agustinlezcano/PFE/Robot/Robot_Arm_MK2_Plus__Stepper_Motor_in_Used__2520572/README.txt

Robot Arm MK2 Plus (Stepper Motor in Used) by jackyltle on Thingiverse: https://www.thingiverse.com/thing:2520572
