agustinlezcano/PFE/Informe/PFE_Informe.pdf

img/FING.PNG

img/Escudo_uncuyo.jpg

## Proyecto Final de Estudios

## Ingeniería en Mecatronica ´

## Facultad de Ingeniería - Universidad Nacional de Cuyo

# Robot Paralelo Pick-and-Place con vision´ artificial para la preparacion de pedidos ´

## Director: Ing. Eric Sanchez

## Emanuel Agüero, Agustín Lezcano Mendoza, Argentina

## Agradecimientos

A nuestras familias y seres queridos, por acompanarnos en cada paso de este trayecto con ˜ paciencia y carino incondicional. ˜

A nuestros companeros y futuros colegas, con quienes transitamos aulas y pasillos. ˜

A nuestro Director de Proyecto, Eric Sanchez, por su generosa guía y por representar para nosotros un referente de integridad y vocacion profesional. ´

A la universidad publica, que nos brind ´ | o las herramientas y el espacio para formarnos como ´
profesionales al servicio de la sociedad.
A la Asociacion de Mecatr ´ | onica, que nos brind ´ | o un espacio para compartir ideas y aprender ´
entre companeros. ˜

## Resumen

Se desarrollo un sistema rob ´ | otico paralelo pick-and-place capaz de detectar y trasladar objetos ´
utilizando vision artificial. El proyecto integra cinem ´ | atica, control de movimiento, planificaci ´ | on de ´
trayectorias y un sistema de vision que identifica objetos en una cinta transportadora simulada. La ´
comunicacion entre los m ´ | odulos se implement ´ | o con ROS2, coordinando el procesamiento de visi ´ | on´
y el control del STM32.
Palabras clave: Robot paralelo, pick-and-place, cinematica, Denavit-Hartenberg, visi ´ | on artificial, ´
YOLOv11, ROS2.

## Abstract

A parallel pick-and-place robotic system capable of detecting and moving objects using artificial vision was developed. The project integrates kinematics, motion control, trajectory planning, and a vision system that identifies objects on a simulated conveyor belt. Communication between modules was implemented with ROS2, coordinating vision processing and STM32 control.

Keywords: Parallel robot, pick-and-place, kinematics, Denavit-Hartenberg, artificial vision, YO-LOv11, ROS2.

## Índice

1. Introduccion´ | 7
2. Objetivos | 7
3. Estado del arte | 8
4. Funcionamiento general | 9
5. Herramientas utilizadas en el proyecto | 10
6. Diagrama de conexiones | 11
7. Descripcion del hardware ´ | 12
8. Esquema tecnologico ´ | 15
9. Cinematica ´ | 16
10. Mejoras mecanicas ´ | 20
11. Circuito electronico del electroim ´ | an´ | 24
12. Vision artificial ´ | | 25

13. Desarrollo del Firmware | 31
14. Integracion de ROS, microROS y FreeRTOS en Sistemas Embebidos ´ | 36
15. Ensayos realizados | 44
16. Futuras mejoras | 57
17. Conclusiones | 59
18. Anexo | 61

## Índice de figuras

1. | Robots con vision artificial ´ | | | | 8
2. | Foto real del Robot | | 9
3. | Diagrama de conexiones | | 11
4. | Microcontrolador STM32 Núcleo | | 12
5. | Placa CNC Shield | | 12
6. | Driver DRV8825 con sus conexiones | | 13
7. | Modos de conexion para realizar micropasos ´ | | | | 13
8. | Modulo de encoder magn ´ | etico AS5600 ´ | | | 14
9. | Modulo de encoder magn ´ | etico AS5600 ´ | | | 15
10. Multiplexor I²C TCA9548A | | 15
11. Diagrama general | | 16
12. Referencias del metodo geom ´ | etrico ´ | | | 18
13. Esquema de eslabones simplificado | | 18
14. Dimensiones de interes para c ´ | alculo de ´ | q4 | | 19
15. Comparacion vista lateral de versi ´ | on con servo vs con motores Paso a Paso ´ | | | 20
16. Comparacion vista en perspectiva de versi ´ | on con servo vs con motores Paso a Paso ´ | 21
17. Alineamiento axial entre sensor AS5600 e iman montado sobre eje de articulaci ´ | on´ . | 24
18. Esquematico y placa electr ´ | onica de control del solenoide ´ | | | 25
19. Imagenes del dataset ´ | | | 26
20. Prediccion de modelo YOLOv11 ´ | | | 28
21. Curvas de resultado de inferencia de YOLOv11n | | 29
22. Esquema de posicion Robot-C ´ | amara-Objeto ´ | | | 31
23. Posiciones, velocidades y aceleraciones del parametro ´ | s | | 35
24. Posiciones, velocidades y aceleraciones articulares | | 35
25. Trayectoria en el espacio de trabajo interpolada con B-Spline | | 36
26. Grafico de nodos ROS ´ | | | 37
27. Mapa conceptual de las conexiones entre el orquestador y el esclavo | | 39
28. Diagrama de conexiones entre nodos | | 41
29. Flujo de datos en trayectorias | | 43
30. Espacio de trabajo teorico ´ | | | 47
31. Espacio de trabajo articular con restriccion´ z = 0 | | 47
32. Espacio de trabajo articular (Zoom) | | 48
33. Espacio de trabajo real, plano XZ | | 48
34. Ensayo de calibracion para obtener relaci ´ | on mm/px ´ | | | 49
35. Ensayo de deteccion de herramientas y posicionamiento respecto origen del robot ´ | . | 50
36. Comparacion de trayectorias real y te ´ | orica con sus respectivas ganancias ´ | | | 52
37. Errores de posicion con sus respectivas ganancias ´ | | | 53
38. Interfaz de usuario | | 55
39. Foto real del robot realizando pick-and-place | | 56
40. Triangulo general donde se aplica el Teorema del Coseno. ´ | | | 61
41. Funcionamiento de colas | | 62
42. Interfaces internas de ROS | | 63

## Índice de tablas

1. | Parametros Denavit-Hartenberg ´ | | | | | 16
2. | Frecuencias de PWM y velocidades en motores/eslabones | | 32
3. | Descripcion de t ´ | opicos m ´ | as relevantes ´ | | | 42
4. | Comparacion de m ´ | aximos valores absolutos de errores en la trayectoria respecto a ´ | Kp | 51
5. | Protocolo de inicio para el sistema distribuido ROS2 / microROS | | 54

Proyecto Final de Estudios, 2026

img/Escudo_uncuyo.jpg

1 | 1. Introduccion´
2 | El proyecto desarrollado consiste en el diseno e implementaci ˜ | on de un sistema rob ´ | otico paralelo ´
3 | para operativa pick-and-place, cuyo objetivo principal es trasladar objetos desde un punto inicial
4 | (A) hasta un punto final (B) a partir de su deteccion mediante t ´ | ecnicas de visi ´ | on artificial. El sistema ´
5 | esta orientado a manipular objetos que arriban desde lo que se simula ser una cinta transportadora, ´
6 | identificarlos dentro del espacio de trabajo y posicionarlos de manera precisa en un contenedor
7 | correspondiente a un pedido, simulando un flujo típico de procesos logísticos modernos.
8 | Para esto, se realizo la modificaci ´ | on estructural y funcional de un robot modelo MK2, reempla- ´
9 | zando sus servomotores originales por motores Paso a Paso en todas sus articulaciones, con el fin
10 | de mejorar la precision de posicionamiento y el control del movimiento. El efector final incorpora ´
11 | un electroiman que permite la sujeci ´ | on de piezas met ´ | alicas durante el ciclo operativo. ´
12 | El desarrollo abarca múltiples areas: la modificaci ´ | on estructural hacia motores Paso a Paso; ´
13 | el calculo de la cinem ´ | atica directa e inversa del manipulador; la integraci ´ | on y calibraci ´ | on de los ´
14 | motores; y la planificacion de trayectorias que permitan un movimiento suave, eficiente y seguro del ´
15 | robot. Asimismo, se integra un sistema de vision artificial basado en algoritmos de inferencia para ´
16 | la deteccion y localizaci ´ | on de objetos en el entorno. ´
17 | Finalmente, se implementa una arquitectura de comunicacion mediante ´ | ROS2, por medio de la
18 | cual se establecen nodos dedicados a la interaccion entre la computadora encargada del procesa- ´
19 | miento de vision y el env ´ | ío de consignas de posicion, y el microcontrolador STM32 responsable del ´
20 | control de los motores. Esta infraestructura permite el intercambio confiable de informacion entre ´
21 | los distintos modulos del sistema y constituye la base para la coordinaci ´ | on del proceso completo de ´
22 | manipulacion rob ´ | otica. ´
23 | 2. Objetivos
24 | Se busca llegar a un prototipo funcional, y que el sistema este modularizado de tal manera que ´
25 | el proyecto pueda ser continuado por otros alumnos interesados. Este desarrollo, enmarcado en el
26 | Proyecto Final de Estudios, se realizo con recursos del laboratorio ´ | Rosetta. (https://ingenieria.uncuyo.edu.ar/laboratorio-de-robotica-de-servicio-teleoperacion-y-tecnologias-aplicadas-rosetta)
27 | Tambien, a tener un software bien definido y robusto para que luego se pueda cambiar el robot, ´
28 | si así se desea, y el enfoque del trabajo sea en el hardware o en la parte mecanica, quitando el peso ´
29 | de realizar un trabajo desde cero. Los objetivos específicos se listan a continuacion: ´
30 | Implementacion y desarrollo del firmware de bajo nivel para el control de cada motor. ´
31 | | Desarrollo basado en la extensibilidad y flexibilidad del codigo para un posible desarrollo ´
32 | futuro.
33 | Utilizacion del protocolo MQTT para la comunicaci ´ | on entre usuarios y servidor, de manera ´
34 | | que se pueda expandir facilmente el número de usuarios del sistema. ´
35 | Integracion de los subsistemas de control y env ´ | ío/recepcion de consignas. ´
36 | Diseno de un algoritmo de Visi ˜ | on Artificial para la detecci ´ | on de objetos. ´
37 | | Posicionamiento para cumplir con los pedidos y confirmacion de tarea completada. ´

38 | 3. Estado del arte
39 | En los últimos anos, la integraci ˜ | on de visi ´ | on artificial en sistemas rob ´ | oticos industriales ha ´
40 | impulsado manipuladores mas aut ´ | onomos, precisos y adaptables, destac ´ | andose diversos desarrollos ´
41 | que han marcado el rumbo de esta tecnología, como se muestra en la Figura 1.
42 | Dex-Net (UC Berkeley) ha sido una de las referencias mas influyentes en el ´ | area. Su contri- ´
43 | bucion principal se basa en el uso de grandes bases de datos sint ´ | | | eticas para entrenar redes ´
44 | neuronales capaces de predecir puntos de agarre fiables incluso en objetos desconocidos. Es-
45 | te enfoque demostro que la simulaci ´ | on masiva combinada con ´ | deep learning puede ofrecer
46 | soluciones robustas para tareas de bin picking.
47 | DoraPicker (Dora Robotics) se orienta al ambito log ´ | ístico, integrando vision 3D y algoritmos ´
48 | de segmentacion para identificar y extraer objetos variados de estanter ´ | | | ías o contenedores. Su
49 | arquitectura evidencia la viabilidad de sistemas completamente autonomos para manipular ´
50 | productos de diferentes formas y tamanos. ˜
51 | Cartman, desarrollado para el Amazon Robotics Challenge, propone un diseno cartesiano ˜
52 | combinado con algoritmos de reconocimiento y planificacion eficientes. Su participaci ´ | on´
53 | demostro que una integraci ´ | on cuidadosa entre percepci ´ | on y mec ´ | anica puede mejorar la con- ´
54 | fiabilidad en la manipulacion de objetos desordenados o deformables. ´
55 | Cambrian Vision representa un enfoque industrial consolidado, ofreciendo modulos de visi ´ | on´
56 | 3D y algoritmos de IA listos para su incorporacion en l ´ | íneas de produccion. Su fortaleza est ´ | á
57 | en la deteccion r ´ | apida y la reducci ´ | on del tiempo de configuraci ´ | on por parte del operador. ´

img/robot1.png

(a) Robot Dex-Net

img/robot2.png

(b) Robot DoraPicker

img/robot3.png

(c) Robot Cartman

img/robot4.png

(d) Robot Cambrian Vision

Figura 1: Robots con vision artificial ´

58 | 4. Funcionamiento general
59 | El funcionamiento integral del sistema robotico desarrollado se basa en la interacci ´ | | on coordinada ´
60 | entre tres modulos principales: el sistema de visi ´ | on artificial, el orquestador, y el robot f ´ | ísico equipado
61 | con motores Paso a Paso (ver Figura 2). Cada uno de estos componentes cumple un rol esencial
62 | dentro del ciclo operativo del robot pick-and-place, permitiendo que el flujo completo (desde la
63 | deteccion del objeto hasta su deposici ´ | on final) se lleve a cabo de manera precisa, repetible y segura. ´

img/robot_real.jpg

Figura 2: Foto real del Robot

64 | En primer lugar, el proceso se inicia con la captura de imagenes de la zona de trabajo mediante ´
65 | una camara montada en una posici ´ | on fija y debidamente calibrada respecto al robot. Esta c ´ | amara ´
66 | observa el area donde los objetos -provenientes de una simulaci ´ | on de cinta transportadora- ingresan ´
67 | al campo visual. A partir de estas imagenes, un modelo de visi ´ | on artificial ejecuta un algoritmo de ´
68 | inferencia que identifica cada pieza de interes y determina la posici ´ | on bidimensional del centro de ´
69 | su bounding-box. Esta localizacion inicial se encuentra en coordenadas de imagen (p ´ | | íxeles), por lo
70 | que, mediante la utilizacion de un factor de conversi ´ | on mm/px obtenido en la etapa de calibraci ´ | on´
71 | geometrica, se transforma dicha posici ´ | on al sistema de referencia f ´ | ísico del robot. Adicionalmente,
72 | la altura (Z) del objeto se obtiene a partir de una base de datos que asocia cada categoría detectada
73 | con su correspondiente dimension real. ´
74 | Una vez determinada la ubicacion tridimensional del objeto, esta informaci ´ | on es transmitida ´

75 | al modulo de planificaci ´ | on de movimiento implementado sobre la computadora principal, donde ´
76 | existe un orquestador que utiliza microROS para enviar comandos de posicion al robot mediante ´
77 | comunicacion serial. Actualmente, se utiliza el env ´ | ío de consignas articulares, pero el robot es capaz
78 | de resolver la cinematica inversa y dar consigna a los motores. Adem ´ | as se env ´ | ían los comandos de
79 | homing y parada de emergencia.
80 | El microcontrolador es capaz de realizar los calculos de cinem ´ | atica directa e inversa del robot ´
81 | paralelo, permitiendo definir los angulos articulares requeridos para alcanzar tanto la posici ´ | on de ´
82 | recogida como la posicion final donde el objeto ser ´ | a depositado. Para garantizar movimientos suaves ´
83 | y evitar esfuerzos innecesarios sobre la estructura, cada articulacion sigue un perfil de velocidad que ´
84 | asegura aceleraciones y desaceleraciones controladas y limitadas a las velocidades y aceleraciones
85 | maximas de los motores. Este enfoque permite un desplazamiento eficiente, reduciendo vibraciones ´
86 | y mejorando la repetibilidad del posicionamiento.
87 | El control de los motores Paso a Paso se realiza a traves del microcontrolador STM32, el ´
88 | cual recibe las consignas articulares mediante nodos de comunicacion basados en ROS2. Esta ´
89 | arquitectura distribuida facilita el intercambio de mensajes entre los distintos modulos, desacoplando ´
90 | el procesamiento intensivo de vision del control de bajo nivel de los actuadores. El STM32 se ´
91 | encarga de generar las senales de paso y direcci ˜ | on, ejecutar los perfiles de velocidad y supervisar el ´
92 | cumplimiento temporal de cada trayectoria articulada.
93 | Finalmente, el efector final equipado con un electroiman realiza la sujeci ´ | on y liberaci ´ | on de las ´
94 | piezas metalicas durante el ciclo de trabajo. Una vez que el robot alcanza la posici ´ | | | on de destino, ´
95 | el sistema desactiva el electroiman para depositar el objeto en el contenedor asignado. Con esto ´
96 | concluye el ciclo operativo, tras lo cual el robot retorna a una posicion segura de espera, quedando ´
97 | preparado para procesar el siguiente objeto detectado.
98 | Se decidio utilizar ROS (Robot Operating System) en su versi ´ | on 2 debido a su amplia adopci ´ | on´
99 | tanto en el ambito acad ´ | emico como en la industria, donde se perfila como un est ´ | | andar de facto. Al ´
100 | tratarse de una plataforma open-source y multiplataforma, cuenta con una comunidad activa y extensa
101 | que garantiza su mantenimiento, evolucion y actualizaci ´ | on continua. Pese a su nombre, no es un ´
102 | sistema operativo sino un SDK (Software Development Kit). Este conjunto de librerías y herramientas
103 | proporciona una arquitectura altamente modular, permitiendo desarrollar componentes para distintas
104 | plataformas y en diversos lenguajes de programacion. Dado que ROS2 es agn ´ | ostico al lenguaje, el ´
105 | desarrollador puede concentrarse en la logica de aplicaci ´ | on, mientras que la infraestructura de ´
| comunicacion entre m ´ | odulos es gestionada de manera transparente por ROS2 ´

1
106 | .
107 | 5. Herramientas utilizadas en el proyecto
108 | Para el desarrollo integral del proyecto se emplearon un conjunto de herramientas de diseno, ˜
109 | hardware y software que permitieron abordar de manera coordinada los distintos aspectos mecanicos, ´
110 | electronicos y de control del sistema. ´
111 | Mecanica: ´ | El diseno estructural del robot se realiz ˜ | o principalmente en ´ | Solid Edge, donde
112 | se modelaron las piezas individuales y se verifico el ensamblaje completo del robot. Para el ´
113 | diseno espec ˜ | ífico de engranajes se utilizó Fusion 360 y OrcaSlicer como laminador de las
114 | piezas impresas en 3D.
115 | Hardware: El sistema de control se basa en el microcontrolador STM32F446RE, junto con
116 | una placa CNC Shield para el control de motores Paso a Paso. La medicion de posici ´ | on angular ´
1En el anexo 18.3 hay mas informaci ´ | on acerca de la infraestructura ROS ´

117 | en cada articulacion se realiz ´ | o mediante sensores magn ´ | eticos ´ | AS5600, conectados a traves de ´
un multiplexor I²
118 | C TCA9548A, permitiendo la lectura de múltiples dispositivos con una única
119 | interfaz de comunicacion. ´
120 | Software: La programacion del microcontrolador se desarroll ´ | o en ´ | STM32CubeIDE, donde
121 | se configuraron perifericos, temporizadores y tareas en tiempo real. El modelado y an ´ | | | | alisis ´
122 | cinematico inicial del robot, as ´ | í como la verificacion del espacio de trabajo, se llevaron a cabo ´
123 | en MATLAB. La implementacion de la cinem ´ | atica inversa, la planificaci ´ | on de trayectorias y la ´
124 | comunicacion mediante sockets con el m ´ | odulo de visi ´ | on se desarrollaron en ´ | Python, integrando
125 | estos procesos dentro del orquestador del sistema. Para la deteccion de piezas y determinaci ´ | on´
126 | del punto objetivo se utilizo el modelo ´ | YOLOv11n, entrenado con un dataset propio de piezas.
127 | El diseno de la placa electr ˜ | onica destinada al control del electroim ´ | an se realiz ´ | o en ´ | KiCad,
128 | incluyendo el esquematico y el ruteo de la PCB. Por último, se emple ´ | ó microROS, que corre
129 | sobre FreeRTOS, el sistema operativo en tiempo real sobre el microcontrolador. Tambien del ´
130 | lado de la computadora, se tiene a ROS2, que actuo como orquestador general del proyecto y ´
131 | permitio estructurar la comunicaci ´ | on entre los distintos m ´ | odulos del sistema. ´
132 | 6. Diagrama de conexiones
133 | El sistema se encuentra compuesto por una placa de desarrollo STM32F446RE, sobre la que
134 | se encuentra montada una CNC Shield para la conexion de drivers ´ | DRV8825 de 3 motores Paso a
135 | Paso, 3 sensores AS5600 para la medicion de ´ | angulos absolutos mediante efecto Hall, un multiplexor ´
TCA9548A que permite gestionar múltiples dispositivos I²
136 | | | C con direcciones identicas en un mismo ´
137 | bus, y una placa electronica propia que permite la alimentaci ´ | on segura hacia el electroim ´ | an. ´
138 | En la Figura 3 se puede observar el diagrama de conexiones con todos los elementos mencionados.
139 | Cabe aclarar que la placa electronica para el accionamiento del electroim ´ | an se ha representado con ´
140 | un transistor NPN.

img/DiagramaConex.png

Figura 3: Diagrama de conexiones

141 | 7. Descripcion del hardware ´
142 | 7.1. Microcontrolador STM32F446RE
143 | La placa Nucleo-F446RE (ver Figura 4) incorpora el microcontrolador STM32F446RE de 32
144 | bits, basado en arquitectura ARM Cortex-M4 de hasta 180 MHz, con 512 KB de memoria Flash
145 | y 128 KB de SRAM. Esta placa ofrece una amplia disponibilidad de perifericos de comunicaci ´ | on´
(UART, SPI, I²
146 | C, CAN) y una distribucion de pines compatible con el formato Arduino, lo que ´
147 | facilita la integracion con expansiones como la ´ | CNC Shield. El microcontrolador se encarga de la
generacion de se ´ | nales PWM, la lectura de sensores por I ˜

2
148 | C, y la gestion del sistema de control. ´

img/STM32NUCLEO.jpg

Figura 4: Microcontrolador STM32 Núcleo

149 | 7.2. CNC Shield
150 | La CNC Shield (ver Figura 5) utilizada es una expansion dise ´ | nada originalmente para placas ˜
151 | Arduino UNO, pero resulta compatible con la placa Nucleo-F446RE gracias a su distribucion de ´
152 | pines y niveles logicos de 3.3 V – 5 V. Esta placa permite la conexi ´ | on directa de drivers de motores ´
153 | Paso a Paso, ofreciendo pines dedicados para STEP, DIR, y EN. Ademas, dispone de bornes para ´
154 | alimentacion externa, jumpers para configuraci ´ | on de micropasos, y conectores auxiliares para finales ´
155 | de carrera. De esta forma, el STM32 puede controlar varios motores Paso a Paso mediante salidas
156 | digitales dedicadas, sin necesidad de circuitos adicionales.

img/cnc_shield.jpg

Figura 5: Placa CNC Shield

157 | 7.3. Driver de motores
158 | El modulo ´ | DRV8825 (ver Figura 6a) se utiliza como driver para el control de motores Paso
159 | a Paso bipolares desde el STM32. Este dispositivo integra la electronica necesaria para generar ´
160 | las secuencias de corriente requeridas por las bobinas del motor, permitiendo controlar tanto la
161 | direccion de giro como el avance por pasos mediante dos se ´ | nales digitales de entrada: ˜ | DIR y STEP,
162 | respectivamente. Incorpora un regulador de corriente ajustable mediante un potenciometro integrado, ´
163 | que permite limitar la corriente maxima por fase del motor, protegiendo al mismo y al driver ante ´
164 | sobrecorrientes. Para determinar el valor de corriente maxima por bobina ( ´ | Imax), se debe medir con
165 | un voltímetro la tension de referencia ´ | Vre f entre el terminal del potenciometro y masa ( ´ | GND), y luego
166 | aplicar la relacion aproximada: ´
Imax = 2 · Vre f | (1)
167 | Esta ecuacion constituye una aproximaci ´ | on útil para el dimensionamiento inicial, aunque el valor ´
168 | real puede variar ligeramente según tolerancias y condiciones de operacion. ´
169 | La conexion general del ´ | DRV8825 con el sistema se muestra en la Figura 6b, donde se detallan
170 | las entradas de control, las salidas hacia el motor y la alimentacion. Asimismo, en la Figura ´ | 7 se
171 | ilustran las configuraciones de los pines MODE0, MODE1 y MODE2 que permiten seleccionar el modo
172 | de micropaso deseado. Para este proyecto se conectaron los pines MODE0 y MODE1 al voltaje de
173 | alimentacion del microcontrolador para activar el modo de 1/8 de paso. ´

img/drv8825.jpg

(a) Driver DRV8825

img/drv8825conections.png

(b) Conexiones DRV8825

Figura 6: Driver DRV8825 con sus conexiones

img/drv8825_modes.jpg

Figura 7: Modos de conexion para realizar micropasos ´

174 | 7.4. Sensor de angulo ´
175 | Para la medicion del ´ | angulo de cada eslab ´ | on se seleccion ´ | o el sensor ´ | AS5600 (ver Figura 8).
176 | Este dispositivo corresponde a un sensor de posicion angular sin contacto, basado en el principio ´
177 | de deteccion del campo magn ´ | etico generado por un im ´ | an colocado sobre el eje de rotaci ´ | on. El ´
178 | sensor determina la orientacion del campo magn ´ | etico y entrega la posici ´ | on angular absoluta con ´
179 | una resolucion de 12 bits, equivalente a 4096 pasos por revoluci ´ | on. La elecci ´ | on de este sensor se ´
baso en su alta resoluci ´ | on, facilidad de lectura mediante el bus I ´

2
180 | | | | | C y buena inmunidad al ruido
181 | electromagnetico. ´

img/AS5600.png

Figura 8: Modulo de encoder magn ´ | etico AS5600 ´
182 | Sus principales características son:
Resolucion: ´ | 12 bits (4096 pasos/rev), equivalente a aproximadamente 0,0879◦
183 | /paso

Rango angular: programable; por defecto cubre 0–360◦
184 | . Se puede configurar el angulo ´
185 | maximo ( ´ | MANG) y la posicion cero ( ´ | ZPOS)
186 | Interfaces:
- I
2
187 | C con direccion fija de 7 bits ´ | 0x36.
188 | • Salida PWM, donde el ciclo de trabajo representa el angulo medido (frecuencia configu- ´
189 | rable por registro)

Velocidad del bus I²
190 | C: hasta 400 kHz
191 | En el montaje de los ejes se instalo un im ´ | an de neodimio en el extremo de cada eje, ubicado ´
frente al sensor AS5600 de manera centrada. Se opto por utilizar el protocolo I ´

2
192 | C por la fiabilidad
193 | en la medicion y velocidad del bus. El valor angular bruto ( ´ | raw) entregado por el modulo a trav ´ | es´
de I²
194 | C varía entre 0 y 4095, representando el rango completo de 0° a 360° de manera proporcional.
195 | El registro de salida de angulo est ´ | a compuesto por dos bytes ( ´ | MSB y LSB) que conforman el valor
196 | digital de 12 bits. El calculo del ´ | angulo en grados se obtiene mediante la expresi ´ | on: ´

angle deg =

raw
4096

× 360◦ ≈ raw × 0,0879◦
(2)
197 | donde raw ∈ [0, 4095] corresponde al valor digital leído del registro de salida.
198 | En la Figura 9 se observa una representacion esquem ´ | atica del im ´ | an con sus polos (Norte y ´
Sur) frente al sensor. Puede observarse que para un angulo de 0 ´

◦
199 | el sensor entrega un valor de

RAW ANGLE = 0, para 90◦

el valor es RAW ANGLE = 1024, para 180◦
200 | | RAW ANGLE = 2048, y para
| 270◦ RAW ANGLE = 3072. Cabe destacar que 360◦

coincide con 0◦

| | , y que las posiciones 0◦–180◦
201 | y
90◦–270◦
202 | presentan polaridades magneticas invertidas, evitando as ´ | í ambigüedades en la deteccion´
203 | de posicion. ´

img/AS5600_polos_magneticos.png

Figura 9: Modulo de encoder magn ´ | etico AS5600 ´
204 | 7.5. Multiplexor I2C TCA9548A
| El TCA9548A (ver Figura 10) es un multiplexor I²
205 | C de 8 canales independientes que permite
| conectar hasta ocho dispositivos I²
206 | C con direcciones repetidas, seleccionando el canal activo me-
207 | diante comandos enviados desde el microcontrolador principal. Cada canal actúa como una línea
I

2
208 | C aislada (SDA y SCL), evitando conflictos de direccion entre sensores id ´ | enticos como el AS5600. ´
| El STM32 se comunica con el TCA9548A mediante su interfaz I²
209 | | C principal, y activa cada canal
210 | según el sensor que se desea leer. Este componente amplía la escalabilidad del sistema, permitiendo
211 | el uso de múltiples sensores sin modificar el hardware base.

img/tca9548a.jpg

Figura 10: Multiplexor I²C TCA9548A

212 | 8. Esquema tecnologico ´
213 | En la Figura 11 se presenta un diagrama general simplificado que presenta los modulos principales ´
214 | del sistema robotico: el de visi ´ | on, el orquestador (que hace uso de la informaci ´ | on del m ´ | odulo de ´
215 | vision) y el brazo rob ´ | otico (que recibe las instrucciones de alto nivel del orquestador y realiza el ´
216 | control a bajo nivel).

img/arquitecturaGralPfe.png

Figura 11: Diagrama general

217 | 9. Cinematica ´
218 | A continuacion se presenta la resoluci ´ | on de los problemas de cinem ´ | atica, fundamentales para ´
219 | poder traducir las consignas en angulos de giro para los motores. Esto se logra mediante la cinem ´ | atica ´
220 | inversa, es decir que se pasa del espacio de trabajo al espacio articular. Para mas profundidad al ´
221 | respecto, se pueden consultar las siguientes referencias: [Barrientos et al., 2007], [Craig, 2006],
222 | [Corke, 2017], [Mark W. Spong, 2005], [Torres et al., 2002].
223 | 9.1. Denavit-Hartenberg
224 | Teniendo en cuenta las dimensiones del robot, se describio la morfolog ´ | ía del mismo siguiendo
225 | la convencion Denavit-Hartenberg. Como resultado, se simplifica la estructura dividiendo al brazo ´
226 | en eslabones (obteniendo la Tabla 1), y se resuelve el problema de la cinematica directa a trav ´ | es´
227 | de transformaciones homogeneas. Para esto se tuvieron en cuenta los eslabones activos; adem ´ | as se ´
228 | considero un eslab ´ | on que actúa como articulaci ´ | on o grado de libertad virtual con el fin de simplificar ´
229 | los calculos (se ver ´ | a el desarrollo en la secci ´ | on´ 9.3). Un desarrollo similar que puede ser consultado
230 | en [Zhou et al., 2020]. La ventaja de usar el metodo Denavit-Hartenberg es que permite simplificar ´
231 | el cambio de posicion y orientaci ´ | on de un punto a otro en una concatenaci ´ | on de movimientos de ´
232 | traslacion y rotaci ´ | on (dos rotaciones y dos traslaciones para cada desplazamiento desde un punto de ´
233 | origen a otro, en el sistema de referencia elegido).
θ | d | a | α
q1 | L1 | 0 | π/2
q2 | 0 | L2 | 0
q3 | 0 | L3 | 0
q4 | 0 | L4 | 0

Tabla 1: Parametros Denavit-Hartenberg ´

234 | 9.2. Cinematica directa ´
235 | Cada “desplazamiento” entre el origen de un sistema de referencia y otro del eslabon siguiente ´
236 | se puede representar mediante una matriz de transformacion homog ´ | enea. ´

i−1Ti = Rot(zi−1, θi) · Tras(zi−1, di) · Tras(xi , ai) · Rot(xi

, αi) | (3)

237 | A su vez, considerando el origen del primer sistema de referencia y el del último (que puede
238 | coincidir con un extremo del robot, donde ira colocada la herramienta de ser necesario), se puede ´
239 | relacionar en el desplazamiento del punto de origen del sistema de referencia al extremo, siguiendo
240 | la formula siguiente: ´

baseTextremo =

base T1 ·

1 T2 · . . . ·

n−1 Tn ·
| | | n Textremo | (4)
241 | 9.3. Cinematica inversa ´
242 | El robot de este proyecto, es de tipo paralelo o de cadena cinematica cerrada. Para la resoluci ´ | on´
243 | de la cinematica inversa, se ha optado por hacer una simplificaci ´ | on y considerar al mismo como ´
244 | cadena cinematica abierta. Como se menciona en la Secci ´ | on´ 9.1, se considera un eslabon virtual. ´
245 | Esta articulacion siempre mantiene la horizontalidad o paralelismo respecto al plano XY sobre el que ´
246 | esta apoyada la base del robot, siempre que el robot se encuentre dentro del espacio de trabajo. Los ´
247 | eslabones pasivos o conducidos se pueden calcular de manera similar, pero no inciden en los calculos ´
248 | para la cinematica inversa. Dado el funcionamiento del robot y para hacer una simplificaci ´ | | | on en los ´
249 | calculos, solo se considera la posici ´ | on del efector final, no la orientaci ´ | on. ´
250 | Se nombran las articulaciones tales como se indican en la Figura12a. Otra cosa a destacar es que
251 | no todas las articulaciones se mueven de manera directa, sino que algunas de ellas son conducidas,
252 | por ejemplo la articulacion 4 depende de los movimientos de las articulaciones anteriores, y la ´
253 | articulacion pasiva 3, depende del movimiento de la articulaci ´ | on activa 3’. Aqu ´ | í se considero que ´
254 | el eslabon 3 comienza en la intersecci ´ | on con el extremo final del eslab ´ | on 2, evitando a ´ | nadir a los ˜
255 | calculos el eslab ´ | on activo y el pasivo vinculados. Se puede ver un detalle de esto en la Figura ´ | 13.
256 | Dadas las limitaciones de movimiento (límites articulares) y la configuracion del robot, que tiene ´
257 | restricciones físicas debido a la cadena cerrada, se llega a tener una única solucion posible para un ´
258 | punto objetivo en el espacio, que es “codo arriba”.
259 | Otra aclaracion es que los ´ | angulos ´ | qi obtenidos no representan los angulos de giro de sus ´
260 | respectivos motores (a excepcion del eslab ´ | on 1), aunque se puede llegar al valor de los mismos ´
261 | facilmente. Se los representar ´ | a con ´ | α y β. Una vez hechas las consideraciones previas, se pasa
262 | a hacer la representacion de los par ´ | ametros Denavit-Hartenberg (ver Tabla ´ | 1). Para la resolucion´
263 | del problema de cinematica inversa, se utiliza el m ´ | etodo geom ´ | etrico. Se considera la estrategia de ´
264 | desacople cinematico [ ´ | Pieper, 1968]. En otras palabras, se separa “brazo” de “muneca”. El m ˜ | etodo ´
265 | utilizado es una adaptacion ya que este m ´ | etodo es v ´ | alido para robots de 6 grados de libertad. Teniendo ´
266 | en cuenta el desacople mencionado anteriormente, se refiere a la posicion de la mu ´ | neca referida a la ˜
267 | posicion del extremo del robot, menos la distancia del eslab ´ | on´ L4 con valor absoluto L4 y orientacion´
268 | x®4. Las variables articulares se indican con qi (i =1,2,3) y corresponden a los eslabones 1, 2 y 3
269 | correspondientes.
| | PM = PF − L4 · ®x4 | | (5)
270 | El primer angulo se obtiene de manera directa según la proyecci ´ | on sobre el eje XY (v ´ | ease Figura ´ | 12b):
| | q1 = arctan 0YM
| | 0XM
| | | | (6)

d =

√︃
1XM

2
+ 1YM

2
(7)

B = arctan

0XM

0YM

(8)

img/esquemaRobot2.png

(a)

img/esquemaRobot3.png

(b)

Figura 12: Referencias del metodo geom ´ | etrico ´
271 | Por el teorema del coseno, si se tienen las longitudes de los eslabones se puede determinar
272 | el angulo entre el eslab ´ | on´ L2 y el vector d que representa la distancia entre PM y el sistema de
273 | referencia 1. Con estos valores se puede calcular el valor de la variable articular q2. Como se indicó
274 | previamente, se elige la disposicion “codo arriba”. ´
| | L3 2 = d 2 + L2
2 − 2 · d · L2 · cos (C) | (9)

C = arc cos
d

2 + L2

2 − L3

2

2 · d · L2

(10)
q2 = B ± C | (11)

img/esquemaRobot1.png

Figura 13: Esquema de eslabones simplificado

275 | Tomando el mismo triangulo generado entre el vector distancia ´ | d, L2 y L3, y haciendo uso del
276 | teorema del coseno, se puede determinar el angulo ´ | ψ, y con este obtener q3.
| d 2 = L2 2 + L3
2 − 2 · L2 · L3 cos (ψ) | (12)
| ψ = arc cos
L2
| | 2 + L3 2 − d
| | 2
| | 2 · L2 · L3
| | (13)
q3 = π − ψ | (14)
277 | Para obtener la posicion del extremo final, se usa el eslab ´ | on´ L4 y se considera un grado de
278 | libertad ficticio, q4, el cual se obtiene de manera similar a las variables articulares anteriores (ver
279 | Figura 14). Para encontrar el vector r que representa la distancia entre el extremo del eslabon 2 y ´
280 | PF, se resuelve algebraicamente:
| 0T1 · 1T2 · 2T3 · 3T4 =

0T4 ⇒ 2PF = (

| | 0T1 · 1T2) −1 ·
0T4 | (15)

r

2 = L3

2 + L4

2 − 2 · L3 · L4 · cos (γ) | (16)

γ = arc cos
L3

2 + L4

2 − r
2

2 · L3 · L4

| (17)
q4 = π − γ | (18)

img/esquemaRobot4.png

Figura 14: Dimensiones de interes para c ´ | alculo de ´ | q4
281 | Cabe destacar que las variables articulares representan de manera teorica los ´ | angulos sucesivos ´
282 | que deben tener los eslabones entre si. Dadas las características constructivas del robot, los angulos ´
283 | de giro de cada motor se calculan de la siguiente manera:
q1m = q1 | (19)

q2m =

π
2
− q2 | (20)
q3m = −(q2 + q3) | (21)

284 | 10. Mejoras mecanicas ´
285 | Durante la elaboracion del proyecto, se fueron realizando distintas pruebas de manera iterativa, ´
286 | y se llego a la conclusi ´ | on de que para que el robot pueda cumplir con las consignas de manera ´
287 | correcta, deberían hacerse adaptaciones.
288 | 10.1. Descripcion general ´
289 | Se reemplazaron los servomotores MG996R que poseía originalmente por motores Paso a Paso
290 | en las articulaciones 2 y 3 del Robot. La articulacion 1 (base) ya contaba con un motor Paso a ´
291 | Paso previamente instalado pero era accionada mediante una correa tipo GT2. En la nueva version, ´
292 | se disenaron pares de engranajes de transmisi ˜ | on para cada articulaci ´ | on. Para la base se emple ´ | o un ´
293 | modulo de transmisi ´ | on´ m = 1. Para las articulaciones 2 y 3 se seleccionó m = 1,5 con el fin de
294 | aumentar el tamano de de los dientes, mejorando as ˜ | í el contacto entre engranajes. Esto permite una
295 | transmision de carga m ´ | as robusta y reduce la probabilidad de deslizamientos o p ´ | erdida de pasos bajo ´
296 | esfuerzo. Estas mejoras se pueden ver en las Figuras 15 y 16.
img/Robot1CompletoVL.png | img/Robot2CompletoVL.png
Figura 15: Comparacion vista lateral de versi ´ | on con servo vs con motores Paso a Paso ´

img/Robot1CompletoVP.png | img/Robot2CompletoVP.png
Figura 16: Comparacion vista en perspectiva de versi ´ | on con servo vs con motores Paso a Paso ´
297 | 10.2. Datos de diseno y conteo de dientes ˜
298 | Los pares de ruedas dentadas definidos son:
299 | Base (articulacion 1): ´ | engranaje de la articulacion´ za1 = 108 dientes; engranaje del motor
300 | zm1 = 19 dientes; modulo ´ | m1 = 1.
301 | Articulaciones 2 y 3: engranaje de la articulacion´ za2 = za3 = 32 dientes; engranaje del motor
302 | zm2 = zm3 = 12 dientes; modulo ´ | m2 = m3 = 1,5.
303 | Para referencia, el diametro primitivo de un pi ´ | nõn/rueda se calcula como: ´
D = m · z | (22)
304 | donde D es el diametro primitivo (en mm), ´ | m el modulo (mm) y ´ | z el número de dientes.
305 | Aplicando la relacion anterior se obtienen los di ´ | ametros primitivos: ´
(
Dm1 | = m1 · zm1 = 1 × 19 = 19 mm
Da1 | = m1 · za1 = 1 × 108 = 108 mm

(23)
(
Dm2 | = m2 · zm2 = 1,5 × 12 = 18 mm
Da2 | = m2 · za2 = 1,5 × 32 = 48 mm

(24)
(
Dm3 | = m3 · zm3 = 1,5 × 12 = 18 mm
Da3 | = m3 · za3 = 1,5 × 32 = 48 mm

(25)

306 | 10.3. Condicion de distancia entre ejes ´
307 | El proceso de calculo de engranajes y pruebas fue iterativo, pero la base del robot ya se encontraba ´
308 | disenada. Para no cambiar el dise ˜ | no 3D de la base, se impuso la restricci ˜ | on de que la distancia entre ´
309 | ejes para las articulaciones 2 y 3 es igual a 33 mm. La suma de los radios primitivos debe cumplir:
rm + ra = distancia entre ejes | (26)
310 | Considerando a rm y ra como los radios de Dm y Da respectivamente. Expresado en funcion de ´
311 | los diametros, la ecuaci ´ | on queda: ´
Dm + Da = 2 × distancia entre ejes | (27)
312 | para el caso de las articulaciones 2 y 3 se verifica:
Dm2 + Da2 = Dm3 + Da3 = 18 + 48 = 66 mm | ⇒ | distancia entre ejes = 33 mm | (28)
313 | Este resultado explica por que la combinaci ´ | on´ m2 = m3 = 1,5, zm2 = zm3 = 12 y za2 = za3 = 32
314 | fue elegida: satisface exactamente la restriccion geom ´ | etrica impuesta por el ensamble y adem ´ | as da ´
315 | números de dientes enteros. El calculo se realiz ´ | o de manera iterativa (búsqueda de pares ´ | (zm, za)
316 | para que sean números enteros compatibles con Dm + Da = 66 mm) hasta encontrar combinaciones
317 | practicas que cumplieran con los requisitos geom ´ | etricos y de relaci ´ | on de transmisi ´ | on. ´
318 | Para la base, con m1 = 1 se tiene:
Dm1 + Da1 = 19 + 108 = 127 mm | ⇒ | distancia entre ejes (base) = 63,5 mm | (29)
319 | A diferencia de las articulaciones 2 y 3, en la base del robot no fue necesario realizar un
320 | proceso iterativo para ajustar la relacion de engranajes con el objetivo de agrandar los dientes del ´
321 | mismo. Esto se debe a que la fuerza peso del robot no es transmitida a traves de los dientes del ´
322 | engranaje de la base, sino que es soportada estructuralmente por los elementos mecanicos. En ´
323 | consecuencia, el dimensionamiento del tren de engranajes no estuvo condicionado por esfuerzos
324 | verticales significativos, permitiendo adoptar directamente un modulo de ´ | m1 = 1, el cual satisface
325 | adecuadamente la distancia entre ejes requerida de 63,5 mm.
326 | 10.4. Relaciones de transmision y resoluci ´ | on angular ´
327 | La relacion de transmisi ´ | on (reductor) entre motor y articulaci ´ | on se obtiene por ´

i =

za

zm

(30)

328 Para los pares disenados: ˜
(
i1 =

108
19 ≈ 5,6842

i2 = i3 =

32
12 =

8/3≈ 2,6667

(31)

Si el motor Paso a Paso presenta un angulo de avance por paso completo igual a ´ | θstep = 1,8

◦
329 | (por
330 | ejemplo, en motores de 200 pasos por revolucion), entonces el incremento angular que experimenta ´
331 | la articulacion por cada paso del motor viene dado por: ´

θout =

θste p

i

(32)

332 Reemplazando los respectivos valores:
(
θout1 | =

1,8

◦
5,6842 ≈ 0,3167◦ por paso del motor 1
θout2 | = θout3 =

1,8

◦
2,6667 ≈ 0,6750◦ por paso de motores 2 y 3

(33)

333 | Para mejorar la resolucion del sistema de accionamiento, se implement ´ | ó micropaso de 1/8 en los
334 | motores. Bajo este esquema, el angulo por micropaso est ´ | a dado por: ´

θmicrostep =

1,8

◦
8

= 0,225◦
(34)
335 | Dada una relacion de reducci ´ | on´ i, el incremento angular de cada articulacion por micropaso del ´
336 | motor es:

θout =

θmicrostep

i

(35)

337 Por lo tanto, para las tres articulaciones del robot:
(
θout1 | =

0,225◦
5,6842 ≈ 0,0396◦
θout2 | = θout3 =

0,225◦
2,6667 ≈ 0,0843◦

(36)

338 | El número total de micropasos por revolucion del motor pas ´ | o a ser: ´
Nmicroste ps per rev = 200 × 8 = 1600 | (37)
339 | 10.5. Sensado de angulos ´
340 | Para la medicion de la posici ´ | on angular en las articulaciones se incorporaron sensores magn ´ | eticos ´
341 | AS5600, ubicados enfrentados a los engranajes correspondientes. Cada sensor funciona en conjunto
342 | con un iman de neodimio que se encuentra acoplado mec ´ | anicamente al eje del propio engranaje, de ´
343 | modo que la rotacion del conjunto se traduzca directamente en la variaci ´ | on del campo magn ´ | etico ´
344 | percibido por el sensor. El angulo medido es relativo, por lo tanto requiere de una meticulosa ´
345 | calibracion que permita tener una referencia consistente respecto a los ejes del robot y garantizar ´
346 | mediciones precisas.
347 | El principio de funcionamiento del AS5600 se basa en la deteccion de la orientaci ´ | on del campo ´
348 | magnetico generado por el im ´ | an. Para garantizar una lectura estable, lineal y precisa, el ´ | datasheet
349 | especifica que la separacion axial entre el sensor y el im ´ | an debe mantenerse dentro del rango ´
350 | recomendado de [0,5; 3] mm., ademas admite un desalineamiento axial de 0 ´ | | | ,25mm. Fuera de este
351 | intervalo pueden presentarse errores de medicion, p ´ | erdida de resoluci ´ | on o incluso la imposibilidad ´
352 | de detectar correctamente el campo magnetico. ´
353 | Entonces, durante el montaje se presto especial atenci ´ | on a la alineaci ´ | on del im ´ | an con el centro ´
354 | del chip y al control de la distancia sensor–iman, asegurando que ambos par ´ | ametros se mantuvieran ´
355 | dentro de las tolerancias indicadas por el fabricante. Como se puede observar en la Figura 17, se
356 | disenõ una pieza que fue capaz de posicionar el sensor centrado respecto al im ´ | an. Su dise ´ | no permite ˜
357 | absorber pequenos desplazamientos generados por las tolerancias que manejan las piezas (impresas ˜
358 | en 3D) y los movimientos relativos al conjunto iman-sensor. Esto permiti ´ | o obtener una se ´ | nal angular ˜
359 | confiable, que es una condicion fundamental para el control preciso de las articulaciones. ´

img/resorte.png

Figura 17: Alineamiento axial entre sensor AS5600 e iman montado sobre eje de articulaci ´ | on´
360 | 10.6. Cambios en el modelado cinematico ´
361 | Dado que se conservaron las longitudes de los eslabones principales, la matriz de parametros ´
362 | Denavit–Hartenberg del robot no sufrio grandes modificaciones salvo por el primer par ´ | ametro de la ´
363 | primera articulacion (desplazamiento a lo largo del eje ´ | z). En terminos pr ´ | acticos: ´
Los parametros ´ | {ai
, αi

, di

364 | , θi} permanecieron invariantes para los eslabones superiores salvo
365 | por d1 (altura de la articulacion 1 a lo largo del eje ´ | z) que se ajusta para reflejar la nueva
366 | geometría del alojamiento y la interfase entre la base y el primer engranaje.
367 | Esto implica que las transformaciones homogeneas y la cinem ´ | atica directa/inversa se conser- ´
368 | varon esencialmente, siendo necesario únicamente actualizar el parametro afectado y volver a ´
369 | validar la cinematica num ´ | erica. ´
370 | 11. Circuito electronico del electroim ´ | an´
371 | Se evaluaron dos opciones de conmutacion: transistor NPN y MOSFET de canal N. Teniendo ´
372 | la resistencia de la bobina medida (123,5Ω) y sabiendo que se la va a alimentar con 12V, por Ley
de Ohm la corriente de trabajo es 12V
123,5Ω
373 | ≈ 97mA, la cual es reducida para los dos componentes
374 | propuestos, por lo que ambas soluciones son realizables. Sin embargo, por criterios de eficiencia,
375 | escalabilidad y fiabilidad, se opto por utilizar MOSFET de canal N. ´
376 | Como se tuvo a disposicion un MOSFET no-logic-level, es decir, con un voltaje Gate-Source ´
377 | VGS > 5V y el nivel logico de salida del STM32 es de 3 ´ | ,3V, fue necesario utilizar un transistor
378 | como level-shifter/pull-down. De esta manera, se llevo la Gate del MOSFET a 12 V para garantizar ´
379 | conduccion plena ( ´ | VGS ≈ 12V). Esta solucion invirti ´ | o la l ´ | ogica de la se ´ | nal (el electroim ˜ | an se ´
380 | enciende con una salida logica en ´ | LOW), pero evito la limitaci ´ | on de 3 ´ | ,3V del STM32 sin necesidad

381 | de drivers dedicados. El circuito actúa como una etapa de conmutacion de potencia controlada por el ´
382 | microcontrolador: cuando la salida digital del STM32 conmuta, el transistor NPN modula el voltaje
383 | en la compuerta del MOSFET, saturandolo o bloque ´ | andolo según el nivel l ´ | ogico. El transistor se ´
384 | satura con una salida logica en ´ | LOW y se bloquea con una salida logica en ´ | HIGH. De este modo,
385 | el MOSFET conmuta la alimentacion del electroim ´ | an, permitiendo su activaci ´ | on o desactivaci ´ | on´
386 | desde la senal de control. ˜
387 | Se desarrollo una placa electr ´ | onica para controlar la alimentaci ´ | on del electroim ´ | an, acorde al ´
388 | diagrama esquematico de la Figura ´ | 18a. Se agrego un diodo flyback en paralelo al mismo y en ´
389 | polarizacion inversa para proteger los componentes electr ´ | onicos de los picos de voltaje generados ´
390 | por el colapso del campo magnetico cuando se desenergiza. El diodo ofrece un camino de baja ´
391 | impedancia para la corriente inducida, disipandola de manera segura y previniendo da ´ | nos a otros ˜
392 | componentes sensibles como el MOSFET. Puede observarse en la Figura 18b la placa electronica ´
393 | en 3D.

img/PCB_schematic.png

(a)

img/PCB_3D.png

(b)

Figura 18: Esquematico y placa electr ´ | onica de control del solenoide ´
394 | 12. Vision artificial ´
395 | Para la deteccion autom ´ | atica de objetos se emple ´ | o un modelo basado en ´ | YOLOv11n (You Only
396 | Look Once, version 11 nano), desarrollado por Ultralytics. Este modelo se caracteriza por su equili- ´
397 | brio entre precision y velocidad, siendo ampliamente utilizado en tareas de visi ´ | | | on artificial en tiempo ´
398 | real. YOLOv11 realiza la deteccion de objetos mediante una red neuronal convolucional que procesa ´
399 | una imagen completa en una sola pasada, dividiendola en celdas que predicen simult ´ | aneamente las ´
400 | coordenadas de los objetos y sus respectivas probabilidades de pertenencia a una clase.

401 | 12.1. Dataset y entrenamiento
402 | Se genero un dataset propio con las siguientes categor ´ | ías:
403 | Llave fija.
404 | Llave tubo.
405 | Mecha.
406 | Tornillo.
407 | Tuerca.
408 | Resorte.
409 | Rodamiento.
410 | Punta de destornillador.
411 | La eleccion de estas piezas se fundamenta en que son piezas met ´ | alicas, de un tama ´ | no y peso ˜
412 | adecuado que es soportado por el electroiman. Adem ´ | as, otro aspecto importante es que son piezas ´
413 | simetricas, considerando un eje longitudinal y uno transversal. Esto último, aporta al hecho de que al ´
414 | reconocer el objeto dentro de la imagen capturada de una vista superior, el centro de la bounding-box
415 | de los objetos coincidira con mucha precisi ´ | on con el centro de gravedad del objeto. De esta manera, ´
416 | asumiendo esta simplificacion, se facilita encontrar el punto por el que debe sujetar el electroim ´ | an´
417 | a las piezas en cuestion. Se puede observar en la Figura ´ | 19 algunas imagenes que forman parte del ´
418 | dataset.
img/dataset1.jpg | img/dataset2.jpg
img/dataset3.jpg | img/dataset4.jpg

Figura 19: Imagenes del dataset ´

419 | 12.2. Preparacion del dataset ´
420 | Captura de imagenes: ´ | el conjunto de datos (dataset) fue elaborado con imagenes capturadas ´
421 | de las herramientas a detectar en distintas condiciones de iluminacion, distancia y orientaci ´ | on, ´
422 | de modo que el modelo pueda generalizar adecuadamente ante variaciones del entorno.
423 | Etiquetado: cada imagen fue anotada manualmente usando una herramienta llamada Label-
424 | Studio, el cual es un software Open-Source de etiquetado de datos. Una vez terminado se
425 | exporto empleando el formato ´ | YOLO, el cual asocia a cada objeto detectado una etiqueta que
426 | incluye su clase y las coordenadas normalizadas del cuadro delimitador (bounding-box).
427 | Entrenamiento y validacion: ´ | Los archivos de anotacion se organizaron junto a las im ´ | agenes ´
428 | dentro de una estructura de directorios compatible con YOLOv11, y se definio un archivo ´
429 | data.yaml donde se especifican las rutas a las carpetas de entrenamiento y validacion, as ´ | í
430 | como los nombres de las clases. Posteriormente, el conjunto de datos total se dividio en un ´
431 | 90 % para entrenamiento y un 10 % para validacion, asegurando una distribuci ´ | on balanceada ´
432 | de las clases.
433 | 12.3. Entrenamiento en Google Colab
434 | El proceso de entrenamiento se realizo en la plataforma Google Colab, aprovechando la dispo- ´
435 | nibilidad de unidades GPU para acelerar el calculo. En primer lugar, se instal ´ | o el paquete oficial de ´
436 | Ultralytics mediante el comando:

437
438 1 | !pip install ultralytics 439
440 | Luego, se ejecuto el entrenamiento con el siguiente comando base: ´

441
442 1 | !yolo detect train data =/ content/data.yaml model=yolov11n.pt epochs =60
443 | imgsz =640 444
445 | En este comando se especifica:
446 | data: ruta al archivo de configuracion del conjunto de datos ´
447 | model: arquitectura base seleccionada. En este caso, YOLOv11n, que es una version liviana ´
448 | adecuada para pruebas iniciales
449 | epochs: número de iteraciones completas sobre el conjunto de entrenamiento
450 | imgsz: tamano al que se redimensionan las im ˜ | agenes de entrada (640 p ´ | íxeles)
451 | Durante el entrenamiento, YOLOv11 optimiza los pesos de la red minimizando una funcion de ´
452 | perdida compuesta, que considera la precisi ´ | on de las ´ | bounding-box, la clasificacion correcta de las ´
453 | clases y la confianza de deteccion. La fase de validaci ´ | on se ejecuta autom ´ | aticamente al finalizar cada ´
454 | epoch, utilizando el 10 % del conjunto de datos reservado específicamente para este proposito. Esta ´
455 | separacion garantiza que la evaluaci ´ | on del desempe ´ | no del modelo se realice sobre muestras que no ˜
456 | fueron empleadas durante el entrenamiento, evitando así una estimacion artificialmente optimista ´
457 | de su capacidad predictiva. De lo contrario, el modelo podría incurrir en overfitting, fenomeno en ´
458 | el cual aprende patrones excesivamente específicos del conjunto de entrenamiento —incluyendo
459 | ruido o particularidades irrelevantes— y, como consecuencia, presenta un deterioro significativo en
460 | su desempeno cuando se enfrenta a nuevas im ˜ | agenes. La validaci ´ | on con datos no vistos permite ´
461 | monitorear este comportamiento y constituye una herramienta fundamental para asegurar la correcta
462 | generalizacion del modelo. ´

463 | 12.4. Parametros de entrenamiento: ´ | epochs e imgsz
464 | Durante el proceso de entrenamiento del modelo YOLOv11, dos parametros influyen significa- ´
465 | tivamente en el rendimiento final: el número de epochs y el tamano de imagen ( ˜ | imgsz).
466 | El parametro ´ | epochs define la cantidad de veces que el modelo recorre completamente el conjunto
467 | de datos durante el entrenamiento. Un número mayor de epochs permite que la red neuronal ajuste
468 | mejor sus pesos y mejore su capacidad de generalizacion; sin embargo, un valor excesivo puede ´
469 | conducir al overfitting.
470 | Por otro lado, el parametro ´ | imgsz especifica la resolucion a la cual se redimensionan las im ´ | agenes ´
471 | antes de ingresar a la red. Un tamano mayor proporciona m ˜ | as detalle y mejora la precisi ´ | on de ´
472 | deteccion, aunque tambi ´ | en incrementa el tiempo de entrenamiento y el uso de memoria. En cambio, ´
473 | un tamano menor reduce los requisitos computacionales y acelera el proceso, pero puede disminuir ˜
474 | la exactitud en la identificacion de objetos peque ´ | nos o con bordes finos. ˜
475 | En este proyecto se seleccionaron los valores de e pocℎs = 60 y imgsz = 640, donde se puede
476 | afirmar que se pudo optimizar la precision del modelo sin comprometer significativamente el tiempo ´
477 | de entrenamiento ni la velocidad de inferencia.
478 | En la Figura 20 se presenta un ejemplo de las predicciones obtenidas tras el entrenamiento del
479 | modelo. Cada elemento identificado en la escena se encuentra delimitado mediante una bounding-
480 | box, acompanada por su correspondiente probabilidad de clasificaci ˜ | on -expresada como un valor ´
481 | entre 0 y 1- que refleja el nivel de certeza del modelo respecto de dicha deteccion. ´

img/yolo_predict.jpg

Figura 20: Prediccion de modelo YOLOv11 ´

482 | Se observa que todos los objetos presentes en la imagen fueron reconocidos correctamente,
483 | alcanzando valores de confianza elevados en todas las categorías, con un mínimo de 0,80. Este com-
484 | portamiento evidencia una adecuada capacidad del modelo para discriminar entre clases visualmente
485 | similares, incluso bajo condiciones de iluminacion natural y fondos no totalmente uniformes. ´
486 | De esta manera, resulta destacable que el modelo logra identificar objetos que se encuentran
487 | parcialmente solapados. A pesar de esta superposicion, las ´ | bounding-boxes se ajustan correctamente
488 | a los contornos de cada herramienta, lo que indica que la red es capaz de extraer características

489 | robustas y mantener un desempeno consistente ante escenas con oclusiones leves. Este tipo de ˜
490 | comportamiento es especialmente relevante para aplicaciones practicas, donde las piezas rara vez se ´
491 | encuentran totalmente aisladas o perfectamente separadas dentro del campo visual.
492 | 12.5. Evaluacion del modelo ´
493 | Al concluir el entrenamiento, se generan metricas de desempe ´ | no como: ˜
494 | Precision (P): proporcion de verdaderos positivos respecto a todas las detecciones positivas. ´
495 | Recall (R): proporcion de verdaderos positivos detectados respecto al total de objetos reales. ´
496 | mAP-0.5 (mean Average Precision): promedio de precision considerando un umbral de inter- ´
497 | seccion sobre uni ´ | on de 0.5, utilizado como indicador global del rendimiento del modelo. ´
498 | A partir de estas metricas, se selecciona la mejor versi ´ | on del modelo (archivo ´ | best.pt), la cual
499 | presenta el equilibrio optimo entre precisi ´ | on y generalizaci ´ | on. Este modelo puede posteriormente ´
500 | exportarse a formatos optimizados como .tflite o .onnx, según el entorno de ejecucion deseado ´
501 | (por ejemplo, para una Raspberry Pi). En la Figura 21 se observa el resultado de inferencia obtenido
502 | con el modelo entrenado.

img/yolo_results.png

Figura 21: Curvas de resultado de inferencia de YOLOv11n

503 | 12.6. Inferencia y deteccion de objetos ´
504 | Una vez finalizado el entrenamiento, el modelo es capaz de realizar inferencia sobre nuevas
505 | imagenes o secuencias de video. El proceso de detecci ´ | on consiste en los siguientes pasos: ´
506 | 1. La imagen de entrada se redimensiona al tamano requerido (640 ˜ | ×640 píxeles) y se normaliza.
507 | 2. El modelo predice, para cada celda de la imagen, un conjunto de posibles cuadros delimitadores
508 | con sus respectivas probabilidades de clase.

509 | 3. Se aplica un filtrado de confianza y una tecnica denominada ´ | Non-Maximum Suppression
510 | (NMS) para eliminar detecciones redundantes.
511 | 4. Finalmente, se generan los cuadros delimitadores (bounding-boxes) y etiquetas de clase co-
512 | rrespondientes a los objetos detectados.
513 | El resultado es una salida visual o estructurada en la que cada objeto reconocido aparece
514 | identificado por su categoría y su nivel de confianza, representado como un porcentaje sobre la imagen
515 | original. El modelo resultante logro una detecci ´ | on precisa y estable, manteniendo un equilibrio ´
516 | adecuado entre velocidad de procesamiento e identificacion confiable de objetos. ´
517 | 12.7. Calculo de posici ´ | on del objeto detectado ´
518 | Una vez verificada la deteccion correcta del objeto en la imagen, junto con la delimitaci ´ | on precisa ´
519 | de su bounding-box, y considerando la simplificacion previamente establecida de que el centro de ´
520 | la bounding-box coincide con un alto grado de precision con el centro de gravedad de la pieza, el ´
521 | siguiente paso consiste en traducir esta informacion visual en datos útiles para el robot. En particular, ´
522 | el robot requiere como entrada la posicion espacial del objeto detectado, expresada en coordenadas ´
523 | compatibles con su plano de trabajo.
524 | Para posibilitar esta conversion, resulta indispensable ubicar la c ´ | amara en una posici ´ | on fija y ´
525 | conocida respecto de la base del robot, manteniendo constante la altura durante todo el proceso de
526 | operacion. Esta condici ´ | on permite asegurar que la relaci ´ | on geom ´ | etrica entre el sistema de visi ´ | on´
527 | y el espacio de trabajo permanezca invariable, habilitando así una transformacion coherente entre ´
528 | coordenadas de imagen y coordenadas físicas.
529 | En la Figura 22 se puede apreciar una representacion de la vista superior del sistema rob ´ | otico, ´
530 | donde el círculo representa el robot, que su base es el origen de referencia. El cuadrado es la camara ´
531 | y el punto es el centro de gravedad del objeto detectado. De esta manera, la camara existir ´ | a en la ´
532 | posicion´ (Xcam, Ycam) respecto del origen del robot. Mientras que el objeto detectado, se encuentra
en una posicion relativa respecto a la c ´ | amara ´ | (X

′

ob j , Y′
ob j ⁵³³ | ). Manteniendo fija la posicion de la c ´ | amara, ´
534 | podremos encontrar con precision la posici ´ | on del objeto detectado respecto el origen del robot. El ´
535 | hecho de que el eje vertical sea X (positivo hacia arriba) y el horizontal sea Y (positivo hacia la
536 | izquierda), no es arbitrario sino que coincide con la direccion de los ejes de la base del robot. ´
537 | La localizacion del objeto en la imagen se obtiene a partir del centro de la ´ | bounding-box, sin
538 | embargo, dicha medida esta expresada en p ´ | íxeles. Por lo tanto, es necesario aplicar un factor de
539 | conversion entre p ´ | íxeles y milímetros (mm/px), determinado por la calibracion previa del sistema. ´
540 | Una vez conocido este factor, es posible calcular la posicion del objeto en el plano ´ | X–Y mediante la
541 | siguiente relacion: ´
posobj mm = poscam + posobj px × f | (38)
donde f representa el factor de conversion mm/px obtenido experimentalmente, ´ | pos 542 | cam corres-
ponde a la posicion fija de la c ´ | amara en el plano, y ´ | posobj px ⁵⁴³ | es la posicion del centro del objeto ´
544 | detectado en coordenadas de imagen (pixeles).
545 | Finalmente, para completar la terna de coordenadas del objeto, el valor de Z se determina a partir
546 | de una base de datos que almacena la altura asociada a cada categoría de pieza reconocida. De esta
547 | manera, el sistema es capaz de reconstruir la posicion tridimensional del objeto. Se puede entender ´
548 | la posicion según la ecuaci ´ | on: ´

img/cam_robot.png

Figura 22: Esquema de posicion Robot-C ´ | amara-Objeto ´

posob j mm =

xob j

yob j
(39)

donde se puede observar que el vector posicion´ posob j mm se desglosa en sus componentes xob j ⁵⁴⁹
e yob j ⁵⁵⁰ | . Así, el vector de posicion del objeto queda: ´

xob j

yob j

zob j

=

posob j mm

zdatabase
(40)
551 | 13. Desarrollo del Firmware
552 | En esta seccion se describe el funcionamiento de los elementos que componen el firmware, as ´ | | | í
553 | como el diseno de la arquitectura definida para poder comunicar al robot con el orquestador. Se opt ˜ | | | ó
554 | por usar microROS ya que permite darle modularidad al sistema, permitiendo que sea escalable y en
555 | caso de requerir mas funcionalidades, se puede crear un t ´ | opico y a ´ | nadir un ˜ | callback que responda a
556 | este mismo.
557 | 13.1. Arquitectura general
558 | El sistema consta de un orquestador, que es el encargado de enviar consignas de alto nivel al robot.
559 | En el proyecto se ejecuta sobre una computadora personal, pero podría ser un microprocesador, como
por ejemplo alguno integrado en las placas Raspberry® 560 | . Desde el orquestador se envían comandos
561 | de posicion al robot, tanto articular como en el espacio cartesiano; adem ´ | as se env ´ | ían los comandos
562 | de Homing y de parada de emergencia. El envío de consignas de velocidad y aceleracion se deja ´
563 | como trabajo futuro.
564 | Es una variante de ROS para microcontroladores. Disenado por ˜ | eProsima, presenta una evolucion´
565 | a la comunicacion entre microcontrolador y otro microprocesador o computadora respecto a ´ | | | ROS1.
566 | La eleccion de este enfoque se debe a que se puede adaptar r ´ | apidamente al ecosistema ROS, y ´
567 | reemplaza al ROS-bridge rosserial, ya que ROS1 ya llego a su ´ | EOL (no tiene mas soporte oficial). ´

568 | Para que la comunicacion entre el nodo ROS del orquestador y el robot se pueda dar, se debe ´
569 | tener un agente que se encarga de realizar una “traduccion” de DDS a micro-XRCE DDS. ´
570 | 13.2. Modulos b ´ | asicos ´
571 | 13.2.1. Programacion motores ´
572 | Se programaron los motores Paso a Paso de forma que la generacion de pulso en el pin ´ | STEP
573 | de cada driver DRV8825 sea controlada por PWM. Un gran beneficio de esto es que la generacion´
574 | de pulso por PWM no consume recursos de software del STM32 ya que de esta tarea se encarga el
575 | hardware del mismo. De esta manera, se dedico a cada motor un timer correspondiente. ´
576 | La programacion por PWM requiere calcular el valor requerido en los registros ´ | ARR (Auto
577 | Reload Register) y PSC (Prescaler). Al cambiar la velocidad requerida por cada motor en trayec-
578 | torias complejas, es necesario recalcular estos valores constantemente para generar la frecuencia
579 | correspondiente por PWM. El período se calcula como:

Periodo =

(ARR + 1) × (PSC + 1)

Freq Clock

(41)

580 | Despejando de la ecuacion, el c ´ | alculo de ´ | ARR para una frecuencia determinada de Periodo es:

ARR =

Periodo × Freq Clock

PSC + 1

− 1 | (42)
581 | Considerando que en la interrupcion de PWM los motores realizan un micropaso a la vez, se ´
582 | puede entender a la frecuencia del PWM como ste ps/s. En la Tabla 2 se detallan los valores de
583 | frecuencia por PWM con la velocidad de los motores y en los eslabones (carga de cada motor) en
584 | múltiples unidades.
| Frecuencia PWM [Hz]
| 50 | 100 | 200 | 300 | 400 | 500 | 1000
Motores 1,2,3 [rev/s] | 0.03125 | 0.0625 | 0.125 | 0.1875 | 0.25 | 0.3125 | 0.625
Motores 1,2,3 [rpm] | 1.875 | 3.75 | 7.5 | 11.25 | 15 | 18.75 | 37.5
Motores 1,2,3 [°/s] | 11.25 | 22.5 | 45 | 67.5 | 90 | 112.5 | 225
Carga 1 [rev/s] | 0.0055 | 0.0110 | 0.0220 | 0.0330 | 0.0440 | 0.0550 | 0.1100
Carga 1 [rpm] | 0.3299 | 0.6597 | 1.3194 | 1.9792 | 2.6389 | 3.2986 | 6.5972
Carga 1 [°/s] | 1.9792 | 3.9583 | 7.9167 | 11.8750 | 15.8333 | 19.7917 | 39.5833
Carga 2 y 3 [rev/s] | 0.0117 | 0.0234 | 0.0469 | 0.0703 | 0.0938 | 0.1172 | 0.2344
Carga 2 y 3 [rpm] | 0.7031 | 1.4063 | 2.8125 | 4.2188 | 5.6250 | 7.0313 | 14.0625
Carga 2 y 3 [°/s] | 4.2188 | 8.4375 | 16.8750 | 25.3125 | 33.7500 | 42.1875 | 84.3750

Tabla 2: Frecuencias de PWM y velocidades en motores/eslabones

585 | 13.2.2. Programacion sensores de ´ | angulo ´
Para la adquisicion de los ´ | angulos articulares se utiliza un multiplexor I ´

2
586 | C TCA9548A, cuya
587 | funcion es permitir la lectura independiente de varios sensores AS5600 que comparten la misma ´ direccion I ´
| 2
588 | C. El microcontrolador habilita uno de los ocho canales del multiplexor escribiendo un

589 byte en su registro de control, donde cada bit activa un canal distinto. De esta manera, solo el sensor ´ asociado al canal seleccionado queda accesible en el bus I²
590 | C para la siguiente lectura.
591 | Una vez elegido el canal correspondiente, se accede a los registros del AS5600 para obtener los
592 | dos bytes que contienen la medida angular en formato raw. Dichos bytes se combinan y se extraen
593 | los 12 bits significativos del valor, que representan el angulo absoluto del im ´ | an en un rango de 0 ´
594 | a 4095. Dependiendo de la disposicion mec ´ | anica del sensor respecto del eje, puede ser necesario ´
595 | invertir el sentido de algunas lecturas para mantener un sistema de referencia coherente entre todas
596 | las articulaciones.
597 | El valor raw obtenido se convierte a grados mediante la relacion: ´

θ =

raw
4096
- 360◦
(43)
598 | Posteriormente, el angulo se reexpresa en el rango ´ | [−180, 180), lo cual simplifica los calculos ´
599 | de control y evita discontinuidades cuando el valor se hace negativo.
600 | Dado que en algunas ocasiones pueden producirse lecturas erroneas por ruidos en la comuni- ´
cacion I ´

2
601 | C o por pequenas perturbaciones durante la adquisici ˜ | on, se incorpora un mecanismo de ´
602 | rechazo de picos. Este consiste en comparar la lectura actual con la lectura previa: si la diferencia
603 | entre ambas supera un umbral preestablecido, se considera que la medicion no es v ´ | alida y se man- ´
604 | tiene el último valor fiable. Si la variacion se encuentra dentro del l ´ | ímite permitido, la lectura se
605 | acepta como correcta. Este criterio resulta suficiente para los sensores AS5600, ya que el angulo ´
606 | real normalmente varía de manera continua y suave entre muestras, por lo que los saltos abruptos
607 | suelen indicar claramente una lectura incorrecta.
608 | 13.2.3. Programacion cinem ´ | atica ´
609 | Inicialmente, la cinematica del manipulador fue desarrollada y verificada en ´ | MATLAB, lo que
610 | permitio asegurar la coherencia entre el modelo te ´ | orico y el comportamiento f ´ | ísico del robot. Una
611 | vez validado el modelo, se realizaron pruebas donde se implemento el c ´ | alculo de la cinem ´ | atica ´
612 | inversa directamente sobre el microcontrolador STM32F446RE, aprovechando la Floating Point
613 | Unit (FPU) integrada, para operar con aritmetica en coma flotante simple y alcanzar desempe ´ | nõ
614 | en tiempo real. Sin embargo, la resolucion final de la cinem ´ | atica se traslad ´ | o a Python, ya que ´
615 | forma parte de una funcion que es llamada por el orquestador del sistema, responsable tambi ´ | en del ´
616 | calculo de la trayectoria. Esta decisi ´ | on permiti ´ | o simplificar los procesos de c ´ | alculo y validaci ´ | on´
617 | dentro del espacio de trabajo, ademas de contribuir a minimizar el consumo de memoria en el ´
618 | microcontrolador. Asimismo, el tiempo de calculo de la trayectoria no supera los 35 ´ | ms, por lo
619 | que resulta lo suficientemente bajo como para justificar su ejecucion en Python. De este modo, ´
620 | la generacion de consignas articulares y la planificaci ´ | on del movimiento quedan integradas en un ´
621 | mismo entorno de procesamiento.
622 | 13.2.4. Generacion de Trayectorias sincronizadas ´
623 | La generacion de trayectorias sincronizadas para el robot se divide en dos partes: la definici ´ | on de ´
624 | la forma geometrica en el espacio cartesiano y la asignaci ´ | on de una ley de movimiento temporal que ´
625 | respete las limitaciones dinamicas de los motores Paso a Paso. Esta separaci ´ | on permite desacoplar ´
626 | el problema geometrico del din ´ | amico, simplificando el dise ´ | no y an ˜ | alisis de la trayectoria. ´
627 | La primer parte consiste en establecer un conjunto de puntos de control (waypoints) en el espacio
628 | cartesiano, que terminan definiendo la ruta que debe seguir el efector final. En este nivel, solo importa
629 | la geometría: el punto inicial A, el punto final B y los puntos de paso obligatorios que garantizan,

630 | por ejemplo evitar obstaculos. A partir de los puntos definidos, se genera una curva param ´ | etrica ´
631 | p(s) suave en el espacio cartesiano interpolada utilizando B-Splines cúbicas:
p(s) = [x(s), y(s), z(s)], | s ∈ [0, 1] | (44)
632 | Donde el parametro ´ | s es geometrico y no representa tiempo f ´ | ísico. El uso de B-Splines cúbicas
garantiza continuidad de segundo orden (C

2
633 | ), es decir: p(s), p(s) y p¥(s) son continuas, lo que
634 | significa que no habra saltos infinitos en velocidad o aceleraci ´ | on. Una propiedad relevante de las ´
635 | B-Splines es que permite generar curvas que pasen específicamente por los puntos asignados (se les
636 | asigna gran peso) o simplemente aproximarse para asegurar suavidad en la curvatura (se les asigna
637 | poco peso), para mas informaci ´ | on consultar [ ´ | BSp, 2001]. Para este proyecto se asigno:´
638 | Gran peso en los extremos, para garantizar pasar exactamente por las posiciones inicial y final
639 | Poco peso en los puntos intermedios, para evitar cambios bruscos en posicion o velocidad ´
640 | Para cada punto p(s) se resuelve la cinematica inversa, obteniendo la trayectoria articular: ´
q(s) = [q1(s), q2(s), q3(s)] | (45)
641 | La evolucion del par ´ | ametro ´ | s en el tiempo queda definida por un polinomio de grado 5. A
642 | continuacion, se puede observar el polinomio y sus dos siguientes derivadas respecto al tiempo. ´

s(t) = a5τ

5 + a4τ
4 + a3τ

3 + a2τ

2 + a1τ + a0, | τ =

t

T

(46)

s¤(t) =

1

T

5a5τ

4 + 4a4τ

3 + 3a3τ

2 + 2a2τ + a1

(47)

s¥(t) =

1

T

2

20a5τ

3 + 12a4τ

2 + 6a3τ + 2a2

(48)
643 | Siendo T el tiempo total de la trayectoria. Para encontrar los valores de los coeficientes es
644 | necesario establecer 6 condiciones de contorno:

s(0) = 0, | s(T) = 1
s¤(0) = 0, | s¤(T) = 0
s¥(0) = 0, | s¥(T) = 0
645 | Al aplicar estas condiciones y resolviendo el sistema de ecuaciones, los coeficientes resultantes
646 | son: a0 = a1 = a2 = 0 a3 = 10 a4 = −15 a5 = 6. De esta manera, el polinomio s(t) con sus
647 | respectivas derivadas queda de la siguiente manera:

s(t) = 6τ

5 − 15τ
4 + 10τ

3
(49)

s¤(t) =

1

T

30τ

4 − 60τ

3 + 30τ

2

(50)

s¥(t) =

1

T

2

120τ

3 − 180τ

2 + 60τ

(51)
648 | Se puede observar la representacion gr ´ | afica de estas ecuaciones en la Figura ´ | 23. El procedimiento
649 | mencionado desacopla la forma de la trayectoria de su evolucion temporal, permitiendo posterior- ´
650 | mente aplicar tecnicas de ´ | time-scaling, que consiste en escalar la trayectoria parametrica a un tiempo ´
651 | T para satisfacer los límites de velocidad y aceleracion en la articulaci ´ | on m ´ | as exigida: ´

| ¤q| ≤ ¤qmax, | | ¥q| ≤ ¥qmax | (52)
652 | Luego se relacionan las derivadas temporales con el parametro geom ´ | etrico: ´

q¤(t) =

dq

ds

s¤(t) | (53)

q¥(t) =

d

2q

ds2

s¤

2

(t) + dq

ds

s¥(t) | (54)
653 | Combinando la geometría q(s) con la ley temporal s(t) se obtienen: q(t), q¤(t) y q¥(t), que
654 | constituyen las trayectorias articulares físicamente realizables por los motores (ver Figura 24). La
655 | representacion de la trayectoria interpolada en el espacio de trabajo con puntos de control se puede ´
656 | ver en la Figura 25.

img/curvas_S.png

Figura 23: Posiciones, velocidades y aceleraciones del parametro ´ s

img/curvas_Q.png

Figura 24: Posiciones, velocidades y aceleraciones articulares

img/b_spline.png

Figura 25: Trayectoria en el espacio de trabajo interpolada con B-Spline

657 | 14. Integracion de ROS, microROS y FreeRTOS en Sistemas ´
658 | Embebidos
659 | El objetivo de esta seccion es describir de manera general la arquitectura de integraci ´ | on entre el ´
660 | nodo orquestador y el microcontrolador, enfatizando los roles de cada componente y su relacion en ´
661 | el sistema robotico. ´
662 | El control de alto nivel (control supervisor) se hace en la computadora, y este nodo envía las
663 | consignas de posicion, homing, parada de emergencia. El sistema de mensajer ´ | | | ía de ROS permite
664 | disminuir el tiempo de desarrollo del envío de informacion entre los sistemas a trav ´ | es de modos que se ´
665 | comunican con un patron´ publisher/subscriber anonimo. El microcontrolador ejecuta microROS, una ´
666 | variante de ROS que se ejecuta dentro de una Task de FreeRTOS. La misma esta dedicada a la creaci ´ | on´
667 | de executors, que manejan la comunicacion entre los nodos y las publicaciones/suscripciones. ´
668 | 14.1. ROS
669 | ROS2 provee distintos mecanismos de comunicacion entre m ´ | odulos, que son objetos llamados ´
670 | nodos. Los mecanismos de comunicacion son interfaces, quienes permiten el intercambio de in- ´
671 | formacion entre nodos de manera estructurada. Las principales son mensajes, servicios y acciones, ´
672 | cada una disenada para diferentes patrones de comunicaci ˜ | on dentro del sistema. ´
673 | Los mensajes se transmiten a traves de t ´ | opicos, siguiendo el patr ´ | on publisher/subscriber, como ´
674 | se menciono anteriormente. Cualquier nodo que publique un mensaje en un t ´ | opico determinado ´
675 | puede ser recibido por todos los nodos suscritos a el. Este mecanismo es ideal para flujos de datos ´
676 | continuos o asincronicos, como sensores o comandos peri ´ | odicos. En este caso se env ´ | ían las consignas
677 | de posicion mediante t ´ | opicos con un tiempo peri ´ | odico fijo. ´
678 | Los servicios implementan un modelo request/response, permitiendo que un nodo solicite una
679 | operacion a otro y reciba una respuesta inmediata. Son adecuados para interacciones puntuales que ´
680 | requieren confirmacion o retorno de datos. ´
681 | Las acciones estan dise ´ | nadas para tareas que requieren m ˜ | as tiempo en completarse. Una acci ´ | on´
682 | esta compuesta por dos servicios (uno para enviar el objetivo - ´ | | | goal- y otro para obtener el resultado

683 | final) y un flujo de mensajes publicados en un topico para proporcionar retroalimentaci ´ | on durante ´
684 | la ejecucion. Otra diferencia entre acciones y servicios es que las primeras pueden ser canceladas. ´
685 | En la Figura 26 se pueden ver los nodos correspondientes al orquestador ROS (llamado “mini-
686 | mal publisher”) y los nodos correspondientes al modulo de c ´ | alculo de trayectoria y al de la interfaz ´
687 | de usuario. El sentido de las flechas es desde el publicador hacia el suscriptor.

img/rosgraph.png

Figura 26: Grafico de nodos ROS ´

688 | La comunicacion entre nodos viene dada por un protocolo basado en UDP, y se debe respetar la ´
689 | red en la que se comunican los nodos. Por ejemplo, se puede tener grupos de nodos con un proposito ´
690 | en la misma red que otro grupo. Para esto se usa el ROS DOMAIN, que en este caso es 0, lo que
691 | quiere decir que el rango de conexion aceptado para las conexiones es entre los puertos 7400 y 7651 ´
692 | (mas detalles en ´ | 18.5).
693 | Se eligieron tipos de mensajes core de ROS para ser enviados. Estos son del tipo Point y
694 | Bool. Tambien se pueden enviar mensajes de tipo String y hacer una “traducci ´ | on” de una trama ´
695 | personalizada. En este caso se opto por usar unos tipos de mensajes nativos, pero tambi ´ | en se pueden ´
696 | crear mensajes personalizados (formato .msg). A continuacion se muestra un mensaje de tipo nativo. ´
697 | Con el siguiente comando se puede ver el tipo de mensaje, en este caso de tipo Point.

698
699 1
700 2 | ros2 interface show geometry_msgs /msg/Point
701 3 | # This contains the position of a point in free space
702 4 | float64 x
703 5 | float64 y
704 6 | float64 z 705

Estructura de mensaje Point

706 | Se pueden crear mensajes personalizados, con el formato <tipo de dato> <nombre variable>
707 | y ubicando el archivo en la carpeta msg en el proyecto. Por ejemplo, para el envío de comandos para
708 | variables articulares, se uso esta configuraci ´ | on: ´

709
710 1 | float64 [3] q | # Angulos de las articulaciones (posicion)
711 2 | float64 [3] qd | # Velocidades angulares
712 3 | int32 t_total | # Tiempo total
713 4 | int32 traj_state | # Estado de la trayectoria 714
Estructura de mensaje Point
715 | Se podría, por ejemplo, agregar un header con el timestamp del mensaje, y algún flag. Los mensajes
716 | pueden ser compuestos por otros mensajes, por ejemplo:

717
718 1 | ros2 interface show std_msgs/msg/Header

719 2
720 3 | # Standard metadata for higher -level stamped data types.
721 4 | # This is generally used to communicate timestamped data
722 5 | # in a particular coordinate frame.
723 6 | # Two-integer timestamp that is expressed as seconds and nanoseconds.

724 7
725 8 | builtin_interfaces /Time stamp
726 9 | int32 sec
72710 | uint32 nanosec

72811
72912 | # Transform frame with which this data is associated.
73013 | string frame_id 731
| Ejemplo de estructura compuesta
732 | Para extender ROS a microcontroladores, se utiliza microROS (ver 14.2). La arquitectura típica
733 | sigue el siguiente esquema:
734 | 1. ROS2 en un sistema host: nodos mas complejos, planificaci ´ | on y coordinaci ´ | on. ´
735 | 2. microROS en un microcontrolador: tareas de interpretacion de consignas y adquisici ´ | on de ´
736 | sensores.
737 | 3. FreeRTOS: como RTOS subyacente.
738 | 4. microROS Agent: como puente entre DDS y DDS-XRCE.
739 | Esta estructura permite que un microcontrolador se comporte como un nodo ROS nativo desde
740 | la perspectiva del resto del sistema. En la Figura 27 se puede apreciar un detalle.
741 | Como mencion, se puede agregar que las mediciones de las variables articulares pueden ser ´
742 | guardadas en una cola RTOS y ser enviadas a un publisher mediante un topico. ´
743 | Otro dato no menos relevante es que se pueden elegir diversas estrategias para enviar y recibir
744 | consignas, mensajes de ACK/NAK, mensajes de debug o valores de sensores. En el caso de estudio
745 | actual se opto por distintos ´ | topics, por una cuestion de facilidad de desarrollo y prototipado. Otra ´
746 | opcion disponible era hacer uso de ´ | actions. Por ejemplo, se podría enviar la consigna de posicion´
747 | deseada (goal), obtener el resultado y estar suscrito a un topico de feedback que tendr ´ | | ía las posiciones
748 | actuales de los motores.
749 | Cabe destacar que ROS tiene una estructura interna que se debe seguir, porque en ella se
750 | indican los nodos, a que clases corresponden, las dependencias y demas. Adem ´ | as de esto cuenta con ´
751 | herramientas que ya facilitan este tipo de configuraciones.

img/diagramaObjetosROS_completo.png

Figura 27: Mapa conceptual de las conexiones entre el orquestador y el esclavo

752 | 14.2. microROS
753 | El stack microROS es una version reducida de ROS2 dise ´ | nada espec ˜ | íficamente para microcon-
754 | troladores con recursos limitados de RAM, CPU y energía. Se desarrolla como proyecto open source
755 | desde 2018. Hace uso del protocolo DDS-XRCE, una variante ligera del DDS utilizada por ROS2
756 | que permite la serializacion y transporte eficiente de mensajes. El objetivo de este software stack ´
757 | es que el codigo de ROS2 sea f ´ | acilmente portable a microcontroladores [ ´ | Belsare et al., 2023]. El
758 | stack microROS utiliza la arquitectura en capas de ROS y reutiliza la mayor cantidad de paquetes de
759 | ROS2.
760 | Entre las principales características, se puede mencionar que, ademas de contar con APIs similares ´
761 | a ROS2 (optimizadas para baja memoria), se cuenta con soporte para distintos RTOS y para diferentes
762 | canales de comunicacion. En la capa de Middleware, usa una implementaci ´ | on del standard DDS- ´
763 | XRCE de eProsima, Micro XRCE-DDS (DDS For Extremely Resource Constrained Environments).
764 | Para poder comunicar el microcontrolador con el orquestador, se necesita un agente que hace de
765 | puente entre DDS y DDS-XRCE.
766 | La configuracion de los nodos y del ´ | executor se hacen en una tarea de FreeRTOS. Las suscrip-
767 | ciones y publicaciones a los distintos topicos (considerando tipos de datos), los timers (si los hay) y ´
768 | el enlace con los callbacks asociados a cada topico) son manejadas por el ´ | executor.
769 | El flujo se puede resumir de la siguiente manera: se inicia el transporte (UART en este caso) y
770 | el middleware, luego se especifican los publishers/subscribers o timers si los hubiera, se define el
771 | executor asociado y se mantiene sincronizado con el agente. Se considera la liberacion de recursos ´
772 | en caso de que se finalice la comunicacion. ´
773 | 14.3. FreeRTOS
774 | FreeRTOS es un sistema operativo de tiempo real ampliamente utilizado en sistemas embebidos
775 | y esta dise ´ | nado para microcontroladores. Provee un modelo simple de multitarea con prioridades ˜
776 | explícitas, colas, semaforos y temporizadores. En este proyecto se ha optado por usar FreeRTOS. ´
777 | Cabe destacar al haber una tarea dedicada a microROS no se bloquean tareas críticas dentro del
778 | sistema.
779 | El nodo microROS necesita al menos 10 kB de memoria en el stack para poder ejecutarse, y
780 | la comunicacion serial se hace mediante UART con DMA. Se tienen distintos tipos de transports, ´
781 | se elige DMA porque no usa tiempo de procesamiento en la CPU, lo cual evita sobrecargas. Es

importante que el canal Rx este configurado como circular ´

2
782 | . Otro detalle a mencionar es que
783 | para la programacion en el microcontrolador se us ´ | o la API de CMSIS que viene integrada en los ´
784 | microcontroladores ST. Esta misma sirve como capa de abstraccion porque se pueden usar sus ´
785 | funciones y las mismas pueden servir para otro RTOS subyacente, como por ejemplo Zephyr.
786 | FreeRTOS administra los recursos temporales y de concurrencia, mientras que microROS ges-
787 | tiona la comunicacion a nivel de middleware. ´
788 | Entre las funcionalidades principales de FreeRTOS se encuentran:
789 | Tasks: hilos ligeros con prioridad configurada. Como se ve en la grafica presentada anterior- ´
790 | mente, hay tareas para el control de los motores, para el calculo de la cinem ´ | atica y para el ´
791 | modo homing.
792 | Queues: se usan para que haya comunicacion segura entre tareas. Se pueden hacer colas y ´
793 | arrays de colas. Este último caso sirve para mid JointQueue, así se separa una cola por motor.
794 | Timers: ejecucion peri ´ | odica controlada por el RTOS. ´
795 | APIs seguras para ISR: integracion con interrupciones externas. Se pueden configurar en el ´
796 | caso de parada de emergencia.
797 | Gestion de memoria configurable ´ | : importante dado que microROS favorece esquemas estati- ´
798 | cos. Por cuestiones de funcionamiento, la tarea asignada a microROS debería tener al menos
799 | 10 kB.
800 | La seleccion adecuada de prioridades entre tareas de control y tareas asociadas a microROS es ´
801 | crítica para cumplir deadlines.
802 | 14.4. Integracion: ROS2 – microROS – FreeRTOS ´
803 | El ecosistema general puede describirse mediante tres niveles:
804 | 1. Nivel de aplicacion (ROS2) ´ | : nodos de planificacion, control de alto nivel e interfaces de ´
805 | usuario.
806 | 2. Nivel de middleware: ROS2 utiliza DDS completo; microROS emplea DDS-XRCE con un
807 | agente como intermediario.
808 | 3. Nivel embebido (microcontrolador): FreeRTOS ejecuta las tareas del sistema y el rclc
809 | executor procesa los callbacks de microROS.
810 | Teniendo en cuenta estos puntos, se presenta un grafico (Figura ´ | 28) desde el punto de vista de ROS,
811 | con la informacion de los nodos correspondientes al orquestador y al agente del microcontrolador. ´
812 | Este enfoque desacopla el control de alto nivel del control en tiempo real, permitiendo un disenõ
813 | robusto y escalable. Entrando mas en detalle, se pueden diferenciar las distintas partes del sistema. ´
814 | En la computadora, el sistema esta compuesto por 4 nodos principales: ´

2Así el DMA escribe de manera continua los datos entrantes en un búfer sin requerir reinicio manual ni intervencion´ constante de la CPU. Una vez que se reciben todos los bytes de datos, se reinicia el contador y el DMA continua recibiendo datos

img/rosgraph_micro.png

Figura 28: Diagrama de conexiones entre nodos

815 | robot ui: Interfaz de usuario que permite enviar comandos al robot, carga de trayectorias CSV
816 | y comunicacion con servidores externos. ´
817 | trajectory planner: Nodo encargado de la planificacion de trayectorias. Recibe posiciones ´
818 | cartesianas y genera trayectorias articulares interpoladas, publicando mensajes del tipo ex-
819 | tra interfaces/Trama (posiciones q, velocidades q¤, tiempo y estado de trayectoria).
820 | publisher: es el encargado de comunicar la interfaz de usuario con el microcontrolador, así
821 | como con el planificador de trayectoria.
822 | microROS Agent: actúa como puente de comunicacion ( ´ | bridge), traduciendo los mensajes
823 | DDS de ROS2 al protocolo XRCE-DDS utilizado por el microcontrolador a traves de la ´
824 | interfaz UART.
825 | En la Tabla 3 se muestra una breve descripcion de los t ´ | opicos utilizados, el tipo de mensaje ´
826 | utilizado, el sentido de la comunicacion y un detalle funcional. ´
827 | El firmware del STM32 implementa un sistema multitarea basado en FreeRTOS cuyas tareas
828 | principales son:
829 | StartDefaultTask: Tarea de inicializacion que configura el transporte UART, crea el nodo ´
830 | microros pubsub rclc y ejecuta el bucle del executor para despachar los callbacks de las
831 | subscripciones.
832 | StartMotorControlTask: Tarea consumidora responsable de ejecutar los movimientos de
833 | cada motor. Inicializa los metodos relacionados a la inicializaci ´ | on de las consignas PWM. ´

Topico ´ | Tipo de mensaje | Direccion´ | Descripcion´
/microROS/homing | std msgs/Bool | ROS ⇒ STM32 | Comando de homing
/microROS/cmd | extra interfaces/Trama | ROS ⇒ STM32 | Trayectoria arti-cular
/microROS/inverse | geometry msgs/Point | ROS ⇒ STM32 | Posicion carte- ´ siana (cinemati- ´ ca inversa)
/microROS/string publisher | std msgs/String | STM32 ⇒ ROS | Realimentacion´ de posicion´
Tabla 3: Descripcion de t ´ | opicos m ´ | as relevantes ´
834 | Callbacks de subscripcion: ´ | Incluyen cmd callback (trayectorias), homing callback (referen-
835 | ciado) e inverse kinematics callback (coordenadas cartesianas). El microcontrolador es capaz
836 | de realizar los calculos de cinem ´ | atica directa e inversa internamente. ´
837 | El flujo de datos sigue una secuencia definida para garantizar la integridad de los comandos:
838 | 1. Fase de Recepcion: ´ | Al recibir un mensaje, el executor invoca el cmd callback, que convierte
839 | el mensaje a una estructura interna JOINT POS t y la deposita en la cola mid JointQueue
840 | mediante osMessageQueuePut().
841 | 2. Sincronizacion: ´ | La cola funciona como un mailbox (tamano unitario); si llega un comando ˜
842 | nuevo, el anterior es sobrescrito para evitar datos obsoletos.
843 | 3. Fase de Ejecucion: ´ | la tarea lee la cola, e inicia el movimiento mediante Timers de hardware
844 | en modo PWM. La rutina de interrupcion HAL ´ | TIM PeriodElapsedCallback() actualiza la
845 | posicion en tiempo real. ´
846 | 4. Fase de Retroalimentacion: ´ | la posicion se guarda en mid ´ | FeedbackQueue al completar el
847 | movimiento. Un temporizador de software (500 ms) consulta esta cola y publica el estado en
848 | el topico /microROS/string ´ | publisher utilizando rcl publish().
849 | 14.5. Flujo de informacion en trayectorias ´
850 | El flujo de informacion m ´ | as completo es el de generaci ´ | on de trayectorias de múltiples objetivos. ´
851 | Para realizar una determinada trayectoria, se detallan a continuacion los pasos que se aplican desde ´
852 | la publicacion de los comandos de posici ´ | on hasta la ejecuci ´ | on en el microcontrolador: ´
853 | 1. robot ui: el nodo de interfaz grafica recibe la ruta con el archivo que contiene los objetos solici- ´
854 | tados, simulando así un determinado pedido. Publica en el topico ´ | /robot ui/load objects,
855 | donde es consumido por el nodo publisher.
856 | 2. publisher: este nodo se encarga de la comunicacion con el servidor, donde recibe la posici ´ | on´
857 | xyz del objetivo porsocket, la decodifica y publica en el topico ´ | /ROS/trajectory planning,
858 | donde es consumido por el nodo trajectory planner.

859 | 3. trajectory planner: este nodo se encarga de la generacion de las trayectorias considerando el ´
860 | interpolador B-Spline y la ley de tiempo de polinomio de grado 5 (Ecuacion´ 46). La trayectoria
861 | sincronizada es determinada por los puntos de inicio, fin y posibles puntos intermedios. Se
862 | la discretiza con un paso de tiempo fijo, que para este proyecto se establecio en ´ | Δt = 45ms,
863 | el cual es un valor de compromiso entre rendimiento y movimientos suaves en el robot.
864 | A continuacion, se publican las posiciones objetivo en el t ´ | opico ´ | /planner/path y son
865 | consumidas por el publisher, quien las envía al microcontrolador.
866 | 4. startMotorControlTask: el callback de microROS subscripto a /microROS/cmd se encarga
867 | de realizar una adaptacion del mensaje y colocarlo en cola (como se menciona en la secci ´ | | on´
868 | 14.4). Cada punto de la trayectoria se categoriza en uno de los siguientes estados: inicio,
869 | durante, finalizacion. El estado es guardado en la variable ´ | traj state de la estructura Trama
870 | y su valor se traducira en el control de trayectoria mediante ´ | trajectoryControl, inicio y parada
871 | de los timers PWM.
872 | 5. trajectoryControl: es la funcion encargada del control de trayectoria. Toma como par ´ | | ametros ´
873 | la posicion´ q(i), la velocidad qd (i) y que motor se desea controlar. Realiza un control de ´
874 | posicion corrigiendo la velocidad con un control proporcional. La variaci ´ | | on de velocidad se ´
| traduce de ◦
875 | /s a ste ps/s con la correspondiente relacion de transmisi ´ | | on por motor y los ´
876 | micropasos por revolucion. Cuando se desea detener los timers, se realiza una compensaci ´ | | on´
de posicion hacia la posici ´ | on objetivo hasta situarse dentro de un error de tolerancia de 0 ´ | ,2
| | | ◦
| | | 3
877

878 El flujo mencionado anteriormente se puede ver en la Figura 29.

img/flujoDatoConsigna.png

Figura 29: Flujo de datos en trayectorias

3Ver funcion de control en ´ | 18.6

879 | 15. Ensayos realizados
880 | 15.1. Ensayo de carga electroiman´
881 | Con el fin de determinar las capacidades reales de sujecion del efector final, se realizaron ´
882 | diversos ensayos experimentales sobre el electroiman instalado en el robot. Estos ensayos permitieron ´
883 | caracterizar el comportamiento del sistema ante variaciones en la masa, la geometría y la distancia
884 | de las piezas a manipular.
885 | En primer lugar, se evaluo la carga m ´ | axima que el electroim ´ | an puede sostener de manera ´
886 | confiable. Se comprobo que el l ´ | ímite practico se alcanza cuando se sujetan piezas de 135 g. La ´
887 | sujecion fue realizada respecto del centro de gravedad de las piezas, ya que m ´ | as all ´ | a de este punto, el ´
888 | peso realiza momento que aumenta la carga efectiva, lo que reduce la capacidad de sujecion y puede ´
889 | comprometer la estabilidad durante el traslado. Por esta razon, se considera que la manipulaci ´ | on´
890 | debe realizarse preferentemente tomando la pieza lo mas cerca posible de su centro de gravedad y ´
891 | se debe tener en cuenta este valor de peso maximo por pieza. ´
892 | Otro aspecto analizado fue la maxima distancia admisible entre la superficie del electroim ´ | an y ´
893 | la pieza para que la sujecion sea efectiva. Los ensayos realizados permitieron establecer que, para el ´
894 | electroiman utilizado, la distancia l ´ | ímite es de aproximadamente 4 mm. Esto implica que, siempre
895 | que el robot se posicione por debajo de ese valor, la atraccion magn ´ | etica ser ´ | a suficiente para asegurar ´
896 | la captura del objeto. Este valor deja un buen margen sobre el cual puede posicionarse el electroiman´
897 | al intentar sujetar piezas.
898 | Por último, se verifico la presencia de magnetismo remanente una vez que el electroim ´ | an es ´
899 | desenergizado. Este efecto provoca que objetos de muy baja masa (menores a 20 g) permanezcan
900 | adheridos al electroiman aún sin corriente. Si bien este fen ´ | omeno no afecta significativamente ´
901 | la manipulacion de piezas m ´ | as pesadas, es relevante tenerlo en cuenta en aplicaciones donde la ´
902 | liberacion precisa del objeto sea un requisito fundamental. Finalmente se descubri ´ | o que agregando ´
903 | un fino aislante a la base del electroiman, los objetos de baja masa caen por su propio peso. ´
904 | 15.2. Ensayo de calibracion de sensores de ´ | angulo ´
905 | La calibracion de los sensores magn ´ | eticos AS5600 se llev ´ | o a cabo mediante un procedimiento ´
906 | experimental destinado a obtener una referencia angular absoluta confiable. Para esto, se uso un ´
907 | sensor inercial MPU6050, el cual se coloco directamente sobre los eslabones accionados por los ´
908 | motores correspondientes, de modo que proporcionara una medida del angulo real respecto al eje ´ | X
909 | del robot.
910 | El proceso consistio en posicionar cada eslab ´ | on en una orientaci ´ | on conocida y f ´ | acilmente ´
| identificable: 0◦ para el eslabon 1, 90 ´ | ◦ para el eslabon 2 y 0 ´

◦
911 | | | para el eslabon 3. Una vez fijada cada ´
912 | posicion y registrado el ´ | angulo mediante el MPU6050, se procedi ´ | o a leer el valor entregado por el ´
913 | sensor AS5600. Debido a que la medicion del AS5600 depende directamente de la orientaci ´ | on del ´
914 | iman de neodimio solidario al eje, fue necesario realizar ajustes iterativos en la posici ´ | on del im ´ | an´
915 | hasta que la lectura reportada coincidiera con el angulo de referencia establecido por el MPU6050. ´
916 | Este metodo de calibraci ´ | on fue imprescindible porque el AS5600 no mide ´ | angulos absolutos ´
917 | en un sistema de coordenadas físico predefinido, sino la rotacion relativa del campo magn ´ | etico ´
918 | generado por el iman. De esta manera, la alineaci ´ | on precisa entre el campo magn ´ | etico y el sistema ´
919 | de coordenadas del robot fue esencial para garantizar coherencia entre el angulo medido y la ´
920 | orientacion real del eslab ´ | on. ´

921 | 15.3. Ensayos cinematicos ´
922 | En la etapa inicial del proyecto, el calculo de la cinem ´ | atica inversa del robot fue desarrollado ´
923 | y evaluado en MATLAB. Una vez verificada la validez del modelo, el algoritmo fue trasladado al
924 | STM32 haciendo uso de su FPU. Aun así, las consignas de movimiento para cada articulacion se ´
925 | realizan en Python con el objetivo de simplificar la verificacion dentro del ´ | area de trabajo. ´
926 | Las pruebas realizadas confirmaron que el efector final se desplaza con precision hacia los ´
927 | puntos definidos por la cinematica inversa, demostrando la correcta implementaci ´ | on del algoritmo ´
928 | y su adecuada integracion con el sistema de control del robot. ´
929 | Mediante ensayos experimentales se verifico que los motores Paso a Paso, operando bajo carga, ´
930 | pueden alcanzar una velocidad maxima de aproximadamente 75 rpm (equivalente a 450 ´ | °/s). Sin
931 | embargo, con el fin de garantizar un funcionamiento seguro y permitir una observacion m ´ | as clara ´
932 | del movimiento durante las pruebas y la operacion normal, se decidi ´ | o limitar la velocidad m ´ | axima ´
933 | de trabajo a 37.5 rpm (225°/s). Este valor proporciona un margen adecuado para evitar perdidas de ´
934 | pasos y asegurar desplazamientos suaves y controlados en todas las articulaciones.
935 | 15.4. Comunicacion ROS2/microROS ´
936 | En esta etapa se ensayo la comunicaci ´ | on entre el orquestador (la computadora en este caso) y ´
937 | el robot (el microcontrolador STM32). Como se menciono anteriormente, se debieron configurar ´
938 | múltiples cosas. De manera algorítmica, se puede listar un paso a paso para poder conectar el agente
939 | microROS a la computadora:
940 | 1. Preparacion del entorno en el host ´ | : En la computadora que ejecutara ROS2 se utiliza Docker ´
941 | para desplegar el entorno del microROS Agent. Este contenedor incluye todas las dependencias
942 | necesarias (DDS, transportes, compiladores y herramientas) y evita configuraciones manuales
943 | en el sistema operativo.
944 | 2. Obtencion de las herramientas de microROS para CubeMX ´ | : En el entorno de desa-
945 | rrollo del firmware se clonan los repositorios de micro ros setup (https://github.com/micro-ROS/micro_ros_setup/tree/humble) (con soluciones listas) o
946 | micro ros stm32cubemx utils (https://github.com/micro-ROS/micro_ros_stm32cubemx_utils) (para el caso de una placa generica ST). Estas utilidades permi- ´
947 | ten generar automaticamente el c ´ | odigo de integraci ´ | on entre el microcontrolador, FreeRTOS y ´
948 | el cliente microROS (rclc).
949 | 3. Generacion del proyecto STM32 ´ | : se puede usar cualquier IDE o editor, en el caso de este
950 | proyecto se uso STMCube IDE, por lo tanto se adapt ´ | o con Cube MX. Se genera el proyecto ´
951 | con los modulos necesarios: soporte UART, inicializaci ´ | on del RTOS, asignaci ´ | on de memoria ´
952 | y creacion de la tarea encargada de ejecutar el cliente microROS. ´
953 | 4. Configuracion del transporte microROS ´ | : Se configura UART con DMA circular y se regis-
954 | tran las funciones de apertura, cierre, lectura y escritura con rmw uros set custom transport.
955 | Esta capa adapta la comunicacion ROS2 al hardware embebido. ´
956 | 5. Inicializacion del cliente microROS ´ | : En la tarea principal de FreeRTOS se configuran el
957 | asignador de memoria, el soporte rclc, el nodo microROS, y los publicadores y suscriptores.
958 | Ademas, se crea un executor que administra la ejecuci ´ | on de callbacks cuando llegan mensajes ´
959 | desde el agente.

960 | 6. Lanzamiento del microROS Agent en Docker: Se descarga con Docker el entorno de com-
961 | pilacion preconfigurado. En el host se ejecuta el contenedor Docker del microROS Agent, que ´
962 | actúa como puente entre ROS2 y el microcontrolador. El agente traduce mensajes DDS/RTPS
963 | a un transporte serial o UDP, y los reenvía al cliente microROS. El agente se inicia de la
964 | siguiente manera:

965
966 | 1 | ros2 run micro_ros_agent micro_ros_agent serial --dev <device > -v6
967 | 2
968
Inicializacion de Agente (device: dispositivo USB por ejemplo) ´
969 | 7. Conexion y operaci ´ | on´ : Una vez que el microcontrolador inicia su tarea microROS, establece
970 | comunicacion con el agente. A partir de ahora y gracias al Agente, microROS se empieza a ´
971 | ver como un nodo.
972 | Un detalle que vale aclarar es que durante estas pruebas hubo errores con el manejo de colas en
973 | los callbacks que son ejecutados por, valga la redundancia, el executor. Para esto, se debe asegurar
974 | un correcto limpiado de los elementos que son consumidos, y se debe prestar especial atencion´
975 | al tipo de datos que se cargan, ya que en la creacion de las mismas se define el tama ´ | no de cada ˜
976 | elemento. Otro detalle importante es que la interfaz serial (UART) encargada de la comunicacion´
977 | ROS/microROS, este configurada con DMA y el canal Rx debe ser ´ | Circular.
978 | La solucion que se brind ´ | o fue la siguiente: antes de insertar el dato, verificar si la cola est ´ | á
979 | llena; en ese caso, eliminar el elemento mas antiguo para asegurar que el valor actualizado pueda ´
980 | almacenarse. Luego, intentar colocar el nuevo mensaje en la cola y reportar un error si la operacion´
981 | no pudo completarse. De esta manera, la funcion garantiza que siempre exista un ´ | setpoint vigente
982 | sin bloquear la ejecucion del sistema. ´

983
984 1
985 2 | // Poner message type Point en queue
986 3 | osStatus_t xStatus; // container para Overwrite wrapper
987 4 | CARTESIAN_POS_t dummy;

988 5
989 6 | if ( osMessageQueueGetSpace ( mid_PositionQueue ) == 0) {
990 7 | osMessageQueueGet (mid_PositionQueue , &dummy , NULL , 0); // eliminar
991 | el mas antiguo
992 8 | }
993 9 | xStatus = osMessageQueuePut (mid_PositionQueue , &xSetpointToSend ,
994 | osPriorityNormal , 10);
99510 | if (xStatus != osOK) {
99611 | printf( "Could not send to the queue.\r\n" );
99712 | } 998

Fragmento de escritura en cola

### 15.5. Ensayo de Area de trabajo del robot ´ 999

1000 | Se calculo el espacio de trabajo f ´ | ísico del robot en MATLAB en un plano X Z, donde solo las
1001 | articulaciones q2 y q3 pueden moverse. Esto se realizo en un c ´ | alculo iterativo de la cinem ´ | atica ´
1002 | directa del robot, sabiendo los angulos m ´ | aximos y m ´ | ínimos dados por el rango articular. la Figura
1003 | 30 representa este espacio de trabajo, que si se puede observar, se lo limito a puntos con ´ | z ≥ 0 para
1004 | tener como límite mínimo de z al plano base del robot (z = 0).

img/teorical_ws.png

Figura 30: Espacio de trabajo teorico ´

1005 | Este espacio de trabajo es teorico, es decir que no representa en su totalidad el movimiento del ´
1006 | robot, ya que el mismo tiene limitaciones físicas que impiden lograr ciertos angulos. Se realizaron ´
1007 | ensayos empíricos que demuestran que no todo el rango de angulos de las articulaciones ´ | q2 y q3
1008 | es alcanzable, sino que existen colisiones dadas por la geometría de los eslabones. Se genero una ´
1009 | tabla (Figura 31) que combina q2 y q3 donde se colorean las celdas de verde si esa combinacion es ´
1010 | alcanzable dentro del espacio de trabajo, sino de color rojo.

img/ws_table_modified.png

Figura 31: Espacio de trabajo articular con restriccion´ z = 0

1011 | La Figura 32 presenta un zoom de la esquina superior derecha de la tabla, donde se pueden
1012 | observar los pares de angulos v ´ | alidos dentro del espacio de trabajo. Con esta informaci ´ | on, se realiz ´ | ó

1013 | un nuevo calculo de los puntos en el espacio teniendo en cuenta las limitaciones f ´ | ísicas, que se puede
1014 | observar en la Figura 33.

img/ws_table_zoom.png

Figura 32: Espacio de trabajo articular (Zoom)

img/physical_ws.png

Figura 33: Espacio de trabajo real, plano XZ

1015 | Se observo que existe un reducido rango de posiciones alcanzables en el plano ´ | z = 0, mientras
1016 | que a mayor altura se iba incrementando. Se opto por “elevar” la base de posicionamiento de piezas ´
1017 | a 40mm de la base del robot para tener mayor rango en este plano.
1018 | Este ensayo permitio encontrar experimentalmente los puntos del espacio de trabajo tanto carte- ´
1019 | siano como articular. Se guardo la tabla en formato ´ | .csv y durante la planificacion de una trayectoria, ´
1020 | cada punto es verificado consultando este archivo con el objetivo de comprobar que la posicion so- ´
1021 | licitada pertenece al espacio de trabajo. De esta manera, se evita intentar alcanzar posiciones no

1022 | alcanzables. En caso que algún punto se encuentre fuera del mismo, la trayectoria no es genera-
1023 | da. Como mejora futura, se propone implementar un algoritmo de planificacion que reprograme ´
1024 | automaticamente los puntos intermedios que queden fuera del espacio de trabajo para ajustarlos a ´
1025 | posiciones alcanzables; en cambio, si el punto inicial no pudiera ser alcanzado, el sistema debería
1026 | notificarlo mediante un mensaje de error claro y específico.
1027 | 15.6. Ensayo de vision artificial ´
1028 | En esta etapa se realizaron dos ensayos complementarios de vision artificial: uno basado en ´
1029 | tecnicas cl ´ | asicas con ´ | OpenCV y otro utilizando un modelo de deteccion por ´ | deep learning. El
1030 | objetivo principal fue evaluar la capacidad del sistema para identificar correctamente objetos dentro
1031 | del area de trabajo y obtener su posici ´ | on en coordenadas reales mediante la relaci ´ | on´ mm/px.
1032 | 15.6.1. Deteccion del patr ´ | on y c ´ | alculo de la relaci ´ | on mm/px ´
1033 | Se desarrollo un c ´ | odigo en Python utilizando ´ | OpenCV para detectar una figura rectangular o
1034 | cuadrada cuyas dimensiones son conocidas. Esta figura puede ser desde una tarjeta de debito/cr ´ | edito, ´
1035 | una placa impresa en 3D o hasta un cuadrado impreso (ver Figura 34). De esta manera, se utilizó
1036 | esta forma como patron que sirvi ´ | o como referencia geom ´ | etrica para calcular la relaci ´ | on mm/px, ´
1037 | necesaria para transformar coordenadas de imagen en coordenadas reales del robot.

img/calib_mm_px.png

Figura 34: Ensayo de calibracion para obtener relaci ´ | on mm/px ´
1038 | 15.6.2. Ensayo de deteccion mediante YOLOv11n ´
1039 | Ademas del procesamiento cl ´ | asico, se evalu ´ | o el modelo entrenado con ´ | YOLOv11n para la detec-
1040 | cion de herramientas pertenecientes al dataset propio del proyecto. El modelo demostr ´ | o capacidad ´

1041 | para identificar correctamente cada una de las clases consideradas, incluso ante variaciones mode-
1042 | radas de iluminacion, con exceso de brillo, con piezas superpuestas entre s ´ | í y con piezas recortadas
1043 | en los límites de la imagen.
1044 | Una vez detectado un objeto y conocido el centro de su bounding-box, fue posible determinar
1045 | su posicion real respecto del origen del robot utilizando la relaci ´ | on mm/px previamente calibrada. ´
1046 | Para esto se emplea la Ecuacion´ 38, que permite transformar coordenadas de imagen al sistema de
1047 | referencia del robot.
1048 | Es importante remarcar que, para garantizar la validez de esta conversion, fue necesario fijar ´
1049 | tanto la posicion del robot como la de la c ´ | amara, evitando desplazamientos relativos que pudieran ´
1050 | modificar la calibracion. La precisi ´ | on obtenida depende directamente de la estabilidad mec ´ | anica del ´
1051 | montaje y de una correcta determinacion del factor ´ | mm/px.
1052 | Como se puede apreciar en la Figura 35, se realizo la correcta detecci ´ | on de la herramienta y fue ´
1053 | posible encontrar el centro de la bounding-box, donde se realizo la conversi ´ | on a ´ | mm y se referenció
1054 | este punto respecto al origen del robot.

img/ensayo_pos_yolo.png

Figura 35: Ensayo de deteccion de herramientas y posicionamiento respecto origen del robot ´

1055 | Es importante realizar una aclaracion respecto a la metodolog ´ | ía empleada en este ensayo. Si
1056 | bien el modelo de deteccion fue entrenado utilizando múltiples entidades de cada herramienta, ´
1057 | algunas de ellas presentan variaciones de altura dentro de su misma categoría. Esta condicion no ´
1058 | resulta compatible con la suposicion utilizada durante la planificaci ´ | on del movimiento, donde se ´
1059 | considera una única altura representativa por clase de objeto. De esta manera, el uso de diversas
1060 | entidades en el entrenamiento tuvo como objetivo principal mejorar la robustez del modelo de vision, ´
1061 | mientras que en la practica del proceso de manipulaci ´ | on, se requiere que los objetos de una misma ´
1062 | categoría mantengan la misma altura. Si se aceptaran distintas alturas por cada objeto, se requerirían
1063 | subcategorías de cada herramienta, lo cual se considera trabajo a futuro como mejora del proyecto.
1064 | 15.7. Ensayo de trayectoria
1065 | Con el objetivo de evaluar el desempeno del sistema de control, se realiz ˜ | o un ensayo de segui- ´
1066 | miento de trayectoria, en el cual el robot debía recorrer un perfil previamente planificado, de forma

1067 | que se registro en todo momento el error de posici ´ | on de cada articulaci ´ | on. La trayectoria realizada ´
1068 | es la de la Figura 24. El analisis se centr ´ | o en comparar la referencia generada por el planificador con ´
1069 | la respuesta real medida mediante los sensores angulares integrados en cada eje.
1070 | En una primera aproximacion, el control se plante ´ | o como un seguimiento punto a punto de la ´
1071 | posicion y la velocidad de referencia. Sin embargo, se observ ´ | o que el uso exclusivo de la velocidad ´
1072 | calculada por la trayectoria no resultaba suficiente para garantizar un seguimiento preciso. Esto se
1073 | debe a que el modelo cinematico no contempla ciertos efectos presentes en el sistema real: por un ´
1074 | lado, los motores Paso a Paso poseen una velocidad mínima efectiva para producir movimiento, por
1075 | debajo de la cual no se generan pasos; por otro, aparecen fenomenos como vibraciones, peque ´ | | | nas ˜
1076 | holguras mecanicas y no idealidades en la transmisi ´ | on. De esta manera, asumir que cada articulaci ´ | on´
1077 | reproducira fielmente velocidades arbitrariamente bajas conduce a errores acumulativos durante el ´
1078 | movimiento.
1079 | Para mitigar estos efectos, se cerro el lazo utilizando la medici ´ | on de posici ´ | on de cada articulaci ´ | on. ´
1080 | Se implemento un control proporcional sobre la velocidad, tomando como referencia el error de ´
1081 | posicion instant ´ | aneo. El esquema adoptado se describe mediante las siguientes ecuaciones: ´
qerror = qre f − current angle | (55)
| | vnew = vre f + Kp · qerror | | (56)
Siendo qre f y vre f ¹⁰⁸² | la posicion y velocidad de referencia en cada instante de la trayectoria. Este ´
1083 | planteo combina un termino ´ | feedforward de velocidad (vre f ), que impone la trayectoria deseada, con
1084 | un termino proporcional de realimentaci ´ | on ( ´ | Kp · qerror), encargado de corregir desvíos. Cuando el
1085 | error de posicion se reduce, el comportamiento est ´ | a dominado por la velocidad planificada, mientras ´
1086 | que ante errores significativos, el termino proporcional adquiere mayor peso, incrementando o ´
1087 | reduciendo la velocidad según el eje se encuentre atrasado o adelantado respecto de la referencia de
1088 | posicion. De esta forma, el sistema compensa desviaciones en tiempo real sin modificar la estructura ´
1089 | general del plan de movimiento.
1090 | El parametro ´ | Kp fue ajustado experimentalmente, buscando un compromiso entre rapidez de
1091 | correccion y estabilidad del movimiento. Valores bajos produc ´ | ían un seguimiento no muy preciso,
1092 | mientras que valores muy elevados generaban oscilaciones y mayor sensibilidad al ruido. Como
1093 | se muestra en las Figuras 36, 37 y la Tabla 4, el valor Kp = 5,0 resulto ser el m ´ | as adecuado ´
1094 | para el sistema implementado, permitiendo un seguimiento cercano a la trayectoria teorica sin ´
1095 | introducir inestabilidades apreciables. A partir de este valor, no se apreciaron aportes significativos
1096 | a la reduccion de error de posici ´ | on. Se pudo observar que aproximadamente a mitad de la trayectoria ´
1097 | de la articulacion 1 (cuando alcanza velocidad m ´ | axima), existe un error de posici ´ | on que no logr ´ | ó
1098 | ser compensado con el aumento de Kp, por lo tanto, una posible mejora podría ser un control
1099 | proporcional-derivativo.
| Kp
| 0.0 | 1.0 | 2.0 | 3.0 | 4.0 | 5.0
q error1 | 19.88 | 9.77 | 8.54 | 7.92 | 7.53 | 7.44
q error2 | 19.09 | 3.65 | 1.89 | 1.07 | 1.07 | 1.07
q error3 | 12.05 | 5.92 | 3.76 | 2.76 | 2.15 | 1.75
Tabla 4: Comparacion de m ´ | aximos valores absolutos de errores en la trayectoria respecto a ´ | Kp

img/compk0.png | img/compk1.png
img/compk2.png | img/compk3.png
img/compk4.png | img/compk5.png
Figura 36: Comparacion de trayectorias real y te ´ | orica con sus respectivas ganancias ´

img/errorsk0.png | img/errorsk1.png
img/errorsk2.png | img/errorsk3.png
img/errorsk4.png | img/errorsk5.png

Figura 37: Errores de posicion con sus respectivas ganancias ´

1100 | 15.8. Ensayo completo
1101 | El funcionamiento del sistema de control distribuido depende de una secuencia de inicializacion´
1102 | para la comunicacion mediante el protocolo XRCE-DDS entre el orquestador (ROS2) y el nodo ´
1103 | embebido (microROS).
1104 | Prerrequisitos del Sistema: antes de iniciar el despliegue de los nodos, se deben verificar las
1105 | siguientes condiciones operativas:
1106 | Servidor de Vision: ´ | el servidor de vision artificial debe estar iniciado y en estado de escucha ´
1107 | para el procesamiento de imagenes en tiempo real. ´
1108 | Compilacion del Espacio de Trabajo: ´ | el workspace de ROS2 debe estar correctamente
1109 | construido mediante la herramienta colcon build.
1110 | Hardware: el microcontrolador STM32F446RE debe estar conectado por UART/USB, con
1111 | los permisos de puerto configurados (e.g., sudo chmod 666 /dev/ttyACM0).
1112 | Firmware: el firmware basado en FreeRTOS y microROS debe estar cargado y en ejecucion´
1113 | en el target embebido.

1114 Para iniciar el servidor de vision se debe ejecutar el siguiente comando de ejemplo: ´

1115
1116 1 | python3 yolo_with_socket .py --model best.pt --source /dev/video2 --thresh 0.75
1117 | --resolution 1280 x720 1118
1119 | Los argumentos usados son:
1120 | model: archivo con los mejores pesos del entrenamiento
1121 | source: fuente de las imagenes, en este caso la c ´ | amara. En el caso de estar en un sistema ´
1122 | operativo Linux, para encontrar el dispositivo se puede ejecutar el comando:
1123 | v4l2-ctl --list-devices
1124 | thresh: es el umbral a partir del cual detectara objetos, representado como flotante entre 0 y ´
1125 | 1. Valores bajos pueden involucrar que el sistema detecte ruido, detectando así objetos que no
1126 | formaron parte del dataset. Por defecto tiene el valor de 0,75
1127 | resolution: resolucion de la c ´ | amara. Se debe llegar a una soluci ´ | on de compromiso entre ´
1128 | resolucion y detecci ´ | on precisa de objetos del dataset (baja resoluci ´ | on implica m ´ | as FPS pero ´
1129 | puede bajar la precision de la detecci ´ | on). Por defecto, para la c ´ | amara del proyecto se utiliza ´
1130 | 1280 × 720
1131 | mm px: relacion de mm ´ | px calculada previamente. Se ha fijado un valor por defecto de 0,236
1132 | que corresponde a que los objetos detectados se encuentran a 40mm respecto de la base del
1133 | robot, pero hay que tener en cuenta que una variacion de la resoluci ´ | on de la c ´ | amara o distancia ´
1134 | camara/objetos modificar ´ | a este valor ´
1135 | Secuencia de Ejecucion de Nodos: ´ | Para que el sistema funcione correctamente, se debe seguir
1136 | el orden de ejecucion detallado en la Tabla ´ | 5. Es crítico que el agente y el nodo de vision est ´ | en´
1137 | operativos antes de lanzar el planificador.
Orden | Componente | Comando de ejecucion´
1 | Agente microROS | ros2 run micro ros agent micro ros agent serial --dev [puerto] -v6
2 | Talker | ros2 run robot control talker
3 | Trajectory Planner | ros2 run robot control trajectory planner
4 | Interfaz de Usuario | ros2 run robot control robot ui

Tabla 5: Protocolo de inicio para el sistema distribuido ROS2 / microROS

1138 | Funcionalidades del Nodo de Interfaz: El nodo robot ui (Figura 38) actúa como el punto de
1139 | entrada para el operador, permitiendo la interaccion con el brazo rob ´ | otico mediante las siguientes ´
1140 | funciones principales:
1141 | 1. Control Directo y Gestion de Estado (Opciones 1, 2, 4, 5 y 7): ´ | se envían comandos directos
1142 | al robot. Esto incluye rutinas de homing, consignas de posicion directa ( ´ | Cinematica directa ´ | )
1143 | y el control del electroiman. Incluye funciones de seguridad, como la gesti ´ | on de la parada de ´
1144 | emergencia (E-Stop), y permite la solicitud de telemetría para visualizar la posicion articular ´
1145 | real reportada por el microcontrolador a traves del t ´ | opico de retroalimentaci ´ | on. ´

1146 | 2. Cinematica Inversa (Opci ´ | on 3): ´ | permite el envío de coordenadas cartesianas (x, y, z) me-
1147 | diante mensajes de tipo geometry msgs/Point. El sistema realiza una validacion previa ´
1148 | de los datos de entrada contra los límites físicos del espacio de trabajo antes de publicar la
1149 | consigna para el calculo de los ´ | angulos articulares. Actualmente, esta opci ´ | on es solo para ´
1150 | validacion, ya que el planificador de trayectoria genera consignas articulares directamente. ´
1151 | 3. Configuracion de Rangos de Validaci ´ | on (Opci ´ | on 6): ´ | habilita la modificacion de los l ´ | ímites
locales de la interfaz para variables articulares (◦
1152 | ) y cartesianas (metros). Esta funcion opera ´
1153 | exclusivamente de forma interna en el nodo de UI para filtrar comandos fuera de rango, por lo
1154 | que no genera trafico de comunicaci ´ | on con el resto de los nodos del sistema. ´
1155 | 4. Comunicacion Externa (Opci ´ | on 9): ´ | implementa un cliente de sockets para la solicitud de
1156 | pedidos a un servidor externo. Esta funcion requiere la existencia previa de un archivo ´ | .csv
1157 | que contenga los objetos a solicitar.

img/ros_ui.png

Figura 38: Interfaz de usuario

1158
1159 1 | # Ejecucion del agente en Ubuntu 22.04
1160 2 | ros2 run micro_ros_agent micro_ros_agent serial --dev /dev/ttyACM0 -b 115200 1161
| Ejemplo de ejecucion del agente microROS ´
1162 | En el esquema propuesto se define el punto A como la posicion en el espacio asociada a cada ´
1163 | objeto detectado en el area de trabajo, mientras que el punto ´ | B corresponde a una ubicacion fija ´
1164 | y conocida que representa el contenedor final (caja, pallet o deposito). El procedimiento completo ´
1165 | se estructura como un ciclo repetitivo de manipulacion que parte siempre desde la posici ´ | on de ´
1166 | referencia o homing, garantizando condiciones iniciales conocidas para cada operacion. ´
1167 | El ensayo comienza con la lectura de un archivo .csv que contiene la lista de objetos solicitados
1168 | en el pedido. Este archivo es cargado a traves de la interfaz gr ´ | afica (Opci ´ | on 9), lo que permite ´
1169 | inicializar la secuencia de tareas. Una vez cargada la lista, el nodo Talker, que opera como cliente
1170 | socket, establece comunicacion con el servidor de visi ´ | on artificial. Para cada elemento de la lista, el ´
1171 | cliente envía una solicitud con el nombre del objeto (por ejemplo, “tuerca”).

1172 | El servidor procesa la imagen adquirida por la camara, ejecuta el modelo de detecci ´ | on y responde ´
1173 | con la posicion tridimensional del objeto en un formato codificado como cadena de caracteres: ´
1174 | Xx.xYy.yZz.z donde cada valor representa las coordenadas cartesianas del punto A en el sistema
1175 | de referencia del robot. En caso de que el objeto no sea detectado dentro del campo visual, el servidor
1176 | devuelve X0.0Y0.0Z0.0, lo cual actúa como condicion de error o ausencia. ´
1177 | El nodo cliente decodifica la cadena recibida, separando los valores de X, Y y Z, y construye así el
1178 | punto objetivo A. Con esta informacion, el planificador de trayectorias genera la primera trayectoria ´
1179 | en línea recta Homing ⇒ A. Una vez alcanzado este punto, se activa el electroiman para efectuar ´
1180 | la sujecion de la pieza. Posteriormente, se calcula y ejecuta la segunda trayectoria: ´ | A ⇒ B donde
1181 | pasa por un punto intermedio y se genera una trayectoria como la de la Figura 25. Al llegar al punto
1182 | B, el electroiman se desactiva para liberar el objeto en el contenedor. Finalmente se ejecuta la tercer ´
1183 | trayectoria en línea recta: B ⇒ Homing restableciendo la condicion inicial del robot. ´
1184 | Este ciclo completo se repite secuencialmente para cada elemento contenido en el archivo .csv,
1185 | hasta procesar la totalidad del pedido. De esta manera, el sistema implementa un flujo automatizado
1186 | de tipo pick-and-place, integrando percepcion, planificaci ´ | on de trayectoria y control del efector final ´
1187 | dentro de una arquitectura distribuida basada en comunicacion por ´ | sockets. En la Figura 39 se puede
1188 | ver el sistema completo.

img/robot_real2.jpg

Figura 39: Foto real del robot realizando pick-and-place

1189 | 16. Futuras mejoras
1190 | Si bien el sistema robotico cumpli ´ | o con las expectativas, es necesario considerar que existen ´
1191 | múltiples mejoras a implementar a futuro que mejoran el rendimiento, la robustez y permiten
1192 | acercarse mas a implementaciones de robots industriales: ´
1193 | 1. Servomotor en efector final: para que el efector final pueda realizar rotaciones. Esto permitiría
1194 | ampliar la versatilidad del manipulador, facilitando tareas que requieran orientacion precisa ´
1195 | de la pieza, como ensamblado o posicionamiento angular específico.
1196 | 2. Gripper en efector final: para que tenga la posibilidad de sujetar piezas de distintos materiales
1197 | y geometrías. De este modo, el sistema podría adaptarse a aplicaciones mas variadas. ´
1198 | 3. Control PD: para mitigar aún mas los errores durante la trayectoria. La incorporaci ´ | on de ´
1199 | una accion derivativa contribuir ´ | ía a mejorar la respuesta dinamica del sistema, reduciendo ´
1200 | vibraciones y tiempos de establecimiento.
1201 | 4. Sistema en Tiempo Real: debería asegurarse determinismo a la hora de enviar las consignas
1202 | desde el orquestador al robot. Esto relacionado al envío de consignas desde el orquestador al
1203 | microcontrolador (requiere construir el kernel en el sistema operativo -Linux por ejemplo)
1204 | 5. Interfaz de usuario: necesaria para generar consignas y para mover el robot en modo Jog. Se
1205 | podría tener una interfaz mas amigable para el usuario, como as ´ | í automatizar la inicializacion´
1206 | de los nodos que forman parte del sistema.
1207 | 6. Generacion de trayectoria ´ | : realizar trayectorias de manera mas intuitiva y asegurar en todo ´
1208 | momento encontrarse dentro del espacio de trabajo, en caso que se intente alcanzar un punto
1209 | fuera de este, recalcularlo. Otra opci ´ | on compatible con ´ | ROS es usar la librería moveIt para
1210 | enviar las consignas en alto nivel. Ademas, se podr ´ | ía implementar una trayectoria vertical a
1211 | velocidad reducida al acercarse al objetivo de carga/descarga, tal como realizan los automatas ´
1212 | con funcion´ pick-and-place.
1213 | 7. Ampliar dataset: agregando imagenes del entorno normal de operaci ´ | on para evitar falsa ´
1214 | deteccion de objetos y agregar objetos similares a cada categor ´ | | | ía para evitar overfitting.
1215 | Ademas, que existan subcategor ´ | ías por cada una de las ya existentes para ampliar la base de
1216 | datos de alturas.
1217 | 8. Vision artificial: ´ | reemplazar la camara actual con una estereosc ´ | opica para realizar un c ´ | alculo ´
1218 | automatico de la altura del objeto y que de esta manera se calcule la relaci ´ | | | on´ px/mm de
1219 | manera dinamica. ´
1220 | 9. Evitar colisiones: usar la camara ya existente para poder detectar elementos extra ´ | nos y ˜
1221 | lanzar algún mensaje de error/alarma y frenar el movimiento, en el caso de que el robot esté
1222 | moviendose. ´
1223 | 10. Generacion de algoritmos de b ´ | usqueda ´ | : tal como A*, para evitar colisiones de objetos en el
1224 | espacio de trabajo y evitar llegar a limites articulares. Mas detalles y mas soluciones pueden ´
1225 | ser encontradas en [Lynch, 2017].
1226 | 11. Automatizacion de pedidos ´ | : que exista un algoritmo de Inteligencia Artificial capaz de
1227 | encontrar las mejores trayectorias en funcion de múltiples pedidos. ´

1228 | 12. Mejoras de ROS: mejoras de bajo costo de implementacion, que contribuyen a la simulaci ´ | on´
1229 | y al analisis del comportamiento del robot. Por ejemplo, el uso de ´ | ROS bag para hacer testing
1230 | y debug, y tambien Gazebo para la creaci ´ | on de entornos virtuales, o incluso el desarrollo de ´
1231 | un digital twin del sistema.

1232 | 17. Conclusiones
1233 | Durante la ejecucion del proyecto, aparecieron numerosos retos relacionados con limitaciones ´
1234 | en la practica y alteraciones de dise ´ | no no contempladas desde el principio. Espec ˜ | íficamente, los
1235 | problemas de precision y la necesidad de un redise ´ | no electromec ˜ | anico alargaron el tiempo dedicado ´
1236 | a la programacion, ya que fue preciso incluir nuevos sensores junto con su l ´ | ogica de control y las ´
1237 | adaptaciones electronicas necesarias. ´
1238 | Se concluye del proceso que para optimizar los recursos y reducir correcciones, es importante
1239 | una planificacion adecuada y un modelado estricto desde el principio. Esto se considera relevante ´
1240 | en cada etapa del proyecto, desde la idea inicial hasta la implementacion final. ´
1241 | En este desarrollo, implementartopicsse considero suficiente para cumplir con los requerimientos ´
1242 | definidos. Si se define un comportamiento similar para los callbacks asociados a los mismos, puede
1243 | llegar a haber algún conflicto. Esto se solvento definiendo una m ´ | aquina de estados y manejo de colas ´
1244 | FIFO en el RTOS que aseguro que los llamados sean no simult ´ | | aneos. ´
1245 | Por limitaciones de tiempo, no se pudo terminar todas las funcionalidades proyectadas. Se decidió
1246 | descartar el modulo MQTT, ya que al analizarlo se vio que el aporte de este a la eficiencia general ´
1247 | del sistema era escaso en comparacion con el esfuerzo adicional que supon ´ | | | ía su incorporacion. ´
1248 | El desarrollo del sistema robotico paralelo pick-and-place implementa tecnolog ´ | | | ías que se estan´
1249 | usando en la industria e hizo posible comprobar la union exitosa de cuatro campos esenciales: ´
1250 | planificacion de movimiento, visi ´ | on artificial, control de motores Paso a Paso y gesti ´ | on de sistema ´
1251 | operativo en tiempo real (FreeRTOS + microROS). Durante el desarrollo del proyecto, se verificó
1252 | que la arquitectura sugerida tiene la capacidad de identificar objetos en el area de trabajo, calcular las ´
1253 | trayectorias requeridas y llevar a cabo los movimientos del manipulador con una precision adecuada ´
1254 | para realizar su funcion log ´ | ística simulada.
1255 | Se lograron mediciones exactas gracias a la calibracion de los sensores AS5600 y a la implemen- ´
1256 | tacion de un proceso sistem ´ | atico para referenciar los ´ | angulos articulares, lo cual fue fundamental ´
1257 | para el adecuado desempeno de la cinem ˜ | atica inversa. Adem ´ | as, los ensayos con el electroim ´ | an´
1258 | posibilitaron la determinacion experimental de los l ´ | ímites operativos del sistema de sujecion. ´
1259 | En cuanto a la vision artificial, los ensayos realizados con m ´ | etodos tradicionales de OpenCV ´
1260 | y modelos de inferencia basados en YOLOv11n demostraron que se puede identificar y localizar
1261 | objetos con buena exactitud, siempre que el sistema tenga una calibracion espacial apropiada y una ´
1262 | referencia constante de posicion entre la c ´ | amara y el robot. Esto hizo posible obtener con precisi ´ | | on´
1263 | la ubicacion de los objetos y convertirla al sistema de coordenadas del manipulador para llevar a ´
1264 | cabo el ciclo completo de pick-and-place.
1265 | La cinematica inversa, que se calcul ´ | o y valid ´ | o en MATLAB al principio, demostr ´ | o un correcto ´
1266 | funcionamiento cuando fue trasladada al STM32, desde donde las instrucciones articulares se produ-
1267 | jeron correctamente. Esta migracion prob ´ | o que fue factible implementar los algoritmos directamente ´
1268 | en el hardware de control sin poner en riesgo la velocidad de respuesta del sistema. Aún así, cabe
1269 | destacar que para tener mayor facilidad de validacion en la generaci ´ | on de trayectorias, se opt ´ | o por ´
1270 | realizar la cinematica inversa en el orquestador (ROS2 en la computadora). ´
1271 | El conjunto de ensayos realizados (mecanicos, electr ´ | onicos, de comunicaci ´ | on, de control y de ´
1272 | vision) hizo posible verificar que el robot funciona conforme al modelo te ´ | orico y que las resolu- ´
1273 | ciones de diseno tomadas se convierten en un proceso estable. El sistema resultante ofrece una ˜
1274 | plataforma firme para futuros trabajos que se enfoquen en optimizar la velocidad, la exactitud del
1275 | posicionamiento, la robustez del sistema de vision y la autonom ´ | ía general del manipulador.

1276 | Referencias
1277 | [BSp, 2001] (2001). B-splines and their properties. https://pages.cs.wisc.edu/˜deboor/ (https://pages.cs.wisc.edu/~deboor/toast/)
1278 | toast/. (https://pages.cs.wisc.edu/~deboor/toast/) Accessed: 2026-10-15.
1279 | [YOL, 2024] (2024). Ros 2 interfaces overview. https://docs.ultralytics.com/models/ (https://docs.ultralytics.com/models/yolo11/)
1280 | yolo11/. (https://docs.ultralytics.com/models/yolo11/) Accessed: 2025-06-15.
1281 | [ros, 2025] (2025). Ros 2 interfaces overview. https://docs.ros.org/en/humble/Concepts/
1282 | Basic/About-Interfaces.html. (https://docs.ros.org/en/humble/Concepts/Basic/About-Interfaces.html) Accessed: 2025-02-20.
1283 | [Barrientos et al., 2007] Barrientos, A., Penin, L. F., Belaguer, C., and Aracil, R. (2007). ˜ | Funda-
1284 | mentos de Robotica ´ | . McGraw Hill.
1285 | [Barry, 2016] Barry, R. (2016). Mastering the FreeRTOS Real Timer Kernel: A Hands-On Tutorial
1286 | Guide.
1287 | [Belsare et al., 2023] Belsare, K., Rodriguez, A. C., Sanchez, P. G., Hierro, J., Ko lcon, T., Lange, ´
1288 | R., Lütkebohle, I., Malki, A., Losa, J. M., Melendez, F., Rodriguez, M. M., Nordmann, A.,
1289 | Staschulat, J., , and von Mendel, J. (2023). Micro-ROS, pages 3–55. Springer.
1290 | [Biagiotti and Melchiorri, 2008] Biagiotti, L. and Melchiorri, C. (2008). Trajectory Planning for
1291 | Automatic Machines and Robots. Springer Publishing Company.
1292 | [Corke, 2017] Corke, P. (2017). Robotics, vision and control: Fundamental algorithms in matlab®
1293 | second, completely revised, extended and updated edition. Springer Tracts in Advanced Robotics
1294 | №118.
1295 | [Craig, 2006] Craig, J. J. (2006). Robotica ´ | . Pearson Educacion. ´
1296 | [Lynch, 2017] Lynch, F. C. P. K. M. (2017). Modern Robotics: Mechanics, Planning, and Control.
1297 | Cambridge University Press.
1298 | [Mark W. Spong, 2005] Mark W. Spong, Seth Hutchinson, M. V. (2005). Robot Modeling and
1299 | Control. Wiley.
1300 | [Pieper, 1968] Pieper, D. L. (1968). The kinematics of manipulators under computer control.
1301 | [Torres et al., 2002] Torres, F., Pomares, J., Gil, P., Puente, S. T., and Aracil, R. (2002). Robots y
1302 | Sistemas Sensoriales. Pearson Educacion, S. A. ´
1303 | [Zhou et al., 2020] Zhou, Z., Zhang, X., Gao, Y., Wu, D., and Dong, W. (2020). Design and
1304 | kinematics analysis of a percutaneous needle insertion robotic system. IOP Conference Series:
1305 | Materials Science and Engineering, 825(1):012009.

1306 | 18. Anexo
1307 | 18.1. Teorema del coseno
1308 | Ampliamente usado en geometría, es muy útil para realizar desarrollos de cinematica inversa ´
1309 | geometrica de robots serie, como el caso de estudio. El mismo postula: ´
1310 | Sea un triangulo con lados ´ | a, b y c, opuestos a los angulos ´ | A, B y C respectivamente, entonces:

c

2 = a

2 + b

2 − 2 · a · b · cos(α)

a

b
c

α

Figura 40: Triangulo general donde se aplica el Teorema del Coseno. ´

1311 | 18.2. Colas FreeRTOS
1312 | Para poder comunicar entre distintas tareas o entre “callbacks” se usan colas de tipo FIFO
1313 | (First In, First Out) el funcionamiento esta explicado en detalle en [ ´ | | Barry, 2016]. Los elementos a
1314 | almacenar en las colas pueden ser de distinto tamano, por eso al crearlas se define el tama ˜ | no del dato ˜
1315 | a almacenar en cada elemento y la cantidad de elementos a almacenar.
1316 | El acceso a escribir datos en las colas se da según la prioridad de la tarea, y al llenarse el buffer se
1317 | mantiene la prioridad. Una vez liberado el primer elemento, se hace un desplazamiento de elementos
1318 | y la tarea con mas prioridad asigna el elemento a la última posici ´ | on de la cola. Tambi ´ | en existe el caso ´
1319 | de que el elemento provenga de una interrupcion (ISR), entonces este elemento pasa a tener mayor ´
1320 | prioridad y se ubica en la primer posicion de la cola. En la imagen ´ | | 41 (presentada en [Barry, 2016])
1321 | se puede ver una secuencia basica de lectura y escritura en colas. ´
1322 | A continuacion se muestra un ejemplo, en pseudoc ´ | odigo, para la creaci ´ | on de colas en el hilo ´
1323 | principal, antes de que el Scheduler tome el control:

1324
1325 1 INICIAR creacion de colas de comunicacion

1326 2
1327 3 | // Crear cola para posiciones cartesianas
1328 4 | crear cola PositionQueue con capacidad 1 elemento de tipo CARTESIAN_POS_t
1329 5 | si la cola no pudo crearse:
1330 6 | registrar error "No se pudo crear PositionQueue"

1331 7
1332 8 | // Crear colas individuales para cada motor
1333 9 | para i desde 0 hasta N_MOTORS - 1:
133410 | crear cola JointQueue [i] con capacidad 1 elemento tipo float
133511 | si la cola i no pudo crearse:
133612 | registrar error "No se pudo crear JointQueue[i]"

133713
133814 | FINALIZAR creacion de colas 1339
| | Pseudocodigo: manejo de colas
1340 | Se debe especificar el tamano de cada elemento y la cantidad de elementos que tiene cada cola. ˜

img/QueuesGraphic.jpeg

Figura 41: Funcionamiento de colas

1341 | 18.3. Interfaces internas de ROS
1342 | A nivel de capas de abstraccion, ROS cuenta con dos que son las principales: la interfaz de ´
1343 | librería de cliente, que es rcl (ROS Client Library), que brinda soporte a las librerías de cliente (la
1344 | capa superior) tales como rclcpp y rclpy; por otro lado esta la interfaz de ´ | Middleware, que abstrae
a rcl de las capas de implementacion de middleware espec ´ | íficas (Fast-DDS, Cyclone, etc)⁴
1345 | .
1346 | 18.4. Task de microROS
1347 | En el firmware, el RTOS ejecuta una tarea específica, en la cual esta el núcleo de microROS. En ´
1348 | primer lugar, se configura un transporte personalizado para microROS. En este caso, se emplea una
1349 | interfaz UART y se registran explícitamente las funciones de apertura, cierre, lectura y escritura del
1350 | canal físico. Posteriormente, se redefine el asignador de memoria por defecto de ROS2 mediante un
1351 | conjunto de funciones compatibles con FreeRTOS.
1352 | A continuacion, se inicializa la estructura rclc ´ | support, se crea el nodo microROS y se definen

4DDS: Data Distribution Service. Es un middleware estandarizado img/ros_internal_interfaces.png

Figura 42: Interfaces internas de ROS

1353 | los mensajes utilizados por los distintos canales de comunicacion. Se instancian suscriptores y ´
1354 | publicadores asociados a topicos espec ´ | íficos, cada uno enlazado a un tipo de mensaje en particular.
1355 | Finalmente, se configura un executor, el cual gestiona la ejecucion de las funciones de callback ´
1356 | cuando se reciben nuevos datos. El bucle principal de la tarea ejecuta periodicamente dicho executor, ´
1357 | asegurando el procesamiento continuo de mensajes entrantes desde el agente ROS2, mientras que
1358 | la interaccion con el planificador del sistema operativo se controla mediante retardos expl ´ | ícitos. las
1359 | funciones de finalizacion que se encuentran al final del bucle para realizar una limpieza de memoria ´
1360 | y evitar fugas; en el funcionamiento normal del microcontrolador, no se llega hasta este punto. El
1361 | codigo correspondiente se encuentra en el repositorio ´ | Proyecto Final de Estudios. (https://github.com/agustinlezcano/PFE/tree/main)
1362 | 18.5. ROS DOMAIN
1363 | El ROS DOMAIN ID es una variable de entorno de ROS2 que permite segmentar una red
1364 | física en múltiples redes logicas independientes. Su funci ´ | on principal es evitar la interferencia entre ´
1365 | diferentes grupos de robots o grupos de nodos que operan en la misma infraestructura, ya que solo
1366 | los nodos que comparten el mismo identificador de dominio pueden descubrirse y comunicarse entre
1367 | sí.
1368 | Para establecer la conexion, el middleware DDS utiliza este ID para calcular autom ´ | aticamente los ´
1369 | puertos UDP necesarios para el intercambio de datos y el descubrimiento de nodos. Específicamente,
1370 | cada dominio abre puertos de multicast que permiten a los nodos “anunciarse” y encontrarse dentro
1371 | de un grupo, ademas de puertos de ´ | unicast dedicados para la comunicacion directa entre procesos. ´
1372 | Al basarse en UDP, se tiene un descubrimiento dinamico y r ´ | apido en la red. ´

1373 | 18.6. Funcion de control de trayectoria ´
1374 | Se muestra a continuacion la funci ´ | on´ trajectoryControl en pseudocodigo, que ha sido ´
1375 | implementada en el STM32 y es encargada de controlar el seguimiento preciso de la trayectoria. La
1376 | funcion realiza las siguientes tareas: ´
1377 | 1. Calcula el error de posicion´
1378 | 2. Genera un comando de velocidad con feedforward y control proporcional
1379 | 3. Convierte la velocidad a steps/s
1380 | 4. Define la direccion según la velocidad ´
1381 | 5. Escribe la direccion al pin digital ´
1382 | 6. Establece la velocidad del PWM por motor

1383
1384 1 | funcion trajectoryControl (q_ref , qd_ref , m):
1385 2 | // Calcular error de posicion
1386 3 | q_err = q_ref - m. currentAngle

1387 4
1388 5 | // Calcular comando de velocidad (feedforward + feedback proporcional)
1389 6 | v_cmd = qd_ref + KP_POS * q_err

1390 7
1391 8 | // Convertir velocidad a Hz (pasos por segundo)
1392 9 | v_hz = valor_absoluto (v_cmd) * DEG_TO_STEPS * m.i

139310
139411 | // Limitar velocidad maxima y minima
139512 | si v_hz > 1000 entonces
139613 | v_hz = 1000
139714 | fin si

139815
139916 | si v_hz < 1 entonces
140017 | v_hz = 1 | // para evitar division por cero
140118 | fin si

140219
140320 | // Determinar direccion del motor
140421 | si v_cmd >= 0 entonces
140522 | m.dir = ENCENDIDO | // GPIO_PIN_SET
140623 | si no
140724 | m.dir = APAGADO | // GPIO_PIN_RESET
140825 | fin si

140926
141027 | // Actualizar direccion en el pin correspondiente
141128 | EscribirPin (m.DIR_PORT , m.DIR_PIN , m.dir)

141229
141330 | // Configurar velocidad del motor paso a paso
141431 | Stepper_SetSpeed (m.timer , m.timerChannel , v_hz)
141532 | fin funcion 1416

Pseudocodigo de trajectoryControl
