agustinlezcano/PFE/img/p01_homing.png

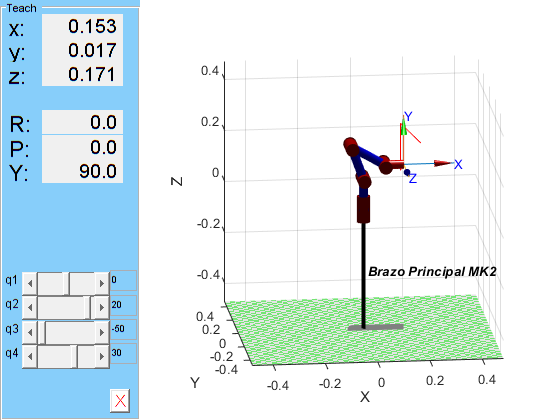
img/p01_homing.png
