agustinlezcano/PFE/img/p10_seguridad.png

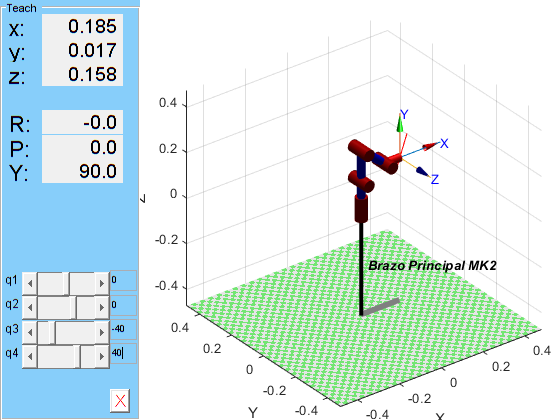
img/p10_seguridad.png
