agustinlezcano/PFE/img/p14_seguridad.png

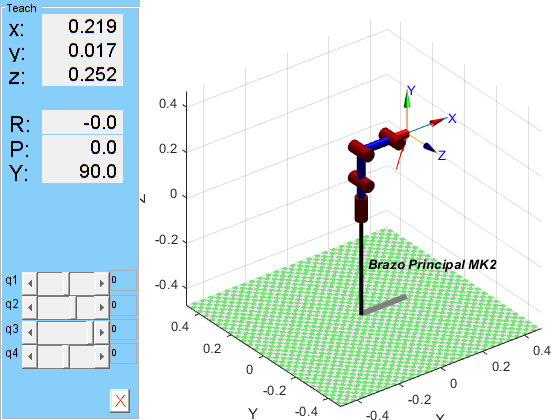
img/p14_seguridad.png
