agustinlezcano/PFE/img/p20_pick.png

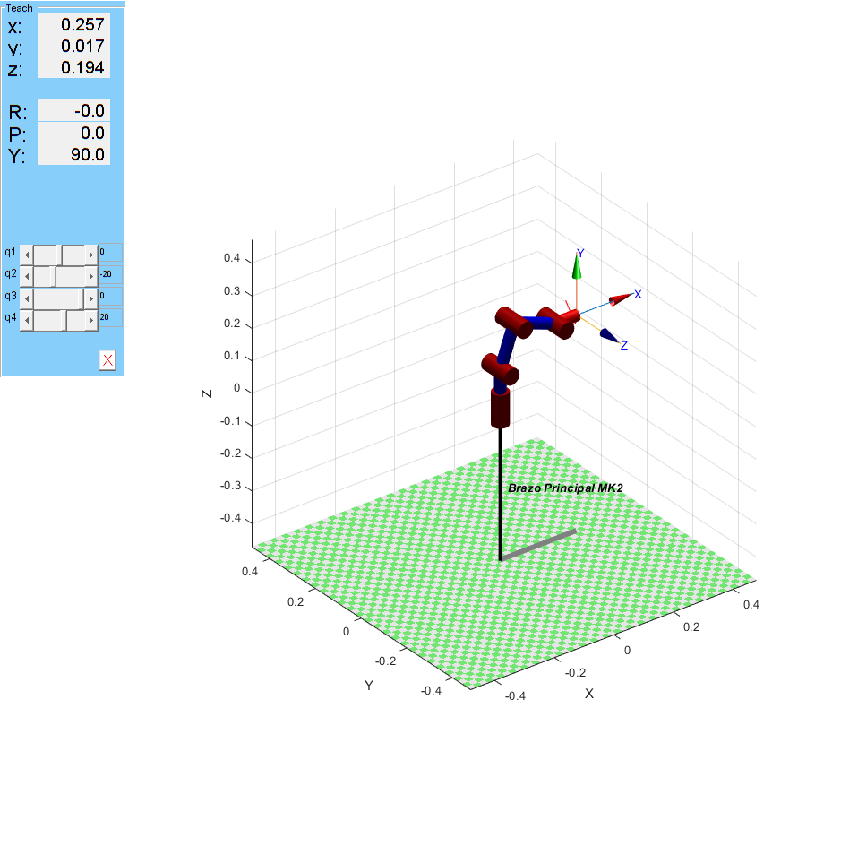
img/p20_pick.png
