agustinlezcano/PFE/img/p31_place.png

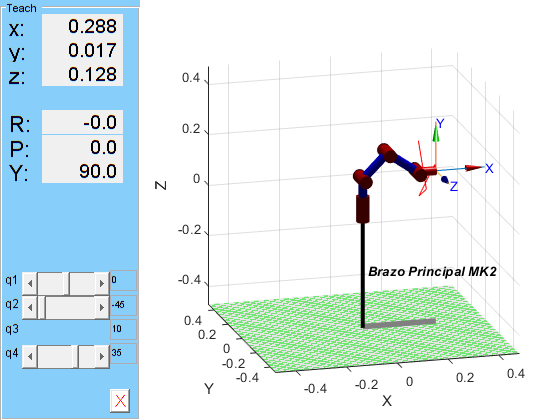
img/p31_place.png
