agustinlezcano/PFE/img/posicion_altura seguridad.png

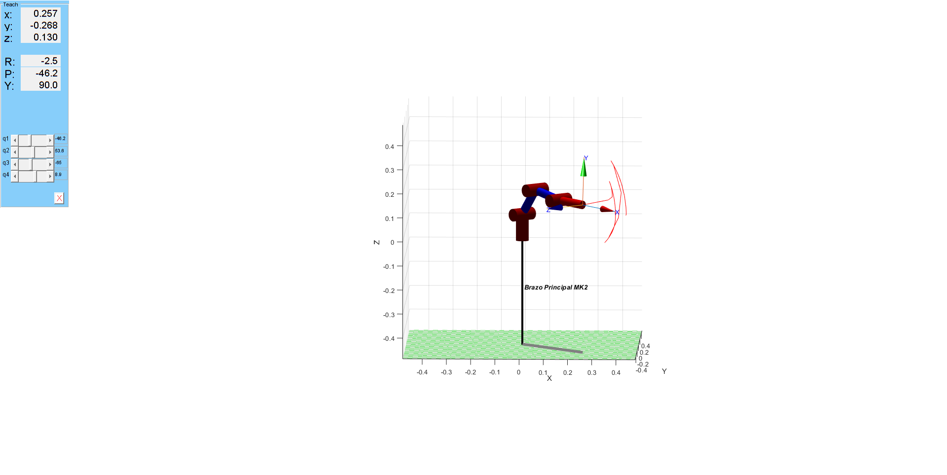
img/posicion_altura seguridad.png
