agustinlezcano/PFE/img/posicion_reposo.png

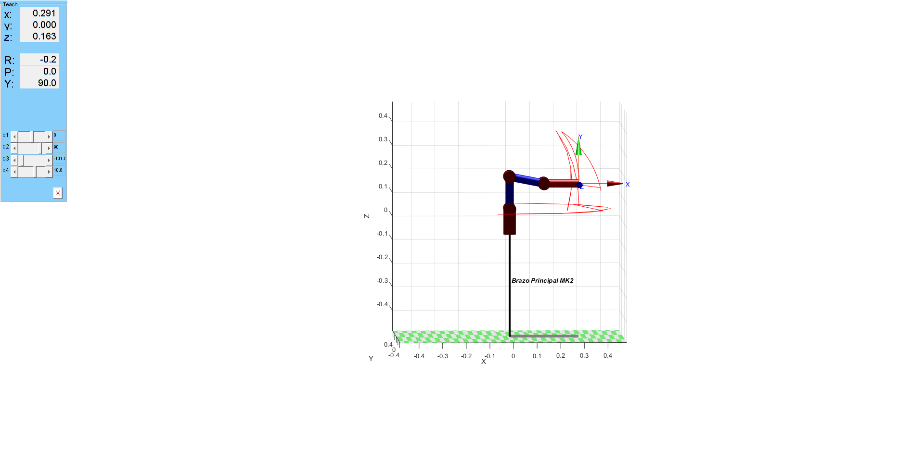
img/posicion_reposo.png
