agustinlezcano/PFE/Informe/img/AS5600.png

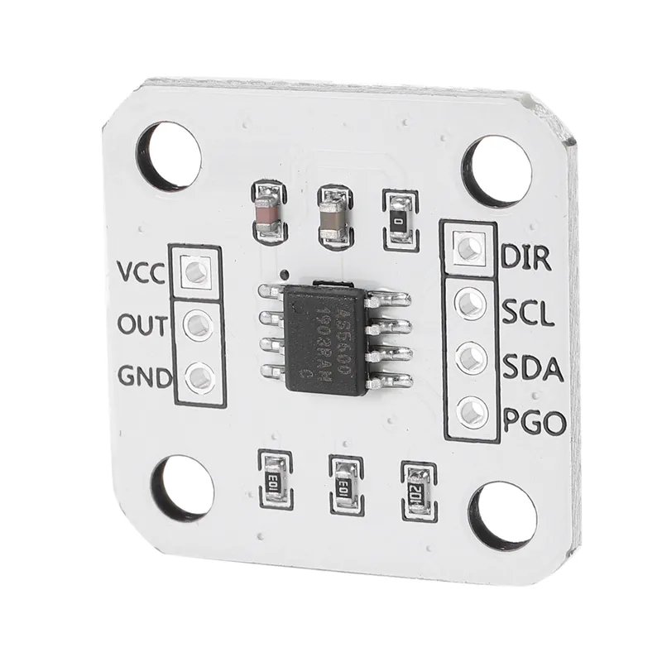
Informe/img/AS5600.png
