agustinlezcano/PFE/Informe/img/AS5600_polos_magneticos.png

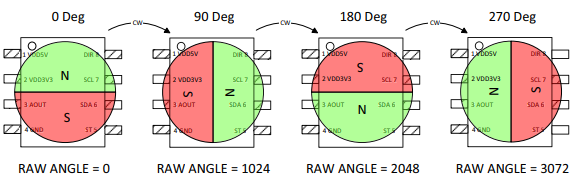
Informe/img/AS5600_polos_magneticos.png
