agustinlezcano/PFE/Informe/img/b_spline.png

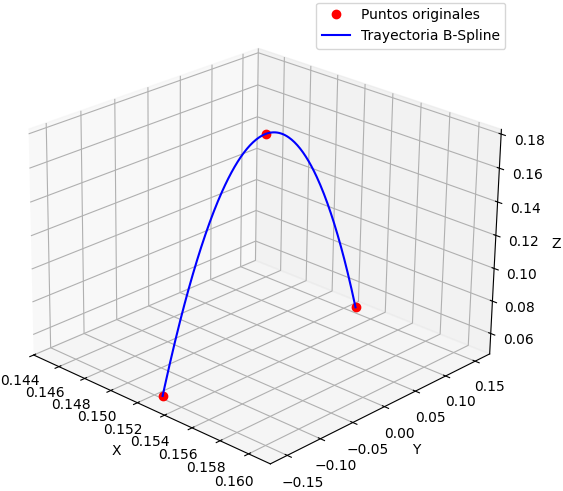
Informe/img/b_spline.png
