agustinlezcano/PFE/Informe/img/calib_mm_px.png

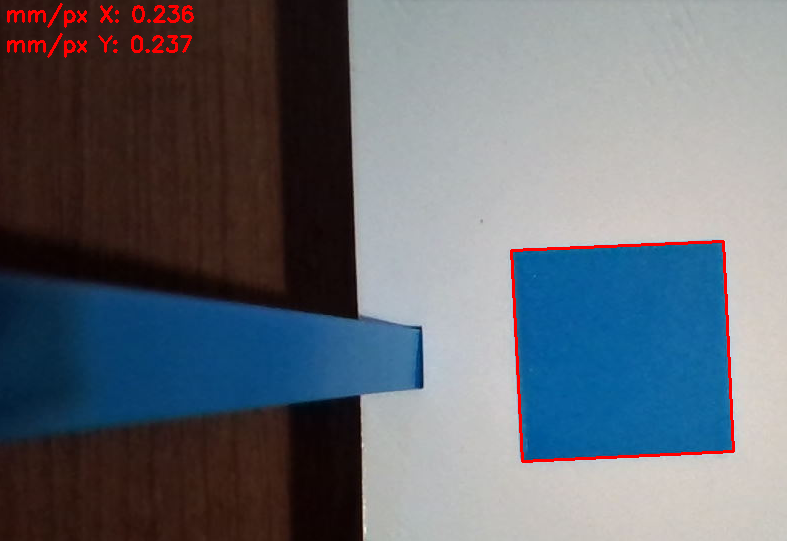
Informe/img/calib_mm_px.png
