agustinlezcano/PFE/Informe/img/cam_robot.png

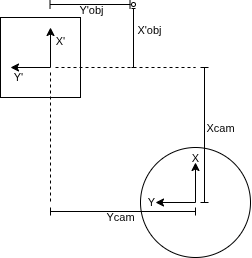
Informe/img/cam_robot.png
