agustinlezcano/PFE/Informe/img/cnc_shield.jpg

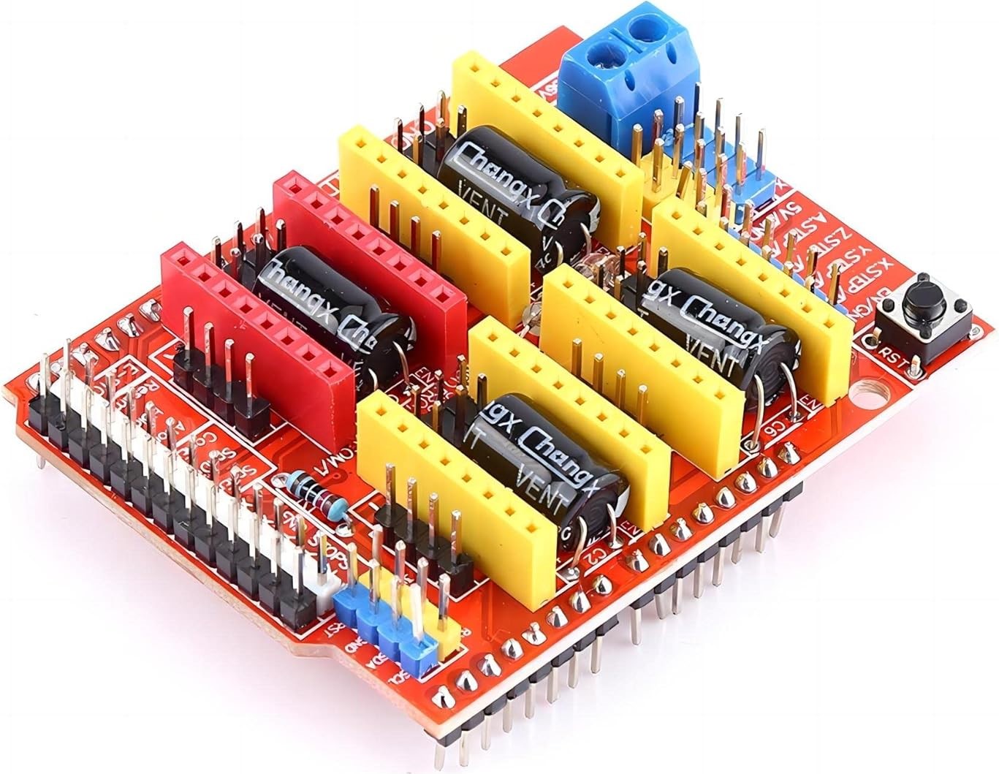
Informe/img/cnc_shield.jpg
