agustinlezcano/PFE/Informe/img/curvas_Q.png

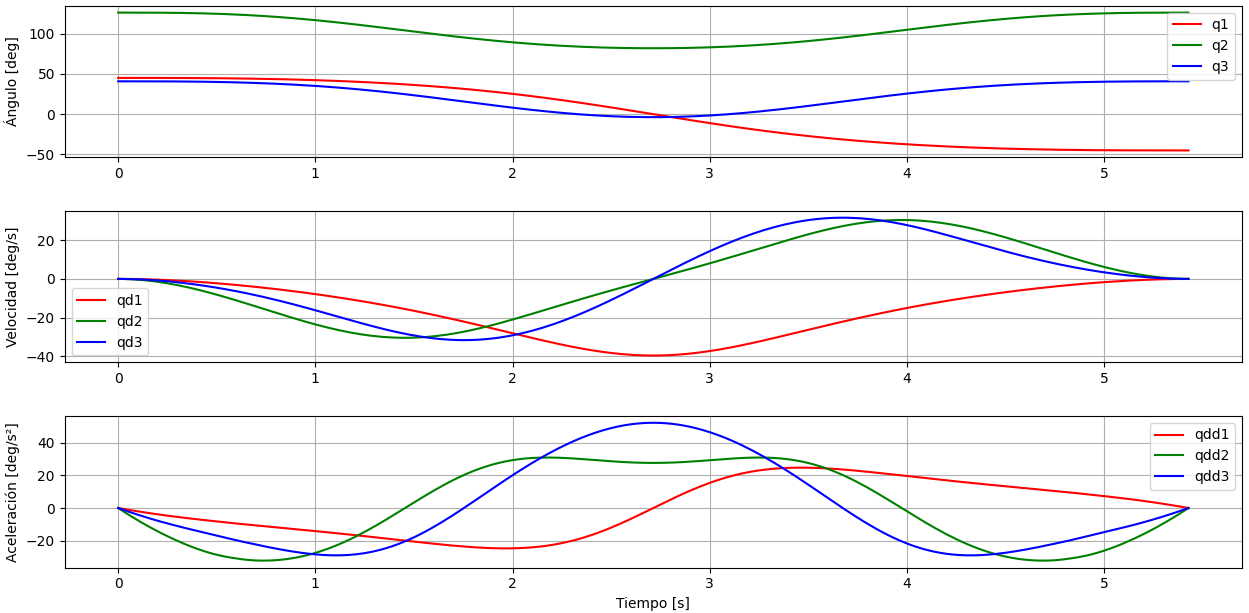
Informe/img/curvas_Q.png
