agustinlezcano/PFE/Informe/img/curvas_S.png

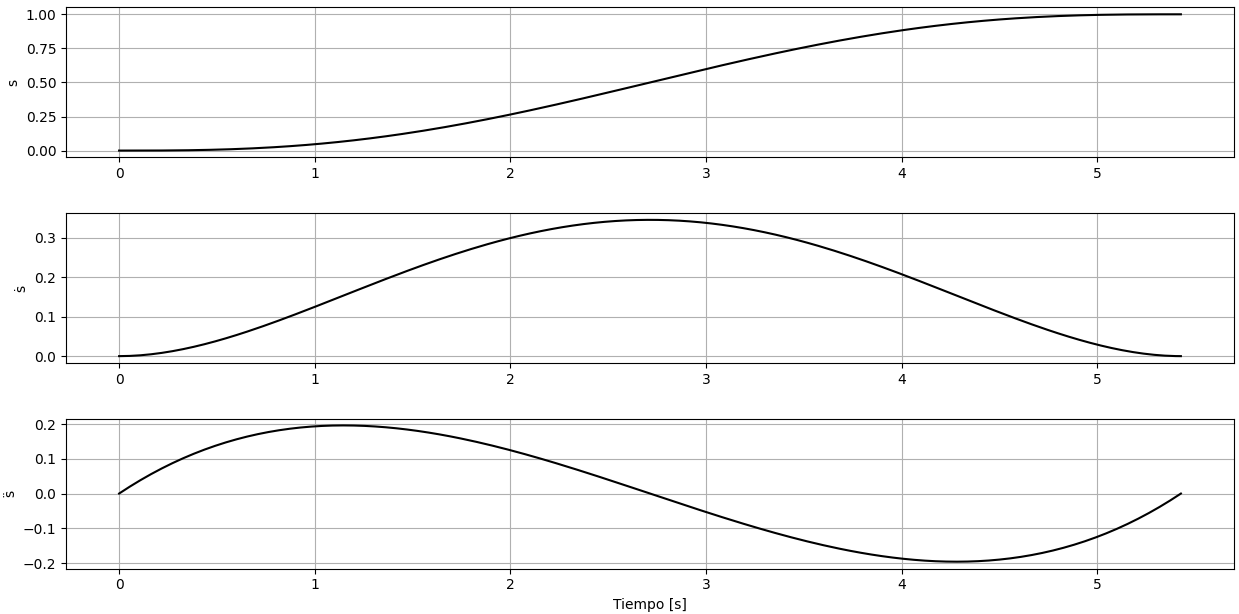
Informe/img/curvas_S.png
