agustinlezcano/PFE/Informe/img/DiagramaConex.png

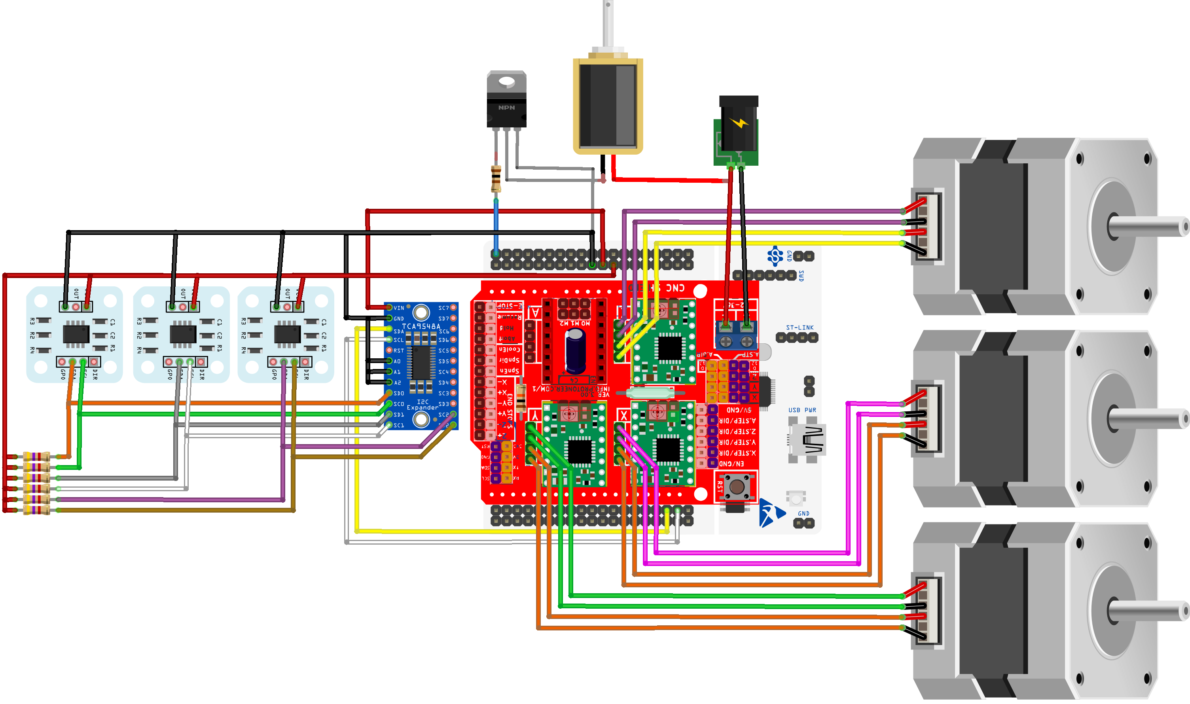
Informe/img/DiagramaConex.png
