agustinlezcano/PFE/Informe/img/diagramaObjetosROS.png

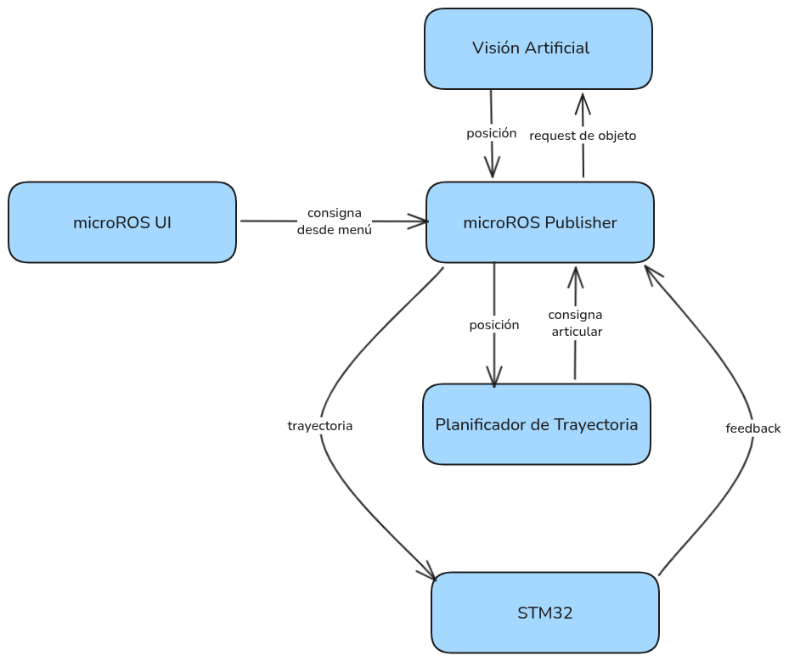
Informe/img/diagramaObjetosROS.png
