agustinlezcano/PFE/Informe/img/flujoDatoConsigna.png

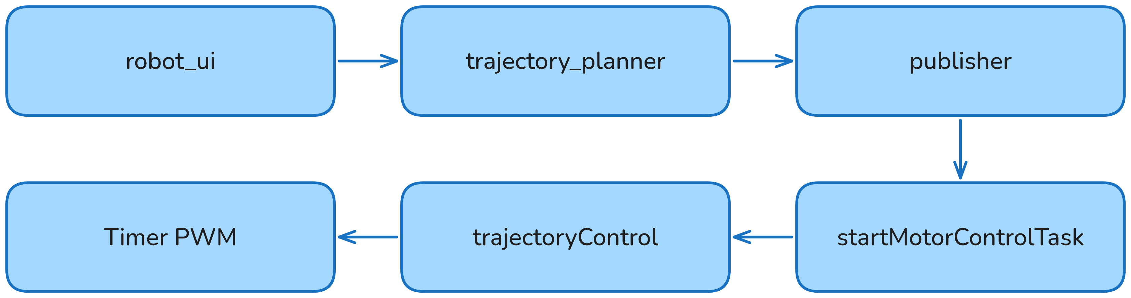
Informe/img/flujoDatoConsigna.png
