agustinlezcano/PFE/Informe/img/microROSerror_afterQueuesClean.png

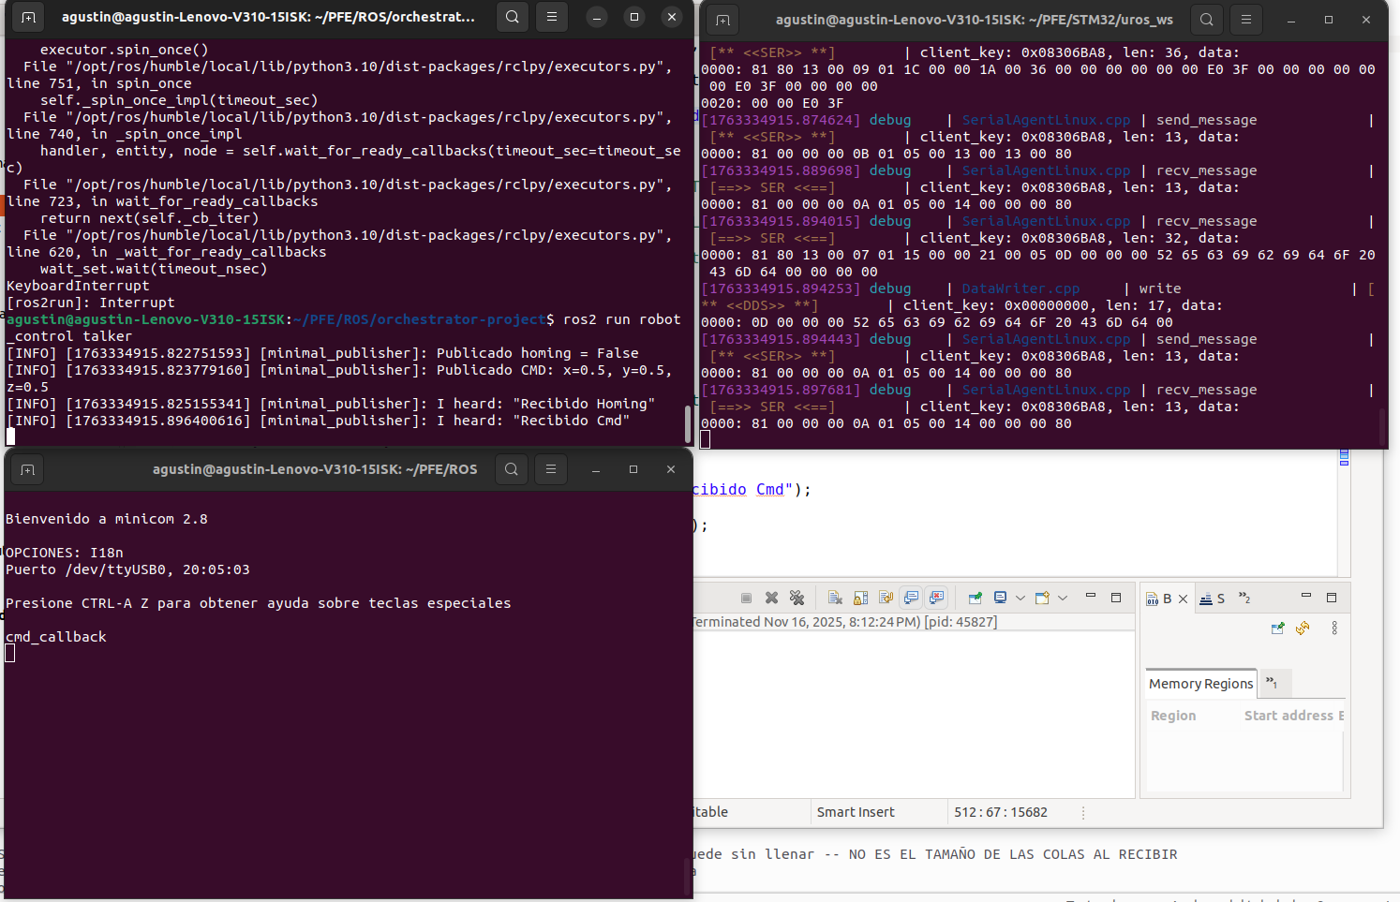
Informe/img/microROSerror_afterQueuesClean.png
