agustinlezcano/PFE/Informe/img/microROSerror_beforeQueuesClean.png

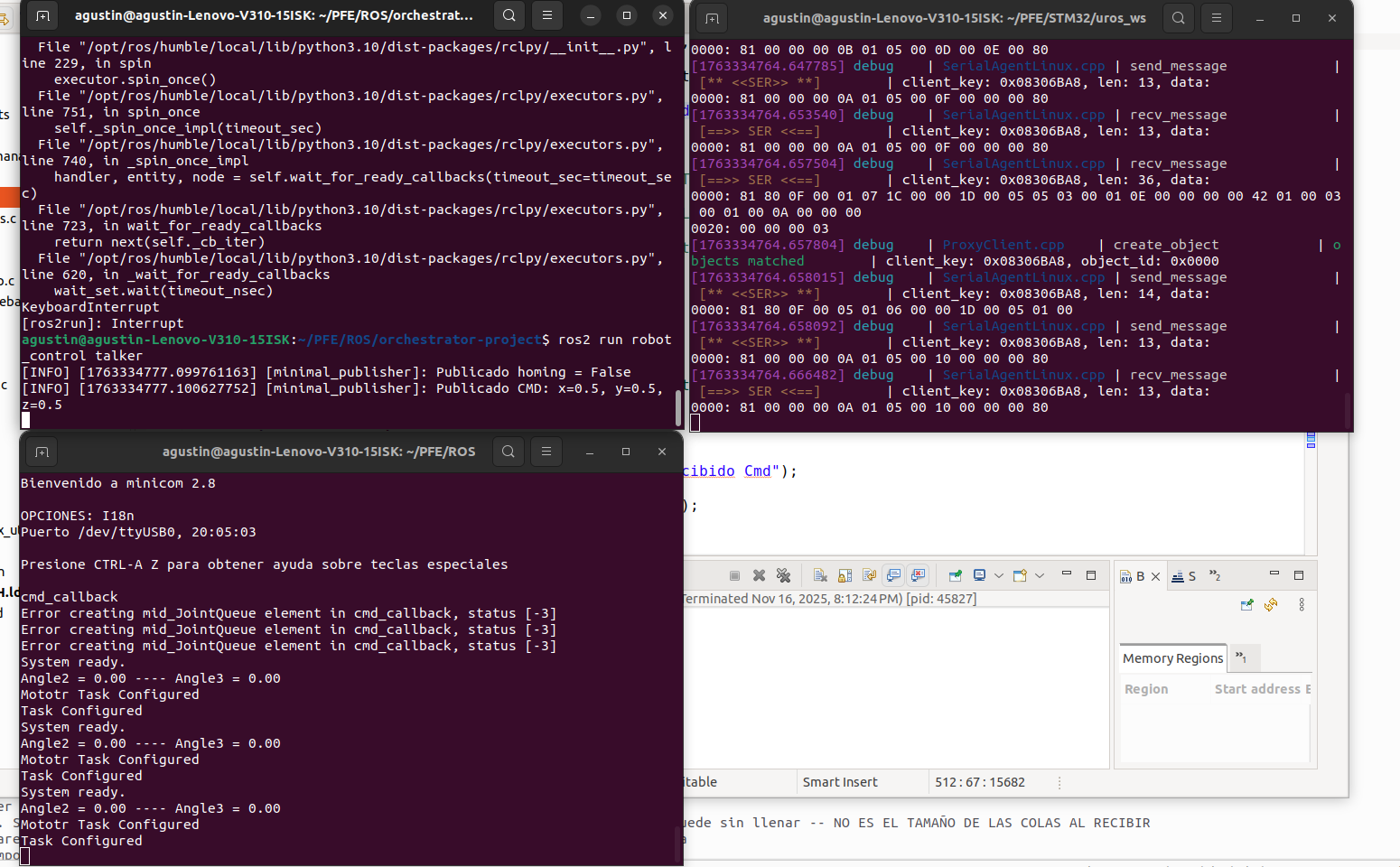
Informe/img/microROSerror_beforeQueuesClean.png
