agustinlezcano/PFE/Informe/img/microROSSuccess.jpeg

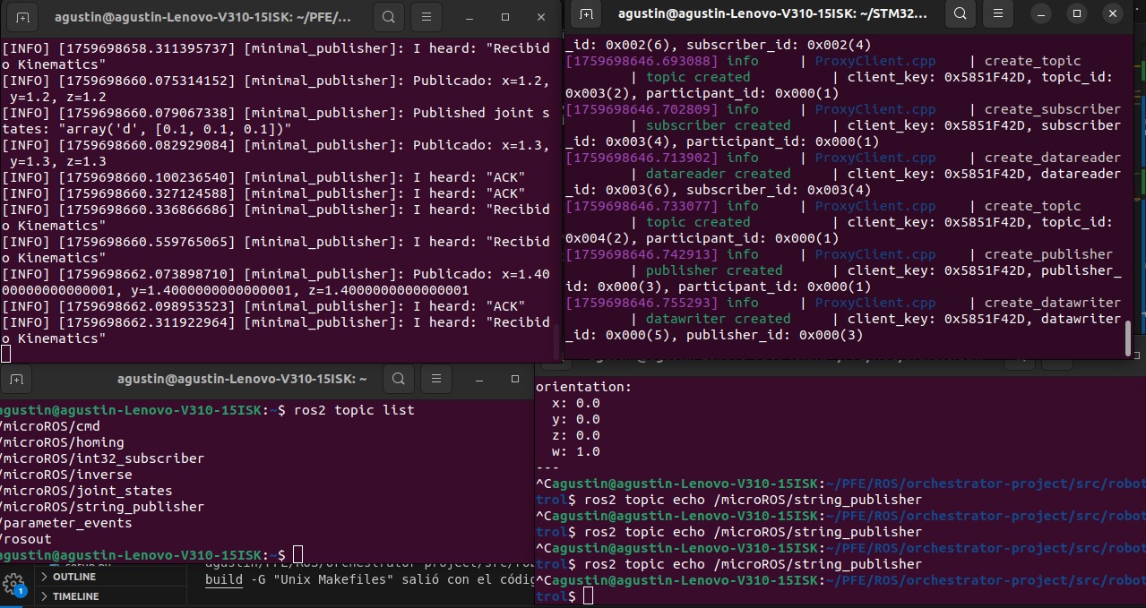
Informe/img/microROSSuccess.jpeg
