agustinlezcano/PFE/Informe/img/physical_ws.png

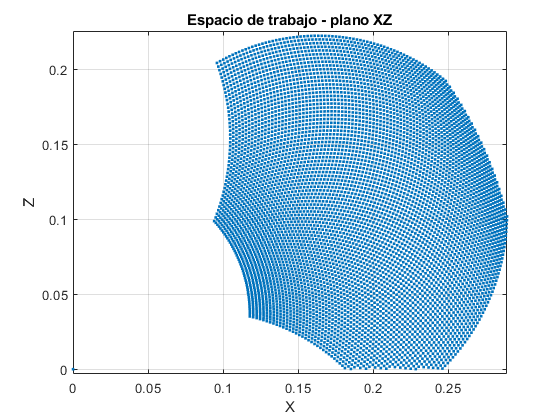
Informe/img/physical_ws.png
