agustinlezcano/PFE/Informe/img/resorte.png

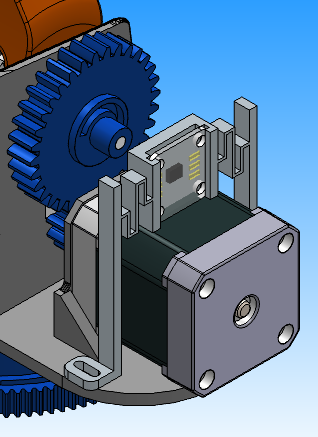
Informe/img/resorte.png
