agustinlezcano/PFE/Informe/img/robot_real.jpg

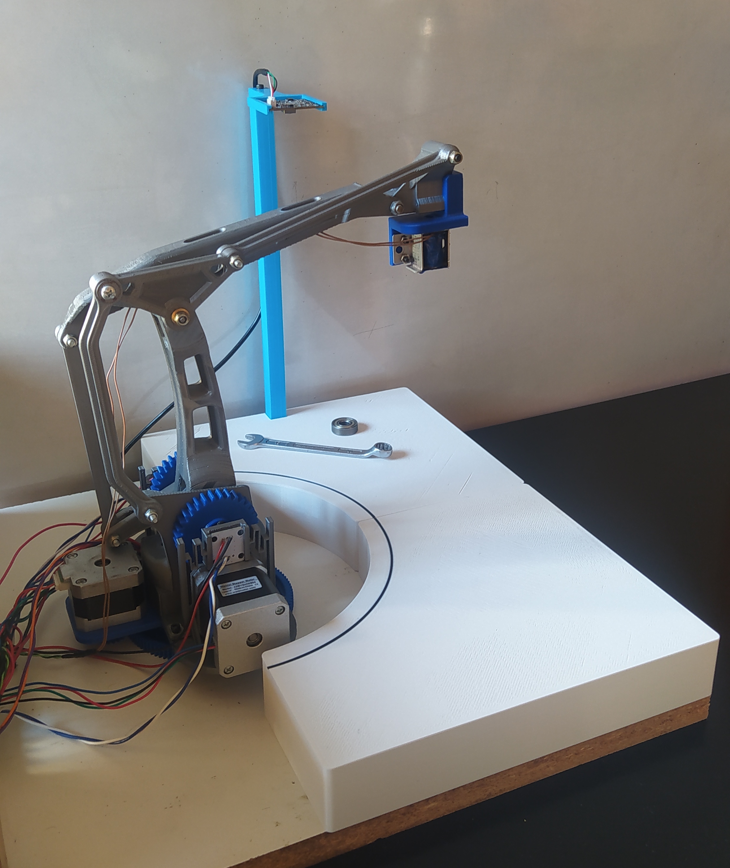
Informe/img/robot_real.jpg
