agustinlezcano/PFE/Informe/img/rosgraph.png

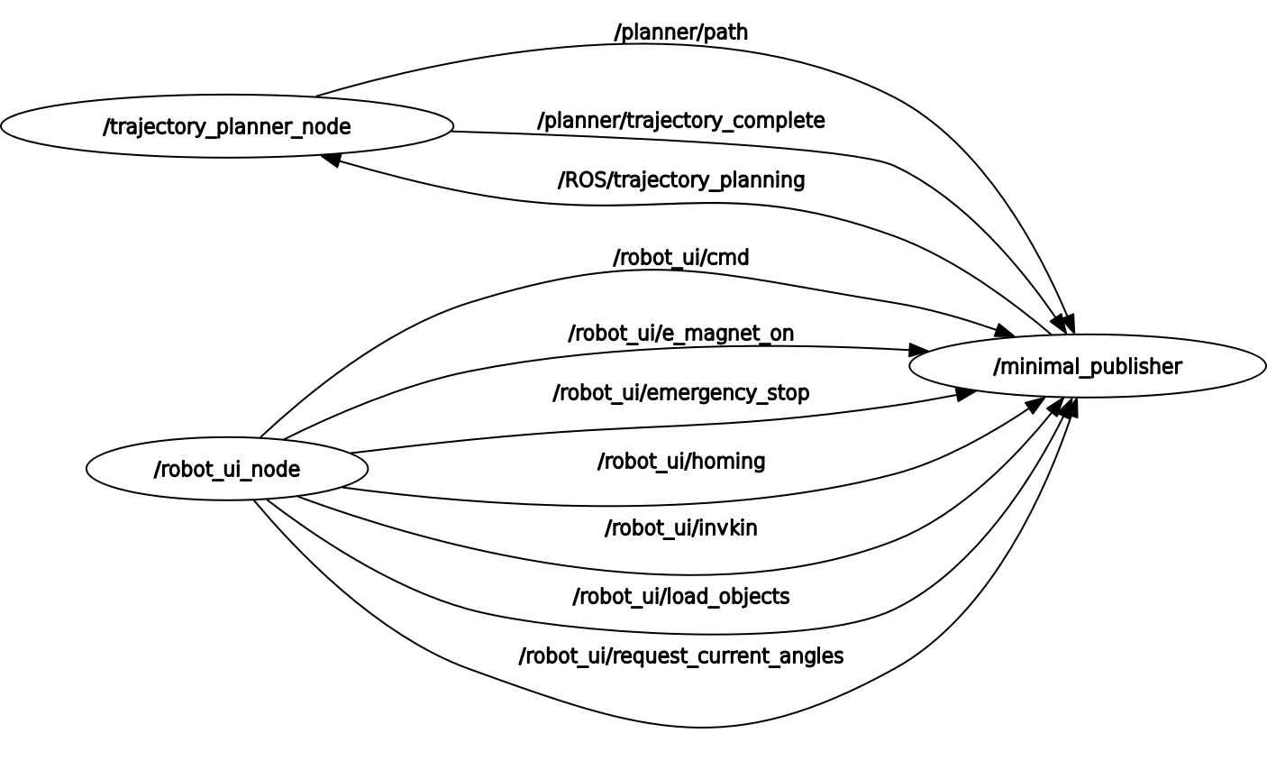
Informe/img/rosgraph.png
