agustinlezcano/PFE/Informe/img/STM32NUCLEO.jpg

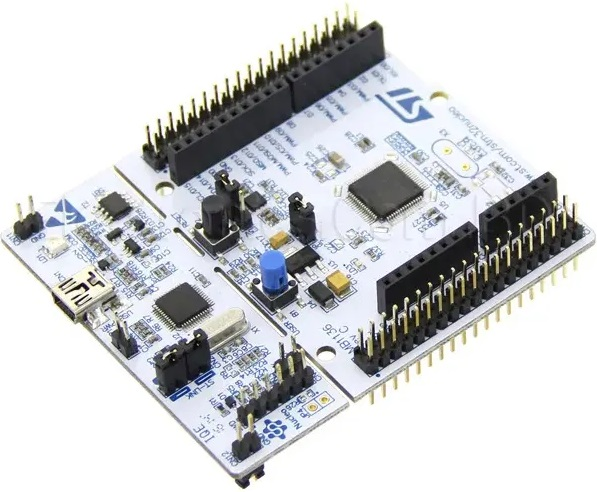
Informe/img/STM32NUCLEO.jpg
