agustinlezcano/PFE/Informe/img/tca9548a.jpg

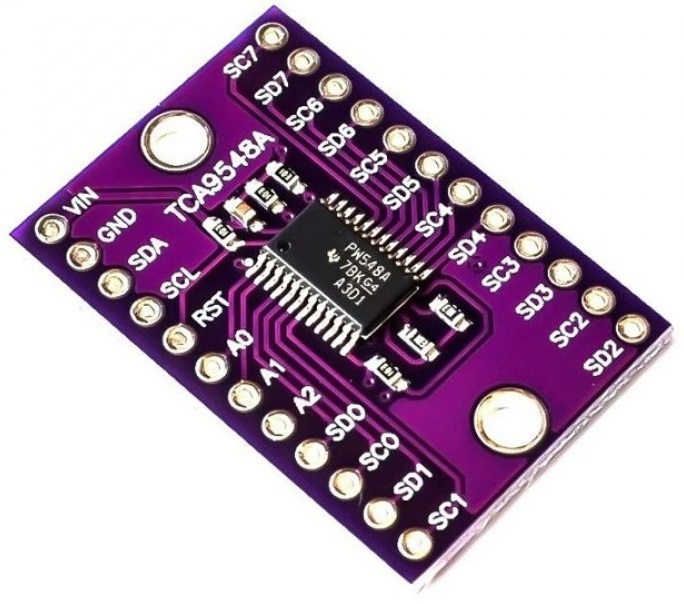
Informe/img/tca9548a.jpg
