agustinlezcano/PFE/Informe/img/ws_table_modified.png

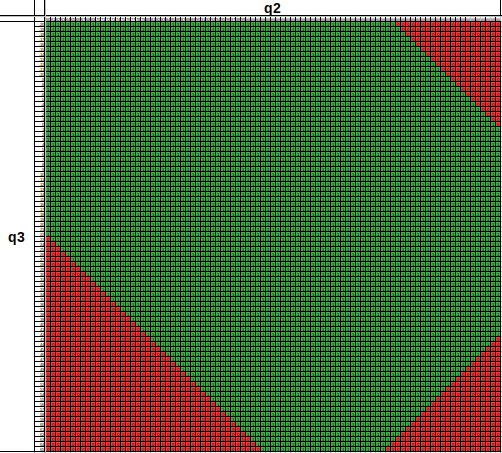
Informe/img/ws_table_modified.png
