agustinlezcano/PFE/Informe/img/ws_table_zoom.png

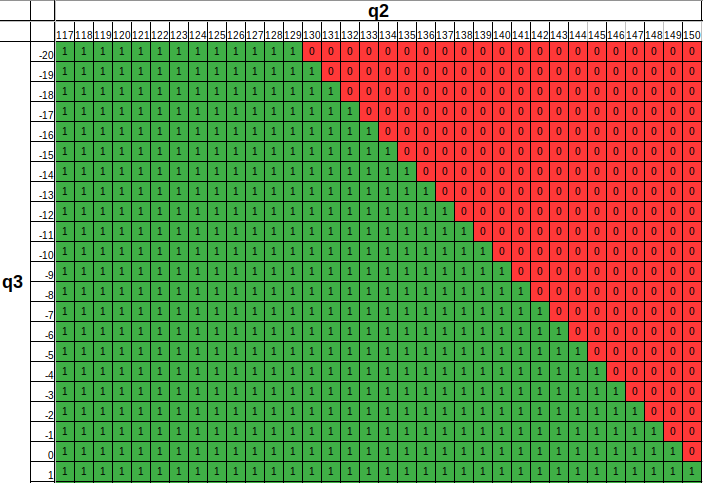
Informe/img/ws_table_zoom.png
