agustinlezcano/PFE/Robot/Robot_Arm_MK2_Plus__Stepper_Motor_in_Used__2520572/images/943f2b0aa171125a8fa14703ebe05ac9.jpg

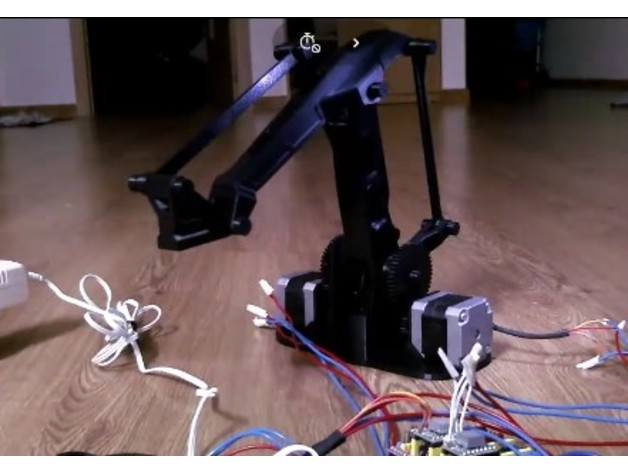
Robot/Robot_Arm_MK2_Plus__Stepper_Motor_in_Used__2520572/images/943f2b0aa171125a8fa14703ebe05ac9.jpg
