agustinlezcano/PFE/Robot/Robot_Arm_MK2_Plus__Stepper_Motor_in_Used__2520572/images/ba3c4c98c93af75635d910ba665bd638.jpg

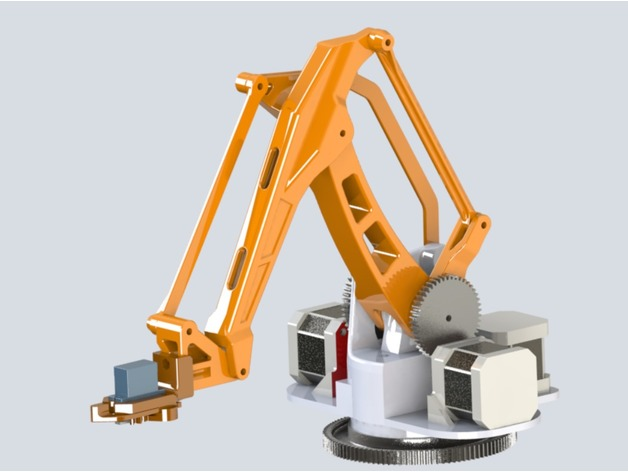
Robot/Robot_Arm_MK2_Plus__Stepper_Motor_in_Used__2520572/images/ba3c4c98c93af75635d910ba665bd638.jpg
