agustinlezcano/PFE/Robot/Robot_Arm_MK2_Plus__Stepper_Motor_in_Used__2520572/images/Base_Arm.jpg

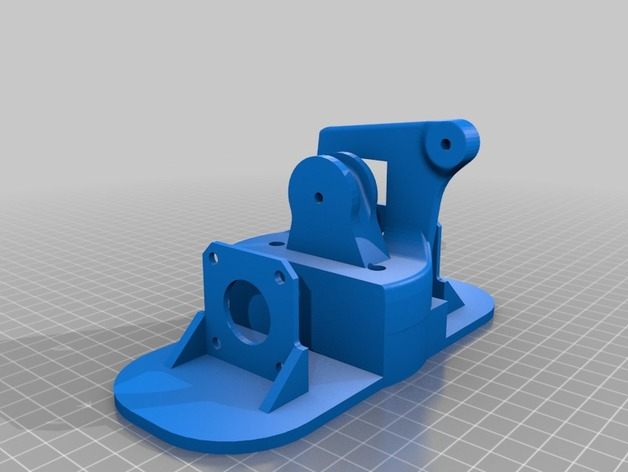
Robot/Robot_Arm_MK2_Plus__Stepper_Motor_in_Used__2520572/images/Base_Arm.jpg
