agustinlezcano/PFE/Robot/Robot_Arm_MK2_Plus__Stepper_Motor_in_Used__2520572/images/c1b3a357880c886fcf73daf56947afe0.jpg

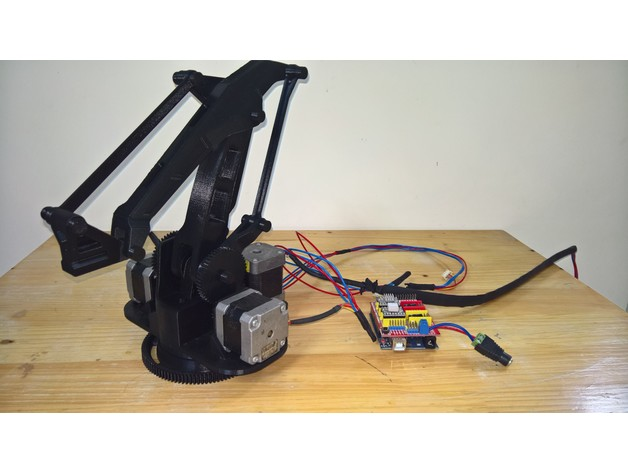
Robot/Robot_Arm_MK2_Plus__Stepper_Motor_in_Used__2520572/images/c1b3a357880c886fcf73daf56947afe0.jpg
