agustinlezcano/PFE/Robot/SolidEdge/Base2_Robot/STL/EBAmk2_002_mainarm.STL

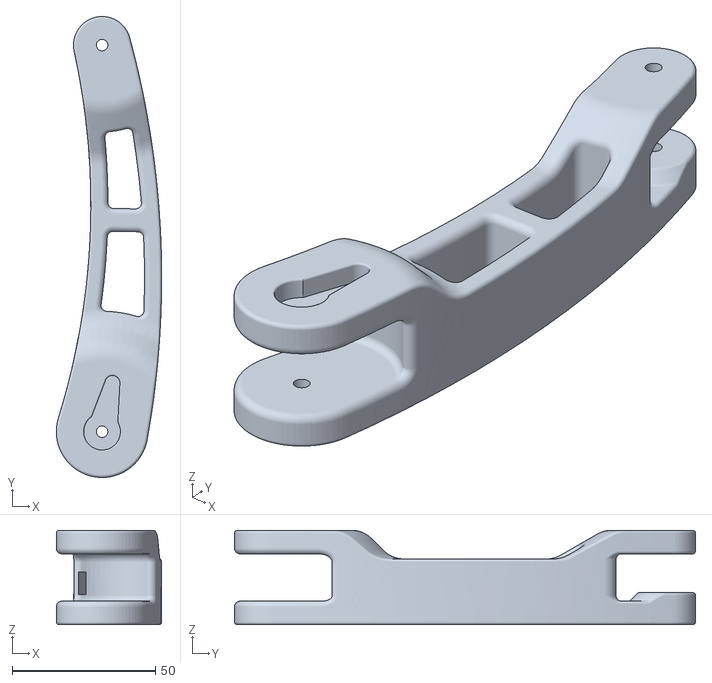
[picture p99: CAD file, 2023-07-12]
Robot/SolidEdge/Base2_Robot/STL/EBAmk2_002_mainarm.STL
36.8 x 161.0 x 33.0
