agustinlezcano/PFE/Robot/Robot_Arm_MK2_Plus__Stepper_Motor_in_Used__2520572/files/EBAmk2_015_claw_finger_dx.STL

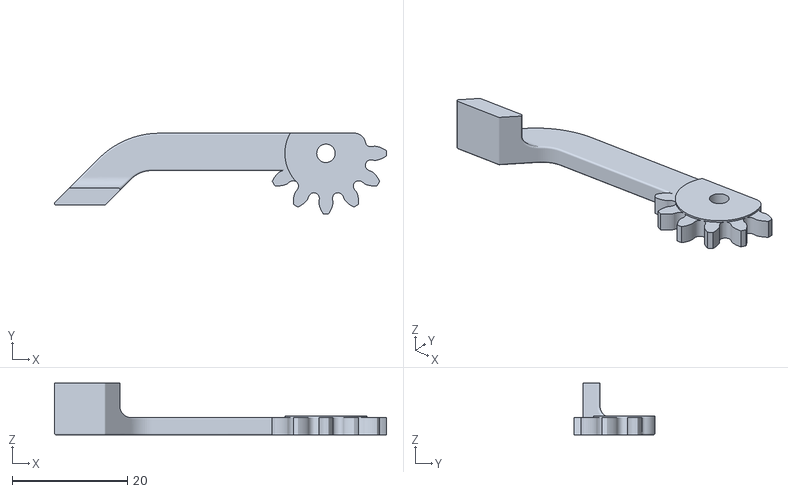
[picture p100: CAD file, 2023-07-12]
Robot/Robot_Arm_MK2_Plus__Stepper_Motor_in_Used__2520572/files/EBAmk2_015_claw_finger_dx.STL
57.6 x 14.0 x 9.00
