agustinlezcano/PFE/Robot/SolidEdge/Base2_Robot/STEP/gearMotor1.step

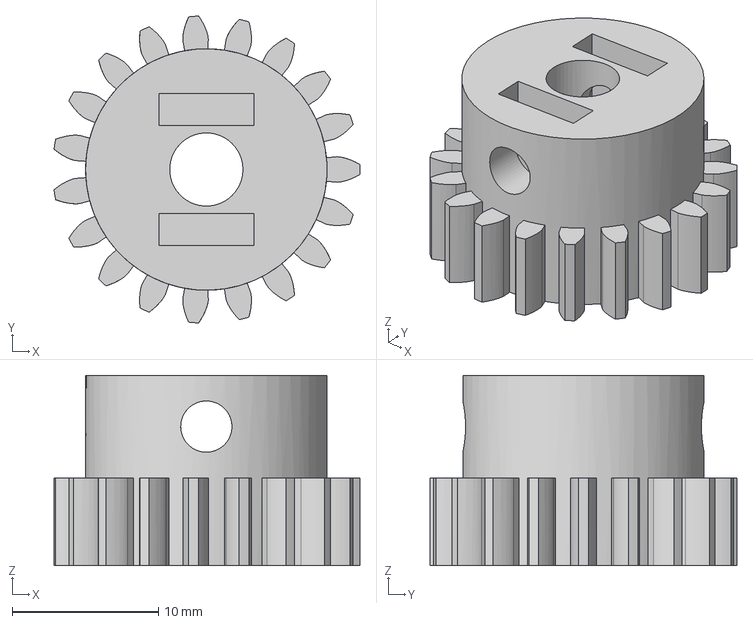
[picture p101: CAD file, 2025-11-12]
Robot/SolidEdge/Base2_Robot/STEP/gearMotor1.step
20.9 x 21.0 x 13.0 mm
