agustinlezcano/PFE/Robot/SolidEdge/Base2_Robot/STL/soporteAS5600.stl

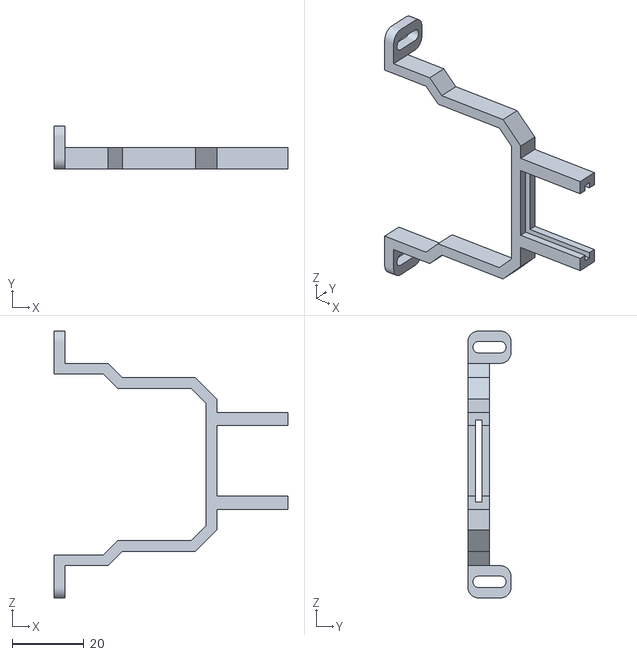
[picture p102: CAD file, 2025-10-26]
Robot/SolidEdge/Base2_Robot/STL/soporteAS5600.stl
65.1 x 12.0 x 74.3
