agustinlezcano/PFE/Robot/SolidEdge/soporteFicha220v.stl

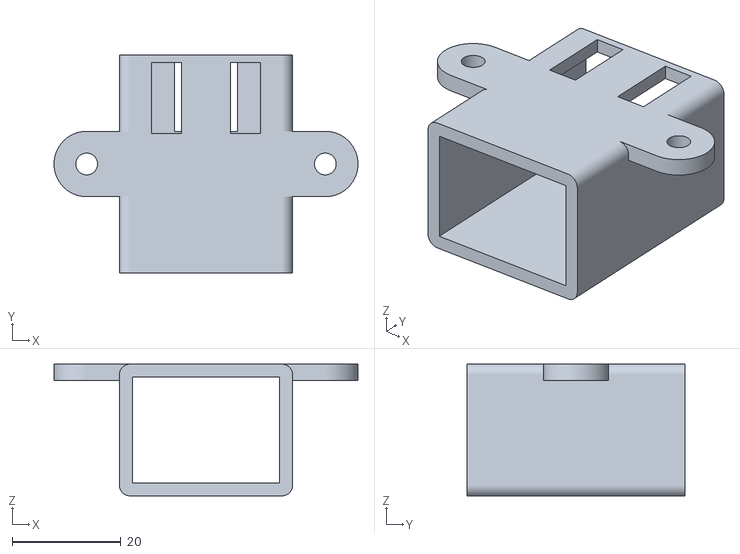
[picture p103: CAD file, 2025-12-01]
Robot/SolidEdge/soporteFicha220v.stl
55.8 x 40.0 x 24.2
