agustinlezcano/PFE/Robot/Robot_Arm_MK2_Plus__Stepper_Motor_in_Used__2520572/files/Left_gear.STL

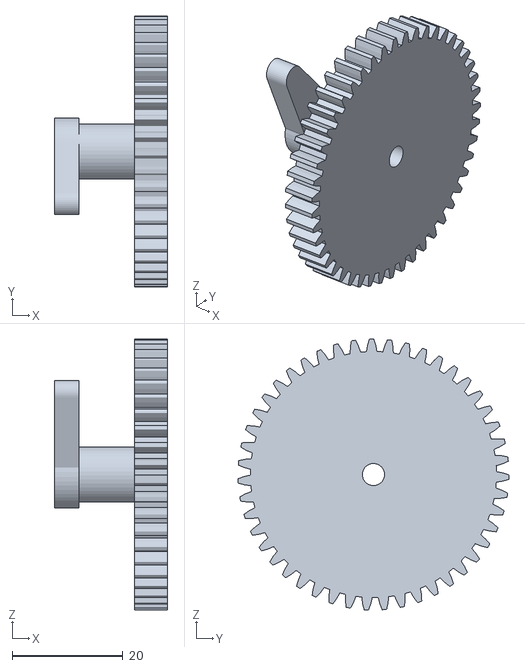
[picture p104: CAD file, 2023-07-12]
Robot/Robot_Arm_MK2_Plus__Stepper_Motor_in_Used__2520572/files/Left_gear.STL
20.5 x 49.0 x 49.0
