agustinlezcano/PFE/Robot/SolidEdge/Base2_Robot/STEP/gear2.step

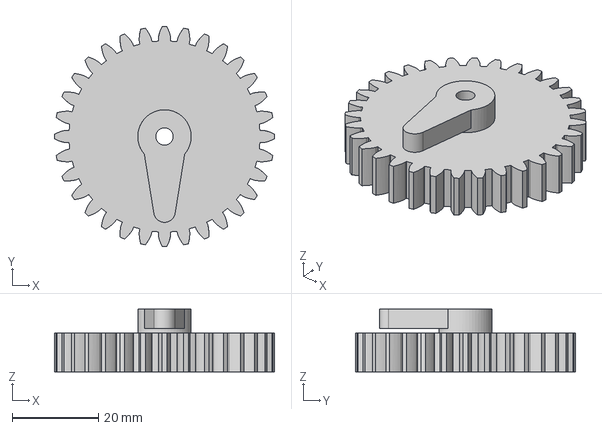
[picture p105: CAD file, 2025-11-04]
Robot/SolidEdge/Base2_Robot/STEP/gear2.step
51.0 x 51.0 x 14.5 mm
