agustinlezcano/PFE/Robot/SolidEdge/Base2_Robot/STL/engranajeMotor v1.stl

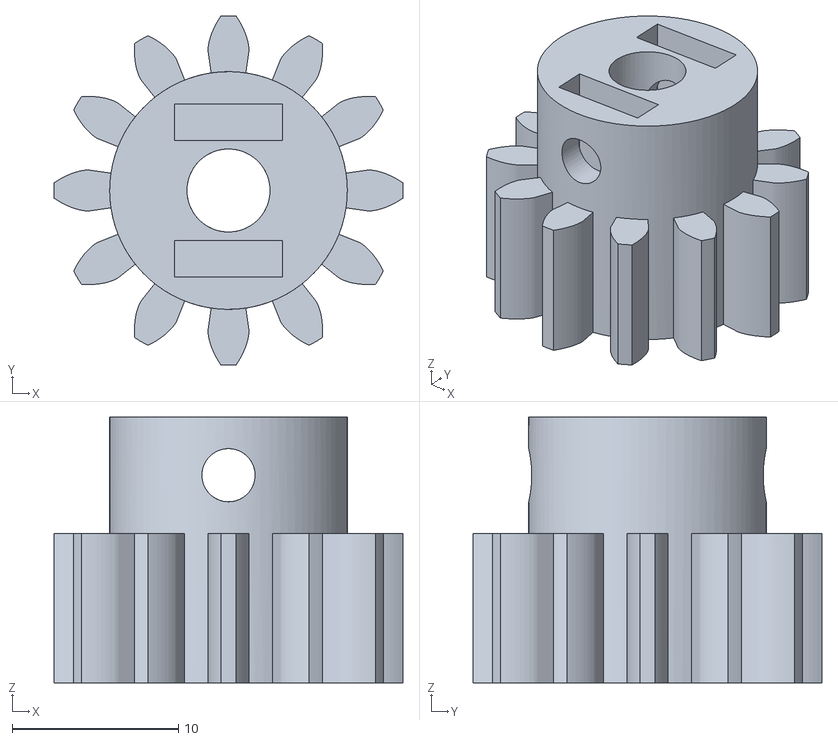
[picture p106: CAD file, 2025-10-26]
Robot/SolidEdge/Base2_Robot/STL/engranajeMotor v1.stl
21.0 x 21.0 x 16.0
