agustinlezcano/PFE/Robot/SolidEdge/soporte2Electroiman.stl

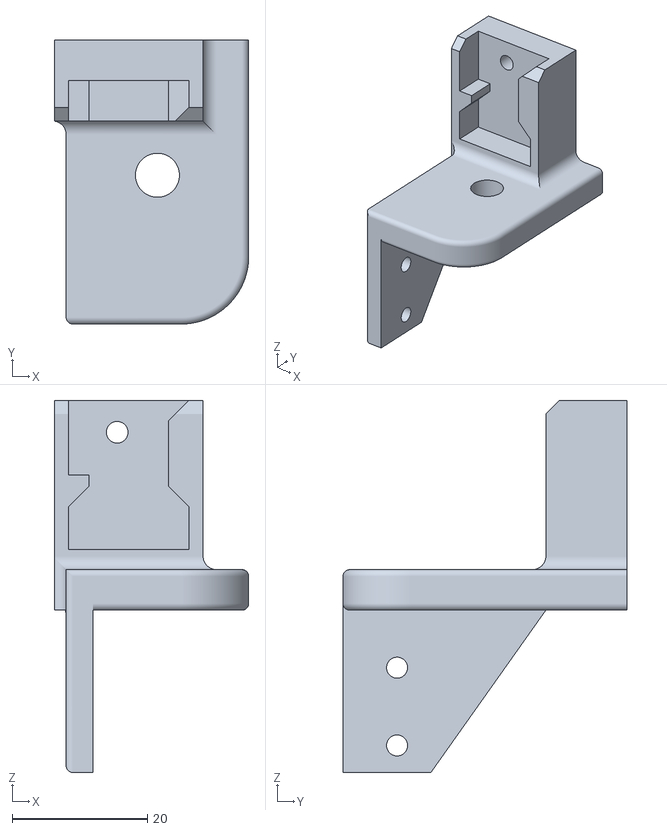
[picture p107: CAD file, 2025-10-26]
Robot/SolidEdge/soporte2Electroiman.stl
28.8 x 42.0 x 55.0
