agustinlezcano/PFE/Robot/Robot_Arm_MK2_Plus__Stepper_Motor_in_Used__2520572/files/EBAmk2_017_claw_finger_sx.STL

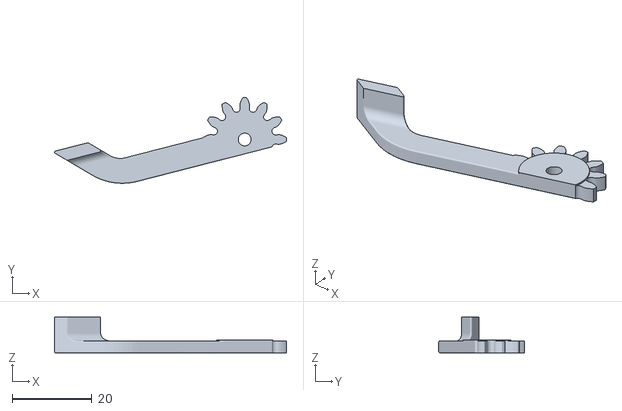
[picture p108: CAD file, 2023-07-12]
Robot/Robot_Arm_MK2_Plus__Stepper_Motor_in_Used__2520572/files/EBAmk2_017_claw_finger_sx.STL
58.3 x 21.5 x 9.00
