agustinlezcano/PFE/Robot/SolidEdge/Base2_Robot/STEP/gear1.step

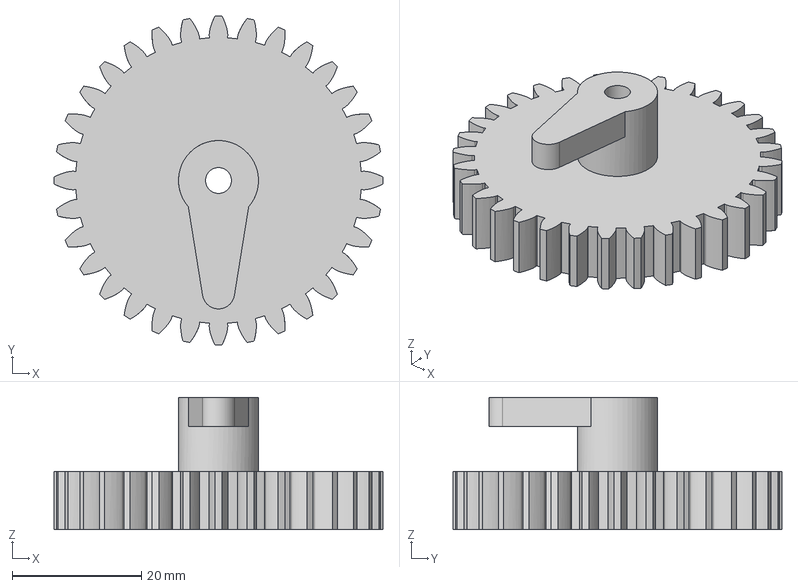
[picture p109: CAD file, 2025-11-04]
Robot/SolidEdge/Base2_Robot/STEP/gear1.step
51.0 x 51.0 x 20.5 mm
