agustinlezcano/PFE/Robot/SolidEdge/Base2_Robot/STL/tapa_ejes.stl

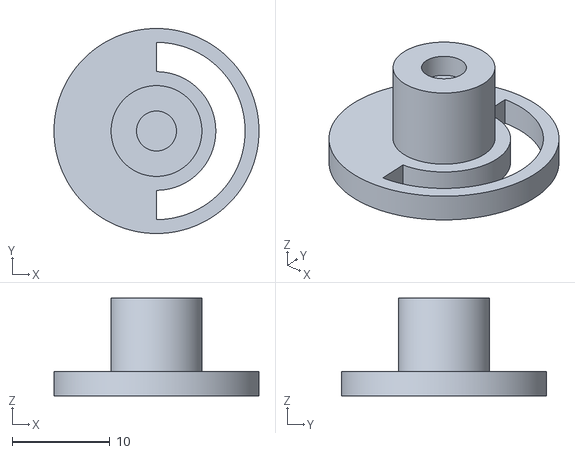
[picture p110: CAD file, 2025-10-26]
Robot/SolidEdge/Base2_Robot/STL/tapa_ejes.stl
21.0 x 21.0 x 10.0
