agustinlezcano/PFE/Robot/SolidEdge/soporteFuenteDC.stl

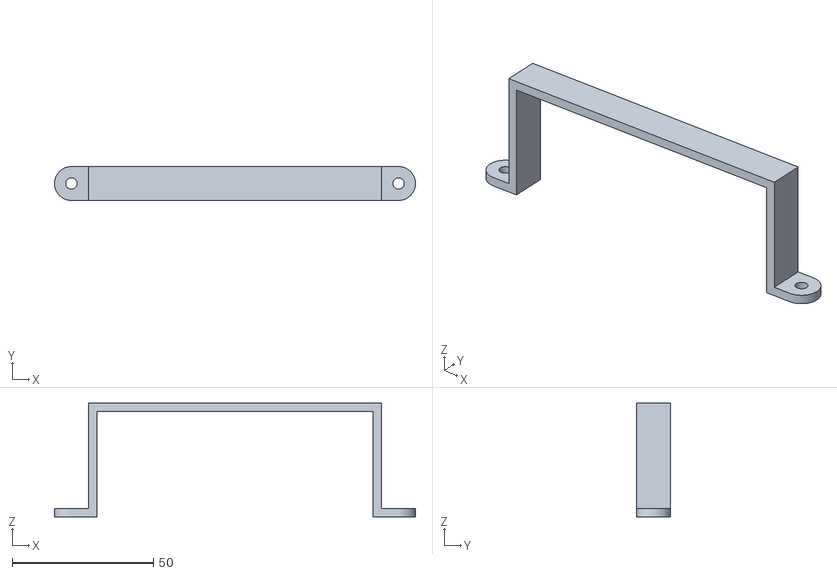
[picture p111: CAD file, 2025-10-26]
Robot/SolidEdge/soporteFuenteDC.stl
128.0 x 12.0 x 40.4
