agustinlezcano/PFE/Robot/Robot_Arm_MK2_Plus__Stepper_Motor_in_Used__2520572/files/EBAmk2_018_claw_gear_driven.STL

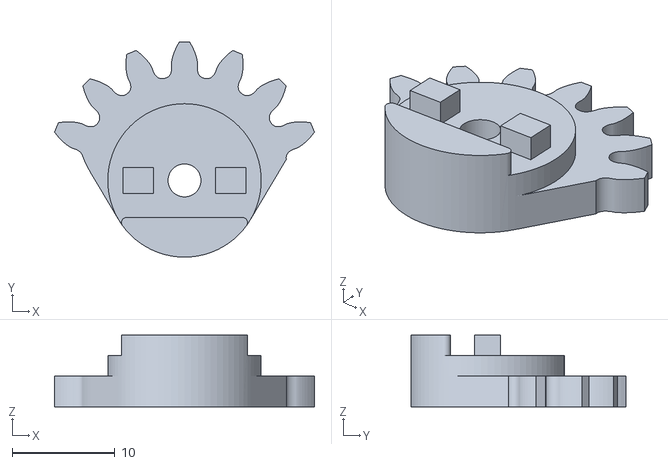
[picture p112: CAD file, 2023-07-12]
Robot/Robot_Arm_MK2_Plus__Stepper_Motor_in_Used__2520572/files/EBAmk2_018_claw_gear_driven.STL
25.3 x 21.0 x 7.00
