agustinlezcano/PFE/Robot/SolidEdge/Base2_Robot/STL/Base_Bearing_Ball2.STL

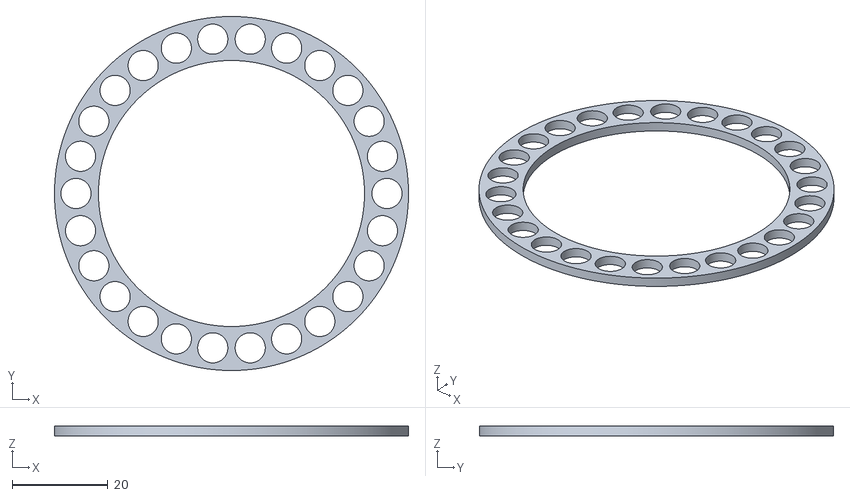
[picture p113: CAD file, 2025-08-30]
Robot/SolidEdge/Base2_Robot/STL/Base_Bearing_Ball2.STL
74.0 x 74.0 x 2.00
