agustinlezcano/PFE/Robot/SolidEdge/pataMaderaBase.stl

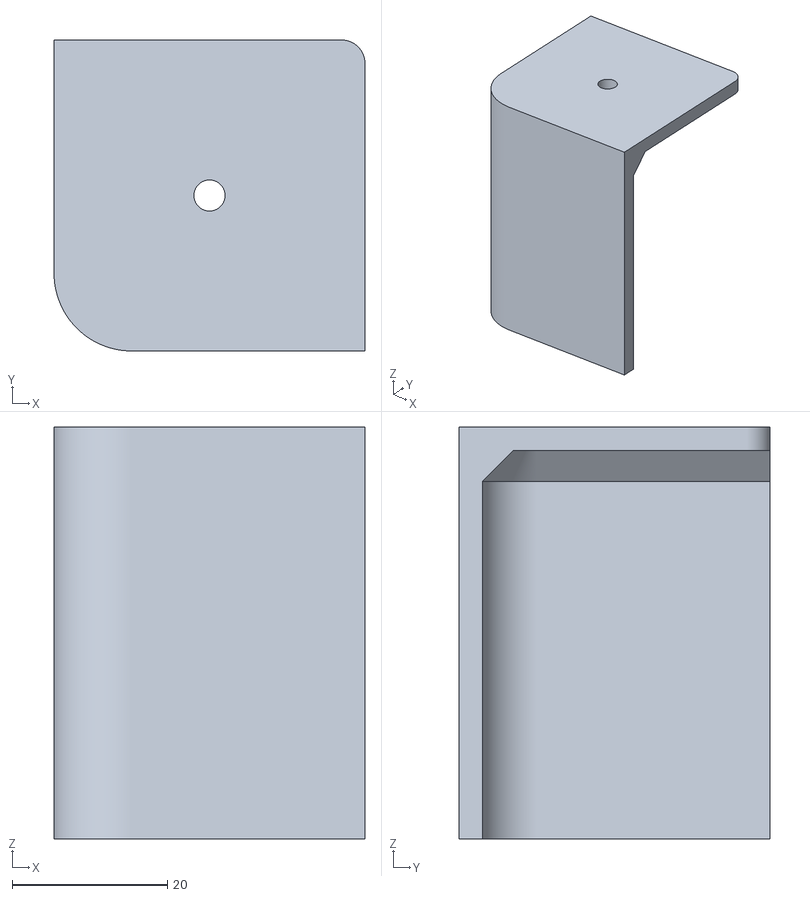
[picture p114: CAD file, 2025-10-26]
Robot/SolidEdge/pataMaderaBase.stl
40.0 x 40.0 x 53.0
