agustinlezcano/PFE/Robot/Robot_Arm_MK2_Plus__Stepper_Motor_in_Used__2520572/files/EBAmk2_016_claw_gear_drive.STL

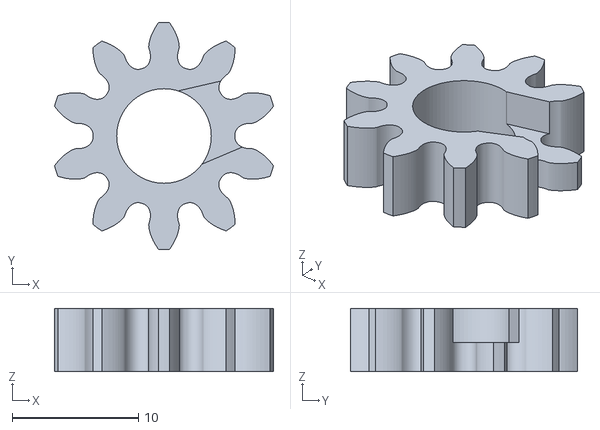
[picture p115: CAD file, 2023-07-12]
Robot/Robot_Arm_MK2_Plus__Stepper_Motor_in_Used__2520572/files/EBAmk2_016_claw_gear_drive.STL
17.4 x 18.0 x 5.00
