agustinlezcano/PFE/Robot/SolidEdge/Base2_Robot/STL/soporteSensorHall.stl

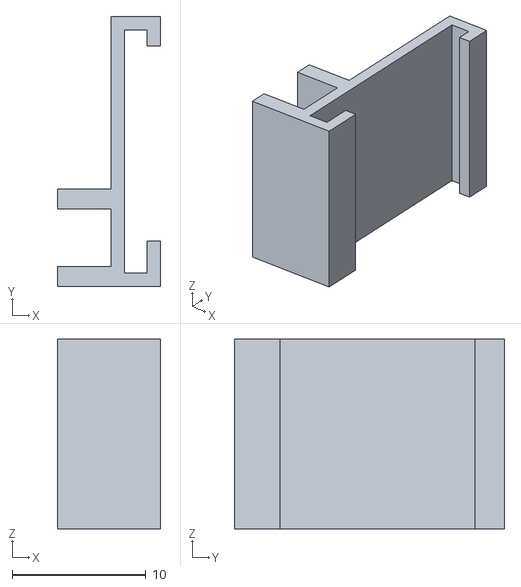
[picture p116: CAD file, 2025-08-30]
Robot/SolidEdge/Base2_Robot/STL/soporteSensorHall.stl
7.70 x 20.2 x 14.2
