agustinlezcano/PFE/Robot/SolidEdge/Base2_Robot/STL/EBAmk2_004_link135.STL

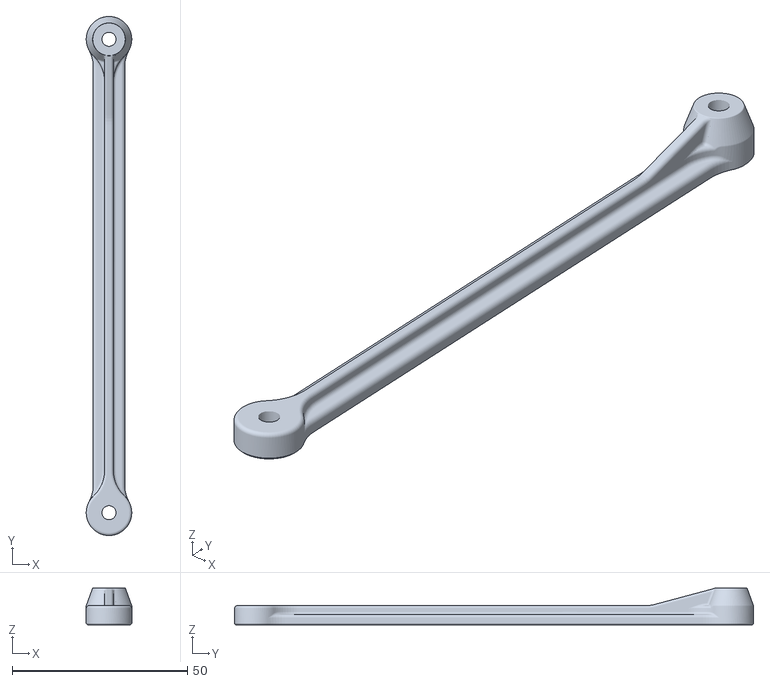
[picture p117: CAD file, 2023-07-12]
Robot/SolidEdge/Base2_Robot/STL/EBAmk2_004_link135.STL
13.0 x 148.0 x 10.5
