agustinlezcano/PFE/Robot/SolidEdge/Base2_Robot/STL/Base_Arm.STL

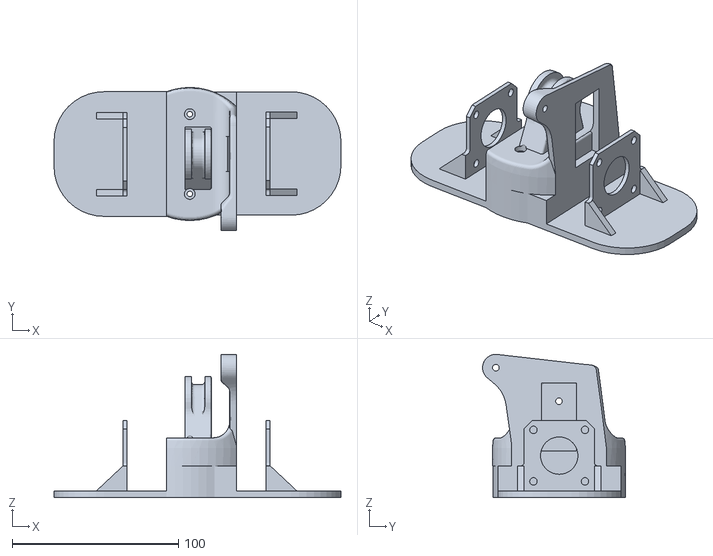
[picture p118: CAD file, 2023-07-12]
Robot/SolidEdge/Base2_Robot/STL/Base_Arm.STL
172.7 x 86.0 x 86.2
