agustinlezcano/PFE/Robot/SolidEdge/Base2_Robot/STL/EBAmk2_003_varm.STL

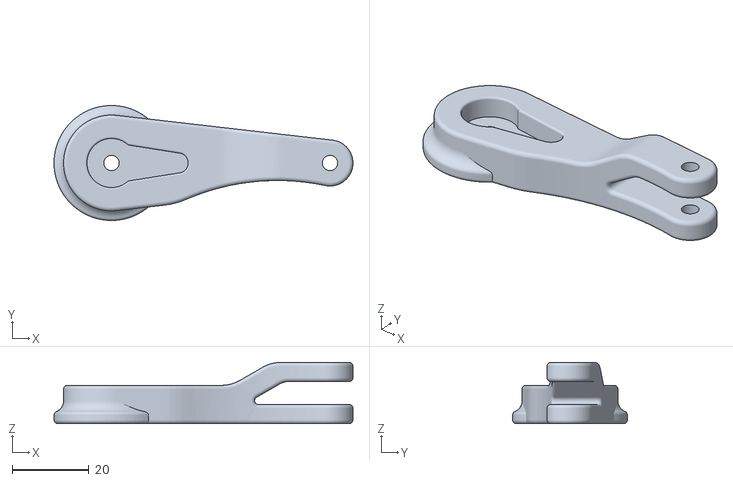
[picture p119: CAD file, 2023-07-12]
Robot/SolidEdge/Base2_Robot/STL/EBAmk2_003_varm.STL
78.0 x 30.0 x 16.0
