agustinlezcano/PFE/Robot/SolidEdge/Base2_Robot/STL/finalholder.STL

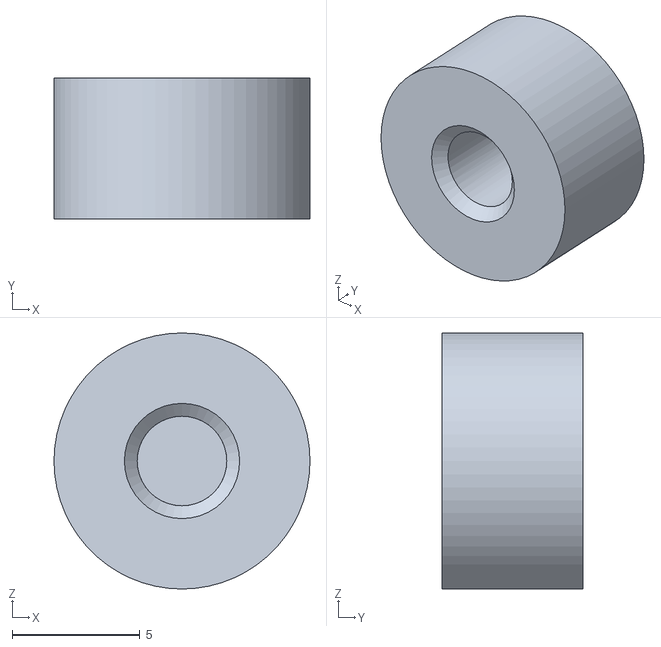
[picture p120: CAD file, 2023-07-12]
Robot/SolidEdge/Base2_Robot/STL/finalholder.STL
10.0 x 5.50 x 10.0
