agustinlezcano/PFE/Robot/SolidEdge/Base2_Robot/STL/Stepper_Gear.STL

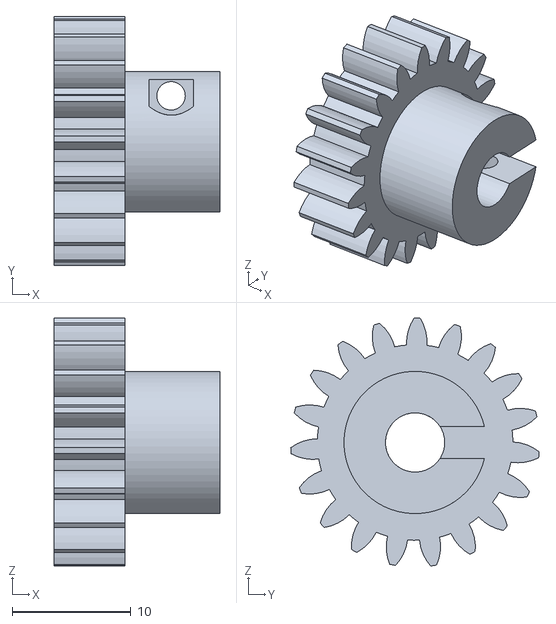
[picture p121: CAD file, 2023-07-12]
Robot/SolidEdge/Base2_Robot/STL/Stepper_Gear.STL
14.0 x 21.0 x 20.9
