agustinlezcano/PFE/Robot/SolidEdge/Base2_Robot/STL/EBAmk2_014_claw_base.STL

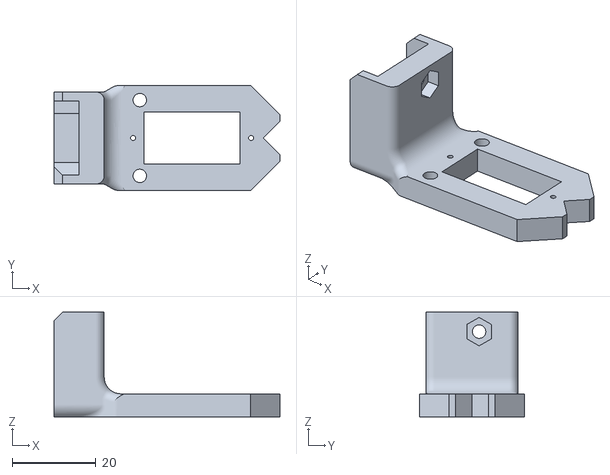
[picture p122: CAD file, 2023-07-12]
Robot/SolidEdge/Base2_Robot/STL/EBAmk2_014_claw_base.STL
54.0 x 25.0 x 25.0
