agustinlezcano/PFE/Robot/SolidEdge/Base2_Robot/STL/Robot_Base_Low_Gear.STL

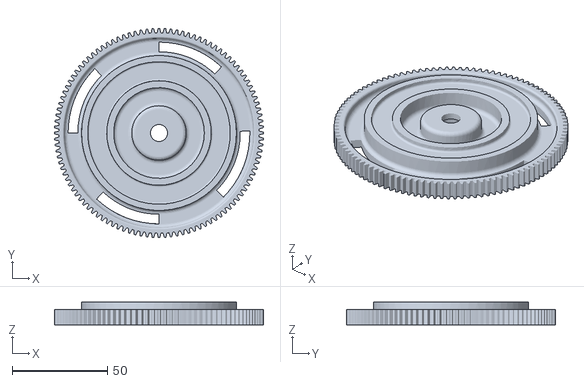
[picture p123: CAD file, 2023-07-12]
Robot/SolidEdge/Base2_Robot/STL/Robot_Base_Low_Gear.STL
110.0 x 110.0 x 12.0
