agustinlezcano/PFE/Robot/SolidEdge/Base2_Robot/STL/EBAmk2_006_horarm__.STL

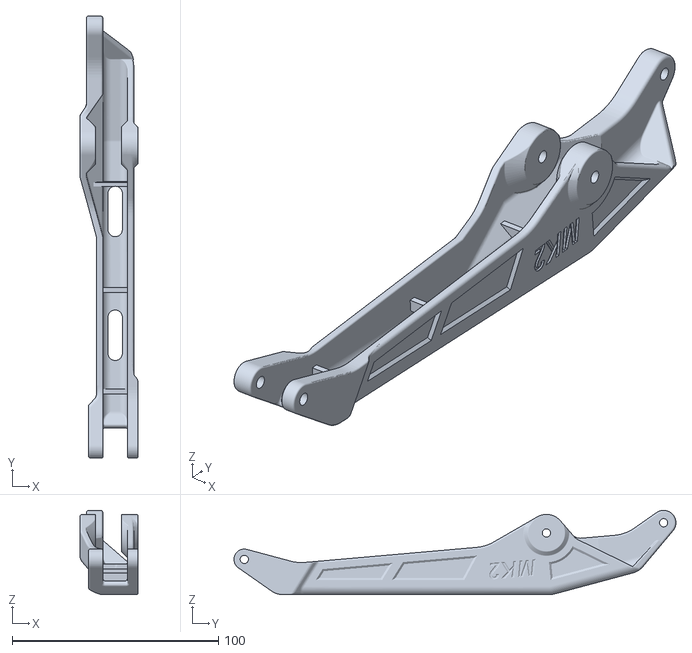
[picture p124: CAD file, 2023-07-12]
Robot/SolidEdge/Base2_Robot/STL/EBAmk2_006_horarm__.STL
28.0 x 214.2 x 40.9
