agustinlezcano/PFE/Robot/SolidEdge/Base2_Robot/STL/EBAmk2_007_trialink.STL

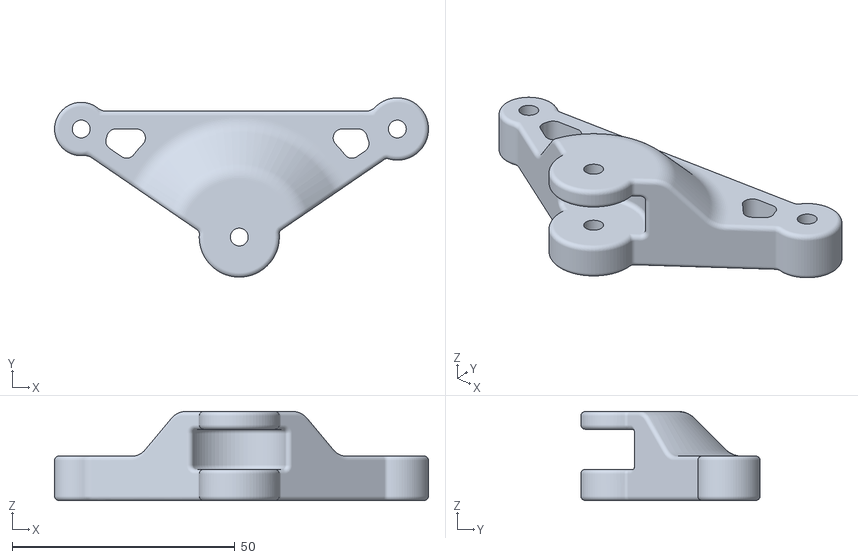
[picture p125: CAD file, 2023-07-12]
Robot/SolidEdge/Base2_Robot/STL/EBAmk2_007_trialink.STL
84.0 x 40.3 x 20.0
