agustinlezcano/PFE/Robot/SolidEdge/Base2_Robot/STL/EBAmk2_009_trialinkfront.STL

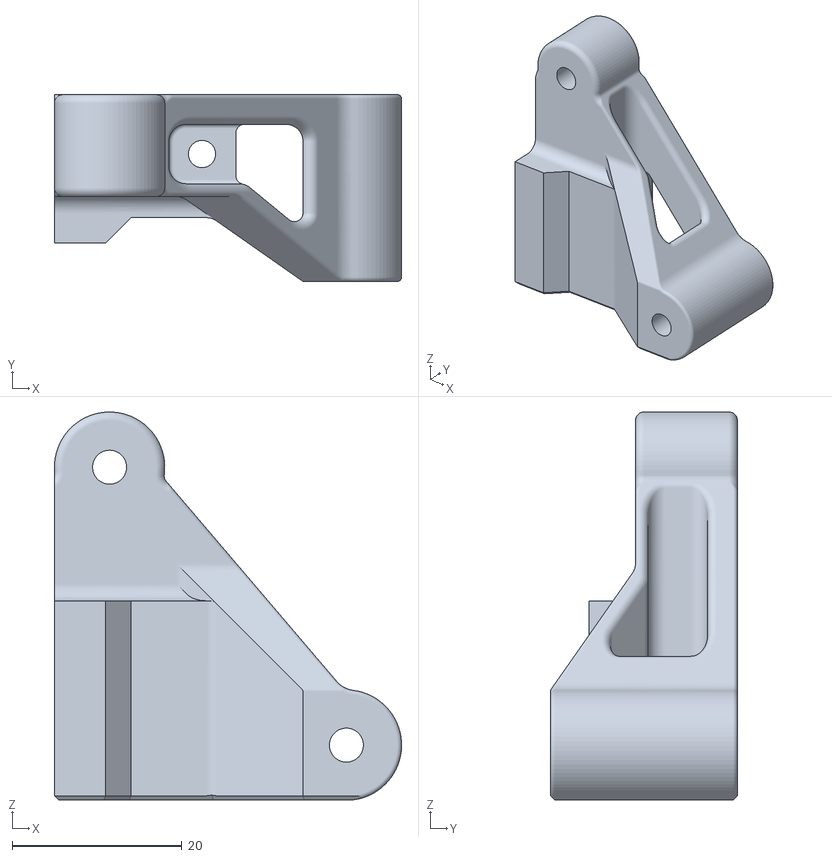
[picture p126: CAD file, 2023-07-12]
Robot/SolidEdge/Base2_Robot/STL/EBAmk2_009_trialinkfront.STL
40.9 x 22.0 x 45.7
