agustinlezcano/PFE/Robot/SolidEdge/Base2_Robot/STL/EBAmk2_006_horarm_plate.STL

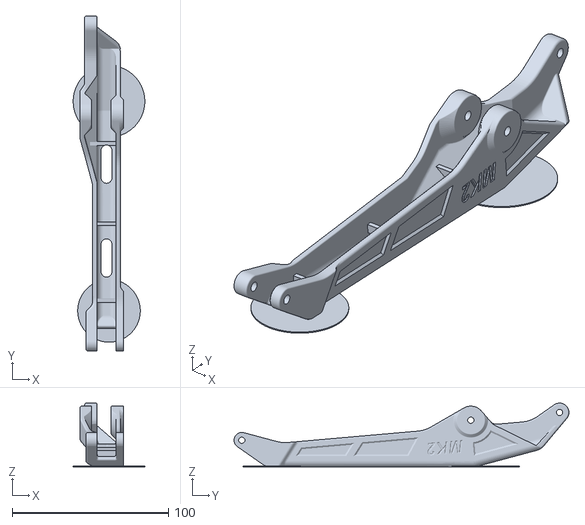
[picture p127: CAD file, 2023-07-12]
Robot/SolidEdge/Base2_Robot/STL/EBAmk2_006_horarm_plate.STL
45.8 x 214.2 x 40.9
