agustinlezcano/PFE/Robot/SolidEdge/Base2_Robot/STL/Robot_Base_Low.STL

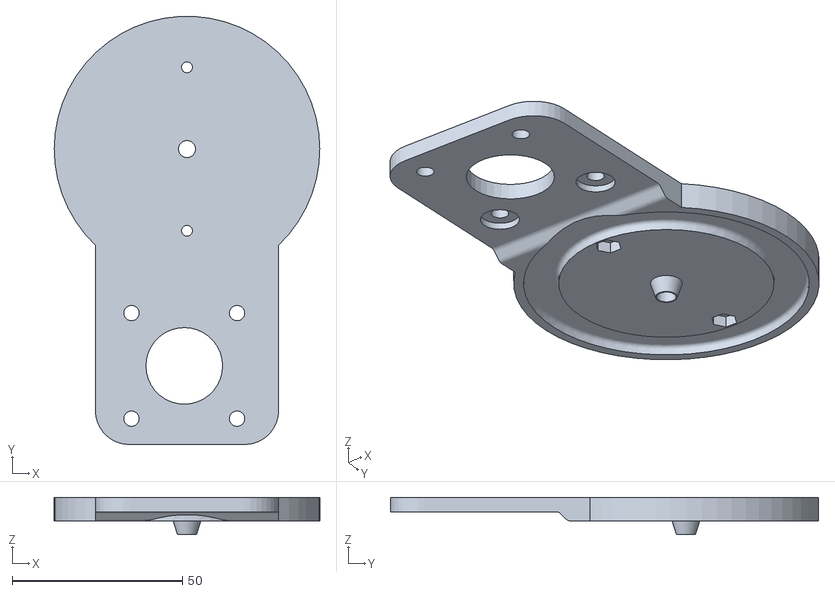
[picture p128: CAD file, 2023-07-12]
Robot/SolidEdge/Base2_Robot/STL/Robot_Base_Low.STL
78.0 x 125.7 x 11.0
