agustinlezcano/PFE/Robot/SolidEdge/Base2_Robot/STL/Base_Bearing_Ball.STL

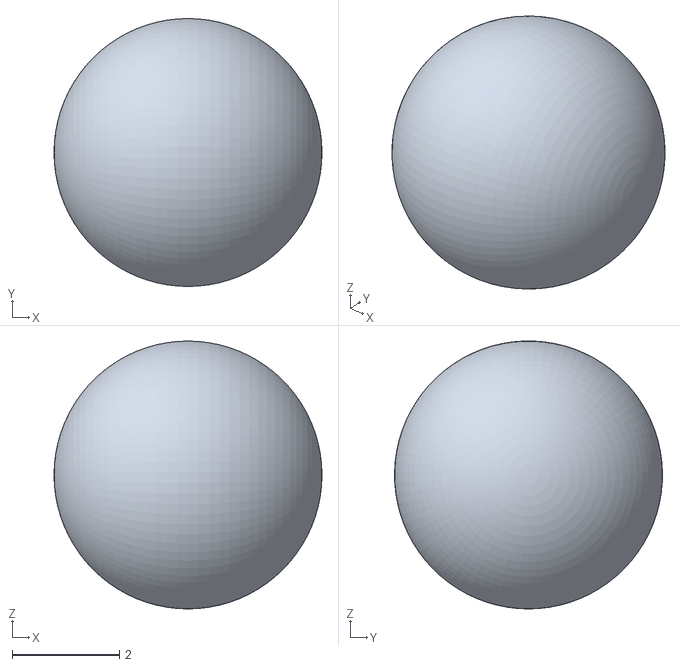
[picture p129: CAD file, 2023-07-12]
Robot/SolidEdge/Base2_Robot/STL/Base_Bearing_Ball.STL
5.00 x 5.00 x 5.00
