agustinlezcano/PFE/Robot/SolidEdge/Base2_Robot/STL/EBAmk2_008_link147_new.STL

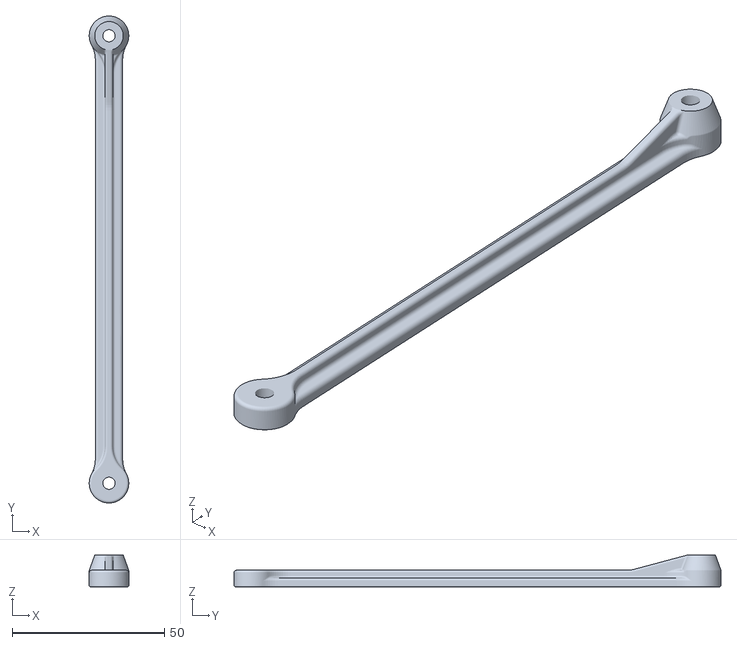
[picture p130: CAD file, 2023-07-12]
Robot/SolidEdge/Base2_Robot/STL/EBAmk2_008_link147_new.STL
13.0 x 160.0 x 10.5
