agustinlezcano/PFE/Robot/SolidEdge/Base2_Robot/STL/Base_Bearing_Holder.STL

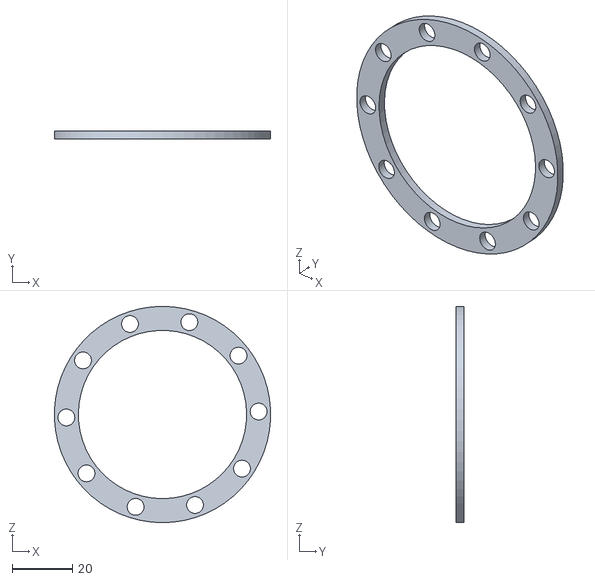
[picture p131: CAD file, 2023-07-12]
Robot/SolidEdge/Base2_Robot/STL/Base_Bearing_Holder.STL
71.9 x 2.50 x 72.0
