agustinlezcano/PFE/Robot/SolidEdge/Base2_Robot/STL/EBAmk2_005_link135angled.STL

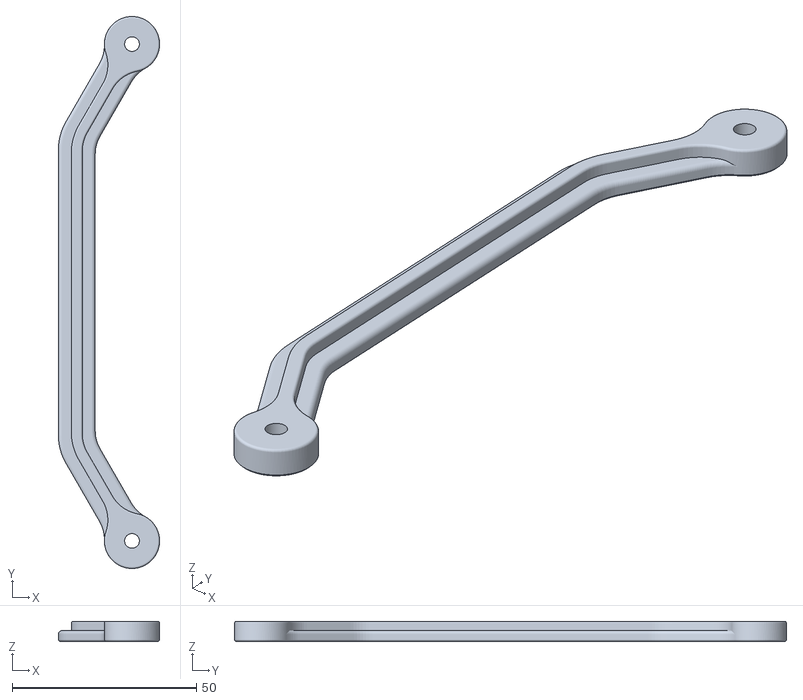
[picture p132: CAD file, 2023-07-12]
Robot/SolidEdge/Base2_Robot/STL/EBAmk2_005_link135angled.STL
27.5 x 150.0 x 5.50
