agustinlezcano/PFE/(list of files, cad)

Other CAD files:
Robot/SolidEdge/Base2_Robot/STEP/gearMotor.step
KiCAD/External 3D Model/Screw Terminal Block 5mm Blue 2-way.step
KiCAD/External 3D Model/Screw Terminal Block 5mm Blue 3-way.step
Robot/SolidEdge/Base2_Robot/Robot_Base_Low_Gear.f3d
Robot/SolidEdge/Base2_Robot/STL/gear1.stl
Robot/SolidEdge/Base2_Robot/STL/gear2.stl
Robot/SolidEdge/Base2_Robot/STL/gearMotor.stl
Robot/SolidEdge/Base2_Robot/STL/screw_holder2.STL
Robot/SolidEdge/Base2_Robot/engranaje_motor.f3d
