agustinlezcano/PFE/Informe/img/yolo_results.png

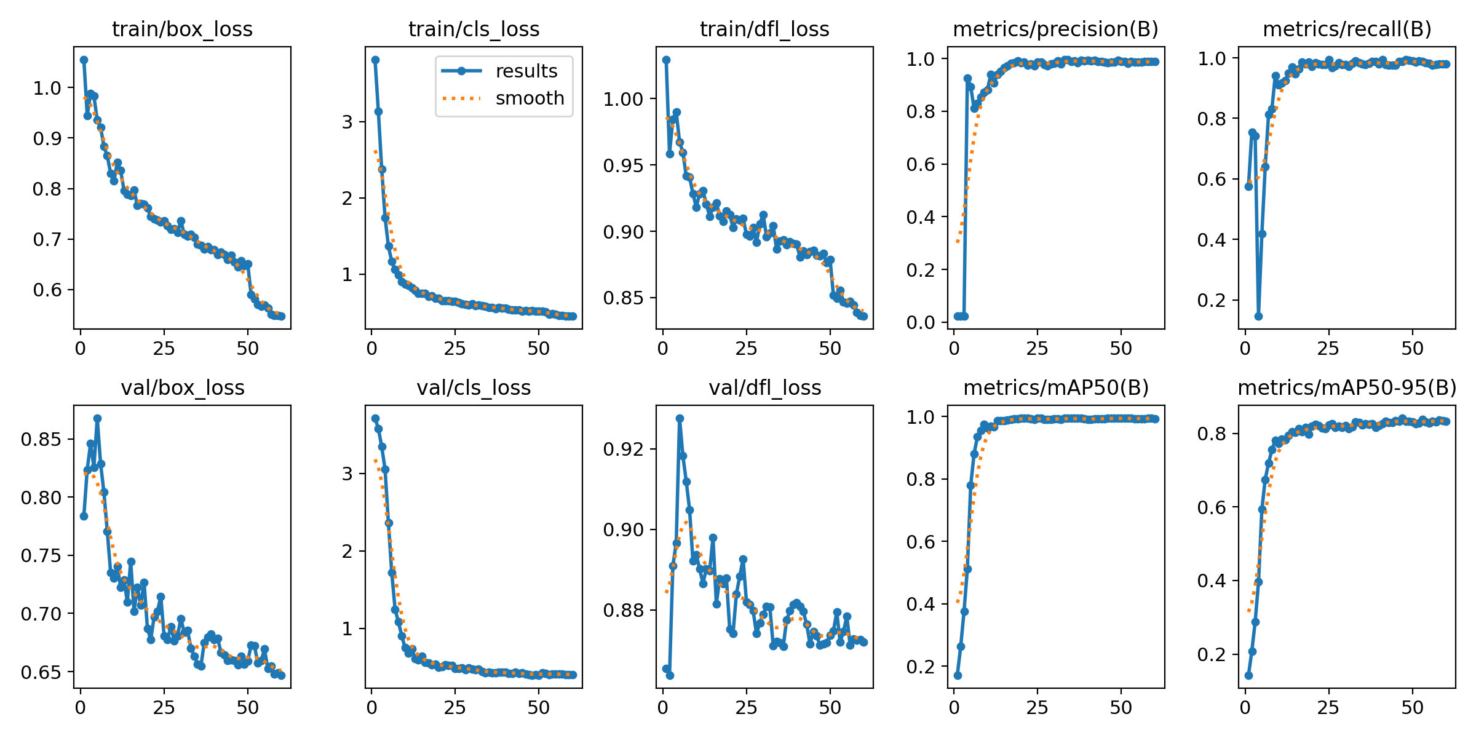
Informe/img/yolo_results.png
