agustinlezcano/PFE/Robot/Robot_Asm_medidas.pdf

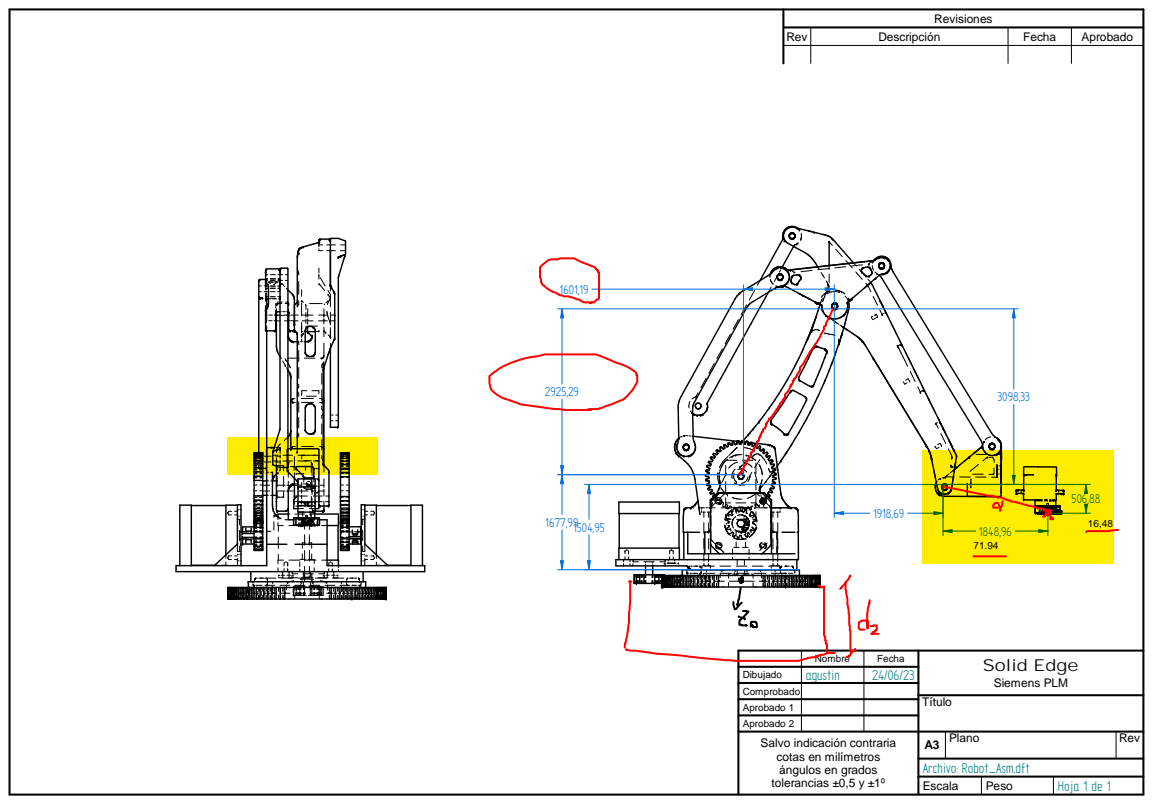
[picture p134: page 1]
Título; Archivo: Robot_Asm.dft; Escala; Peso; Hoja 1 de 1

Revisiones

Rev | Descripción | Fecha | Aprobado

Nombre | 24/06/23 Fecha | Solid Edge Siemens PLM

Dibujado | agustin

Comprobado
Aprobado 1
Aprobado 2
Salvo indicación contraria cotas en milímetros ángulos en grados tolerancias ±0,5 y ±1º | A3 | Plano | Rev
