agustinlezcano/PFE/Robot/EBAmk2_002_mainarm.pdf

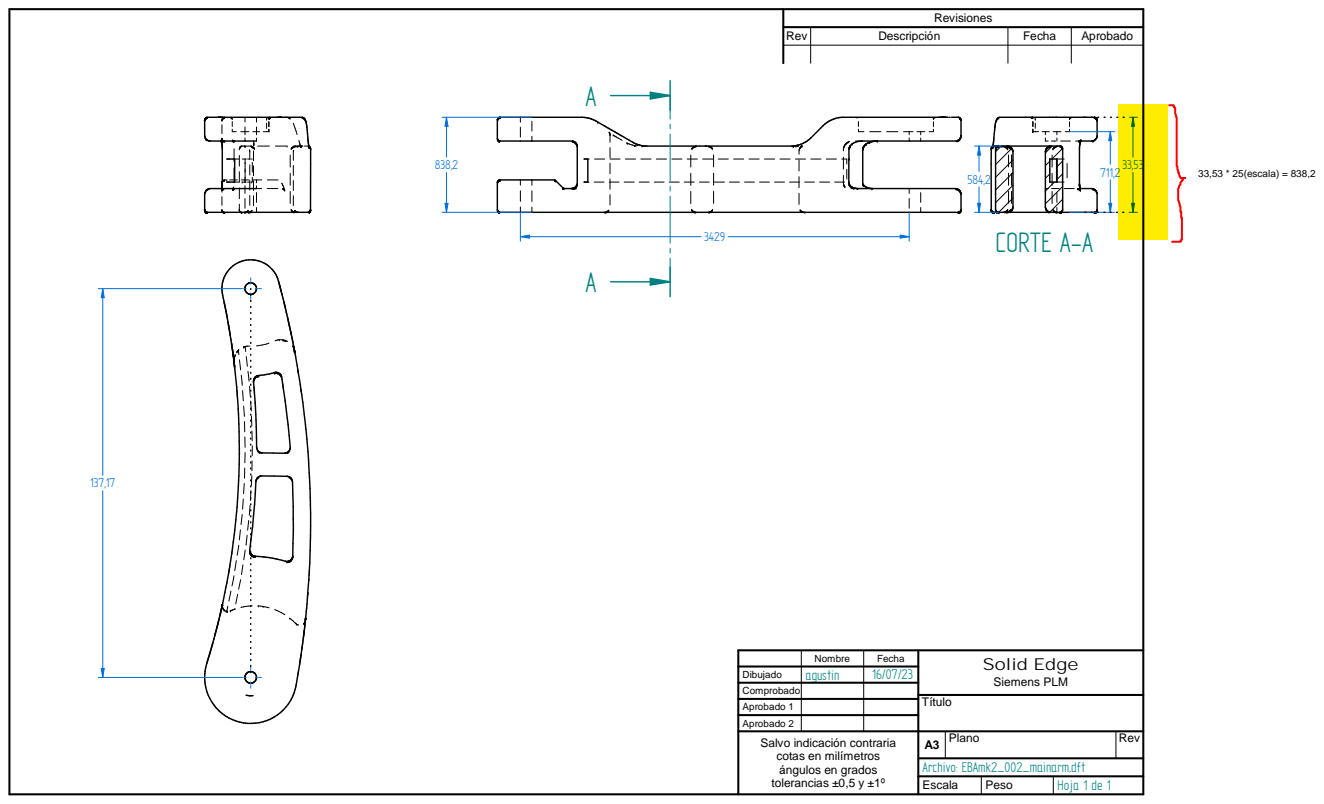
[picture p135: page 1]
Título; Archivo: EBAmk2_002_mainarm.dft; Escala; Peso; Hoja 1 de 1; CORTE A-A

Revisiones

Rev | Descripción | Fecha | Aprobado

Nombre | 16/07/23 Fecha | Solid Edge Siemens PLM

Dibujado | agustin

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
