agustinlezcano/PFE/KiCAD/PFE_solenoide.kicad_pcb

## KiCad design KiCAD/PFE_solenoide.kicad_pcb (2026-03-02)

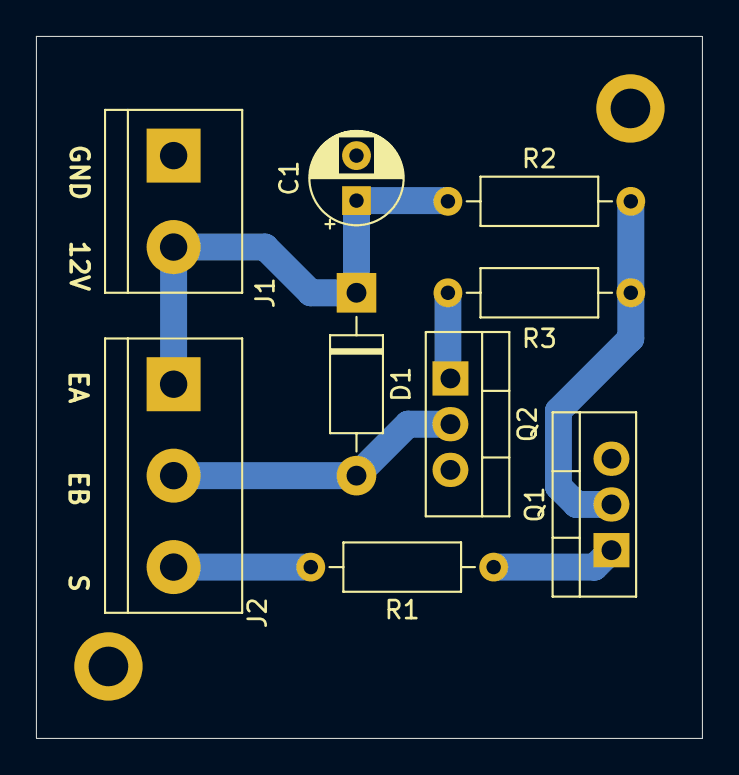
[picture p136: board PFE_solenoide.kicad_pcb from above]

Board: 2 copper layers, 37.0 x 39.0 mm, 11 parts (0 on the bottom side), 7 nets.

Parts:
C1: C; CP_Radial_D5.0mm_P2.50mm
D1: 1N4001; D_DO-41_SOD81_P10.16mm_Horizontal
H1, H2: MountingHole_2.2mm_M2_ISO14580_Pad
J1: Vin; TerminalBlock_bornier-2_P5.08mm
J2: E+uC; TerminalBlock_bornier-3_P5.08mm
Q1: NPN; TO-220-3_Vertical
Q2: NMOS; TO-220-3_Vertical
R1: 10k; R_Axial_DIN0207_L6.3mm_D2.5mm_P10.16mm_Horizontal
R2: 47k; R_Axial_DIN0207_L6.3mm_D2.5mm_P10.16mm_Horizontal
R3: 330; R_Axial_DIN0207_L6.3mm_D2.5mm_P10.16mm_Horizontal

Connections:
GND: C1.2, H1.1, H2.2, J1.1, Q1.3 (E), Q2.3 (S)
unnamed: D1.2 (A), J2.2, Q2.2 (G)
unnamed: C1.1, D1.1 (K), J1.2, J2.1, R2.1
unnamed: J2.3, R1.2
unnamed: Q1.1 (C), R1.1
unnamed: Q1.2 (B), R2.2, R3.1
unnamed: Q2.1 (D), R3.2
