agustinlezcano/PFE/ROS/orchestrator-project/src/robot_control/robot_control/motor.py

class Motor:
    def __init__(self, rpm: float):
        """
        Initialize the Motor class with RPM.
        """
        self.rpm = rpm

    def start(self) -> None:
        pass

    def stop(self) -> None:
        pass
