agustinlezcano/PFE/ROS/orchestrator-project/src/robot_control/robot_control/robot.py

class Robot:
    def __init__(self, xObj: float, vObj: float, aObj: float):
        """
        Initialize the Robot class with position, velocity, and acceleration.
        """
        self.xObj = xObj
        self.vObj = vObj
        self.aObj = aObj

    def reportFailure(self) -> None:
        pass

    def receiveCommand(self, command: str) -> None:
        pass

    def currentPosition(self) -> float:
        pass

    def targetReached(self) -> bool:
        pass

    def closestTarget(self) -> float:
        pass

    def isPathReachable(self) -> bool:
        pass
