agustinlezcano/PFE/ROS/orchestrator-project/src/robot_control/robot_control/database_manager.py

class DatabaseManager:
    def makeQuery(self, query: str) -> None:
        pass

    def retrieveStock(self, stockId: str) -> dict:
        pass

    def retrieveDimensions(self, itemId: str) -> dict:
        pass

    def deliverOrders(self) -> str:
        pass

    def pendingOrders(self) -> str:
        pass
