agustinlezcano/PFE/ROS/orchestrator-project/src/robot_control/robot_control/image_manager.py

class ImageManager:
    def __init__(self, target: str, targetPositions: dict):
        """
        Initialize the ImageManager class with target and target positions.
        """
        self.target = target
        self.targetPositions = targetPositions

    def isTargetFound(self) -> bool:
        pass

    def start(self) -> None:
        pass

    def stop(self) -> None:
        pass

    def processImage(self) -> None:
        pass
