agustinlezcano/PFE/(commit log)

2023-07-12 Commit inicial
    [Base_Arm.STL, Base_Bearing_Ball.STL, Base_Bearing_Holder.STL, EBAmk2_002_mainarm.STL, EBAmk2_003_varm.STL, EBAmk2_004_link135.STL, EBAmk2_005_link135angled.STL, EBAmk2_006_horarm__.STL]
2023-07-25 Diseño 3D SolidEdge
    [RobotCompleto.cfg]
2024-10-30 Estructura inicial
    [Base_Arm.STL, Base_Bearing_Ball.STL, Base_Bearing_Holder.STL, EBAmk2_002_mainarm.STL, EBAmk2_003_varm.STL, EBAmk2_004_link135.STL, EBAmk2_005_link135angled.STL, EBAmk2_006_horarm__.STL]
2024-12-31 versiones de prueba
2025-01-28 refactor kinematics algorithms
2025-02-17 updated img/gui/kinematics
    [RobotCompleto.cfg]
2025-02-22 added joint angles validation
2025-04-30 (#20) fix LSPB generation
    [communication.py, database_manager.py, image_manager.py, main.py, traj_utils.py]
2025-06-16 (#21) fix utils & communication modules
    [communication.py, main.py, testCommunication.py, traj_utils.py]
2025-08-30 Correccion dimensiones robot y verificacion de tool en la c_inv
2025-08-30 Piezas 3D actualizadas a Robot con PaP
    [AS5600_con_soporte.cfg, Base_Arm.STL, Base_Bearing_Ball.STL, Base_Bearing_Ball2.STL, Base_Bearing_Holder.STL, EBAmk2_002_mainarm.STL, EBAmk2_003_varm.STL, EBAmk2_004_link135.STL]
2025-10-26 Nuevos soportes, robot primitivo y modificacion engranajes motores
    [RobotCompleto.cfg, RobotCompleto2.cfg, RobotPrimitivo.cfg, base2.cfg, engranajeMotor v1.stl, engranaje_motor.stl, gear1.STL, gear1.stl]
2025-11-04 Robot con PaP en Solid
    [RobotCompleto2.cfg, base2b.cfg, gear1.step, gear2.step, gearMotor.step]
2025-11-12 Pequeños cambios 3D
    [RobotCompleto2.cfg, gearMotor1.step]
2025-12-01 Modelo de YOLOv11
2025-12-01 Matlab, plano Z=0 para encontrar interseccion con el piso
2025-12-01 Ajuste en ficha220, se creo un pie para camara y stl de engranaje motor
    [gearMotor.stl, soporteFicha220v.stl]
2025-12-08 Calculo del espacio de trabajo teorico y real + cambios minimos en 3D
    [RobotCompleto2.cfg, Tabla_angulos_Robot.csv, matriz.csv]
2026-03-02 Create KiCAD folder
2026-03-02 Added KiCAD files
    [PFE_solenoide.kicad_pcb, PFE_solenoide.kicad_sch, Screw Terminal Block 5mm Blue 2-way.step, Screw Terminal Block 5mm Blue 3-way.step]
2026-03-02 Mover archivos a carpeta KiCAD
    [PFE_solenoide.kicad_pcb, PFE_solenoide.kicad_sch, Screw Terminal Block 5mm Blue 2-way.step, Screw Terminal Block 5mm Blue 3-way.step]
